Tony-LeoN/LLM-CADCoder/DataFlow/README.md

# DataFlow Stage Contract

`DataFlow` stores generated artifacts, not source code. Keep source code under `src/vlm_cadcoder`.

For stage-by-stage processing commands, see [`COMMANDS.md`](COMMANDS.md).

## Stages

1. `01.RawPDFWithSTEP`
   - Input PDF drawings and paired STEP/STP ground truth.
   - File stems should match when possible.

2. `02.RawPNG`
   - Rendered PDF pages.
   - Each sample should contain `page_001_600dpi.png` and `page_001_600dpi.meta.json`.

3. `03.LayoutAnalysis`
   - Page-level layout results: title blocks, notes, removable tables, page borders, inner frame strips, and corner metadata boxes.

4. `04.CleanPNG`
   - Cleaned page or view images after denoising, binarization, or annotation removal.
   - The first implementation keeps the original page size and whites out removable layout regions.
   - Removed regions should still be preserved as crops when they contain useful manufacturing knowledge, such as hole tables or title blocks.

5. `05.ViewDetection`
   - Detected view bounding boxes and view-region metadata.

6. `06.SingleViews`
   - Cropped views.
   - Prefer three layers per view: `raw_view_with_annotations.png`, `clean_view_with_annotations.png`, and `geometry_core.png`.
   - `geometry_core.png` is generated by the external `SketchPic2ViewPic` U-Net inference project through the LLM-CADCoder wrapper, rather than by copying that project into this repository.
   - Keep `geometry_core_mask.png`, `geometry_core_prob.png`, and `geometry_core.meta.json` when available for debugging and later ablation.
   - `geometry_core_repaired.png`, `geometry_core_repair_overlay.png`, and `geometry_core_repair.meta.json` are optional topology-repair MVP outputs for small horizontal/vertical gaps and tiny fragments. They do not overwrite `geometry_core.png`.
   - `geometry_core_primitive_repaired.png`, `primitive_repair_overlay.png`, and `primitive_candidates.json` are optional primitive-repair candidate outputs. The default mode only enables conservative `circle_arc` repair; `line` repair is available for ablation. Rejected rectangle candidates are recorded to avoid preserving annotation/detail frames as CAD geometry.
   - `geometry_core_audit.csv`, `geometry_core_audit.json`, and `geometry_core_audit_contact_sheet.png` provide quality gates before `08.Multi-viewFeatureExtraction`.
   - `geometry_core_audit_overrides.json` stores reproducible manual exclusions and quality-tier corrections for stale views or visually inspected geometry-core outputs.
   - `testView2CAD/` may store externally cropped view samples for downstream prototype tests. These samples can be used to bypass `05.ViewDetection` temporarily and test DrawingIR/CadQuery generation, but they must be marked as external crops and should not be used as evidence for automatic view detection performance.

7. `07.ViewClassification`
   - View labels: front, top, left/right side, section, detail, isometric, unknown.
   - The first implementation is a heuristic baseline from view bbox geometry and page position. It first filters `06.SingleViews` crops by accepted bboxes in `05.ViewDetection`, records unmatched crops as `skipped_views`, and is meant for manual review and VLM comparison, not final ground truth.

8. `08.Multi-viewFeatureExtraction`
   - Formal output: `<sample>/view_features.json` plus batch summary CSV/JSON.
   - The current MVP reads `10.StructuredCADRepresentation/<sample>/drawing_ir.json` and promotes low-level `geometry_component` bboxes into conservative semantic candidates such as `outer_profile_candidate`, `hole_candidate`, `slot_candidate`, `annotation_residue_candidate`, and `unknown_geometry_candidate`.
   - These are reviewable candidates, not final CAD feature truth. Every candidate keeps its source component id, bbox, page bbox, metrics, evidence, and `needs_manual_review=true`.
   - Current 08 candidates are still derived from DrawingIR low-level components, not from primitive-repair outputs. Primitive repair is a sidecar artifact for quality analysis and future ablation.
   - `dimension_candidates.json` is generated by the `extract-dimensions` MVP from DrawingIR view provenance and `dimension_ocr` prediction JSONL files. It stores reviewable dimension text candidates with normalized text, type, optional bbox, page bbox, parsed quantity/value/tolerance, and source provenance.
   - Dimension candidates are not yet bound to geometry. The next stage is `bind-dimensions-to-geometry`.

9. `09.Cross-viewGeometricReasoning`
   - Cross-view correspondences and candidate modeling base plane.

10. `10.StructuredCADRepresentation`
   - DrawingIR, ConstraintGraph, and ModelingIR JSON artifacts.
   - For the formal detected-view pipeline, `<sample>/drawing_ir.json` is generated from `05.ViewDetection`, `06.SingleViews`, `07.ViewClassification`, and `06.SingleViews/geometry_core_audit.json`.
   - Version `0.1.0` contains view-level provenance, per-view `geometry_core` quality gates, and conservative low-level `geometry_component` candidates from A-tier geometry-core images. Dimensions in DrawingIR remain empty in the formal pipeline; dimension candidates are stored under `08.Multi-viewFeatureExtraction` until binding is implemented. Validated CAD features, constraints, and view relations remain downstream tasks.
   - For the external-crop prototype, `testView2CAD/<sample>/external_crop_manifest.json`, `minimal_drawing_ir.json`, and `modeling_plan.json` are generated from external crops, clean images, VLM benchmark outputs, and paired STEP files.

11. `11.CADProgram`
   - Generated CadQuery/FreeCAD scripts, execution logs, and exported STEP/BREP models.
   - For the external-crop prototype, `testView2CAD/<sample>/cadquery_generation_prompt.md` is generated before executable CadQuery code. This prompt is a controlled bridge from minimal DrawingIR to a reviewed CadQuery script.
   - `cadquery_parameters.json` and `cadquery_draft.py` are prototype artifacts. They may be executable, but parameters marked as `needs_review` must not be treated as final drawing-derived constraints.

## Current Implementation Status

As of 2026-06-17, the implemented pipeline has reached a first reproducible baseline for:

```text
01 -> 02 -> 03/04 -> 05 -> 06
06 -> geometry_core -> repair / primitive repair / audit
06 -> 07
07 + geometry_core audit -> 10
10 -> 08
external crops -> 10/11 prompt -> 11 prototype scripts
```

The current research stage is still drawing understanding and intermediate representation extraction. The implemented `geometry_core` repair and primitive repair modules are quality-control and candidate-generation sidecars. They should support manual review, ablation, and future feature recognition, but they are not yet final CAD feature recognition or final constraint inference.

## Coordinate Convention

All image-space annotations should use:

```text
image_xy_top_left
x increases rightward
y increases downward
bbox = [x1, y1, x2, y2]
```

Keep the render metadata for coordinate transforms between PDF points and image pixels.

## Layout Cleaning MVP

The first layout module is rule based and targets page-level cleanup before view detection:

```text
RawPNG full page
-> black long-line extraction
-> connected line-component grouping
-> page-frame and table-component classification
-> near-edge inner-frame and sparse corner-box detection
-> layout JSON + removed-region crops
-> full-size clean PNG
```

Current removable region types:

- `page_border`: outer frame, coordinate-grid strips, and page-edge lines
- `hole_table`: left-side hole/coordinate table
- `title_or_tolerance_table`: bottom title block and general tolerance tables
- `revision_table`: top-right revision table
- `technical_requirements`: bottom-left technical requirement text block
- `inner_frame_strip`: near-edge inner drawing frame strips that are not part of a drawing view
- `corner_metadata_box`: sparse left-top or right-top page metadata boxes, such as drawing number, first-angle symbol, projection marker, or default roughness area

The clean image should mainly preserve drawing views and view-related annotations: dimensions, leader callouts, surface roughness callouts, geometric tolerances, and local view notes. Detected tables, corner metadata boxes, and page-level text/table blocks may be removed from the clean page when they are classified as non-view regions; regions with useful semantics are preserved as typed crops in `03.LayoutAnalysis/<sample>/regions`, so later stages can still extract richer drawing metadata from title blocks, revision tables, hole tables, tolerance tables, corner metadata, and technical notes. The technical-requirements detector is still experimental and should not be treated as a stable dependency.

The detector classifies each connected long-line component independently. It should not merge every line inside a fixed left, bottom, or top-right window, because nearby dimensions and view outlines can otherwise be swallowed by an oversized removable region. Bottom tables are classified by bottom-edge location, grid strength, width, and area rather than a fixed x-start threshold, because title blocks may start from the left, center, or right side of the sheet.

The current lightweight enhancement does not yet perform full planar ring tracing. It adds targeted rules for two recurring failure modes before view detection: long inner frame strips near the page margin, and sparse corner metadata boxes that do not have enough grid density to be classified as normal tables.

Example command:

```bash
python -m vlm_cadcoder.cli clean-layout \
  --image DataFlow/LayoutSamples/raw_img/2023-2024-1-335.png \
  --sample-id 2023-2024-1-335 \
  --dataflow-root DataFlow
```

Expected outputs:

```text
DataFlow/03.LayoutAnalysis/<sample_id>/page_001_layout.json
DataFlow/03.LayoutAnalysis/<sample_id>/page_001_overlay.png
DataFlow/03.LayoutAnalysis/<sample_id>/regions/*.png
DataFlow/04.CleanPNG/<sample_id>/page_001_clean.png
DataFlow/04.CleanPNG/<sample_id>/page_001_remove_mask.png
```
