Tony-LeoN/LLM-CADCoder/DataFlow/LayoutSamples/main_img/2023-2024-1-2187.png

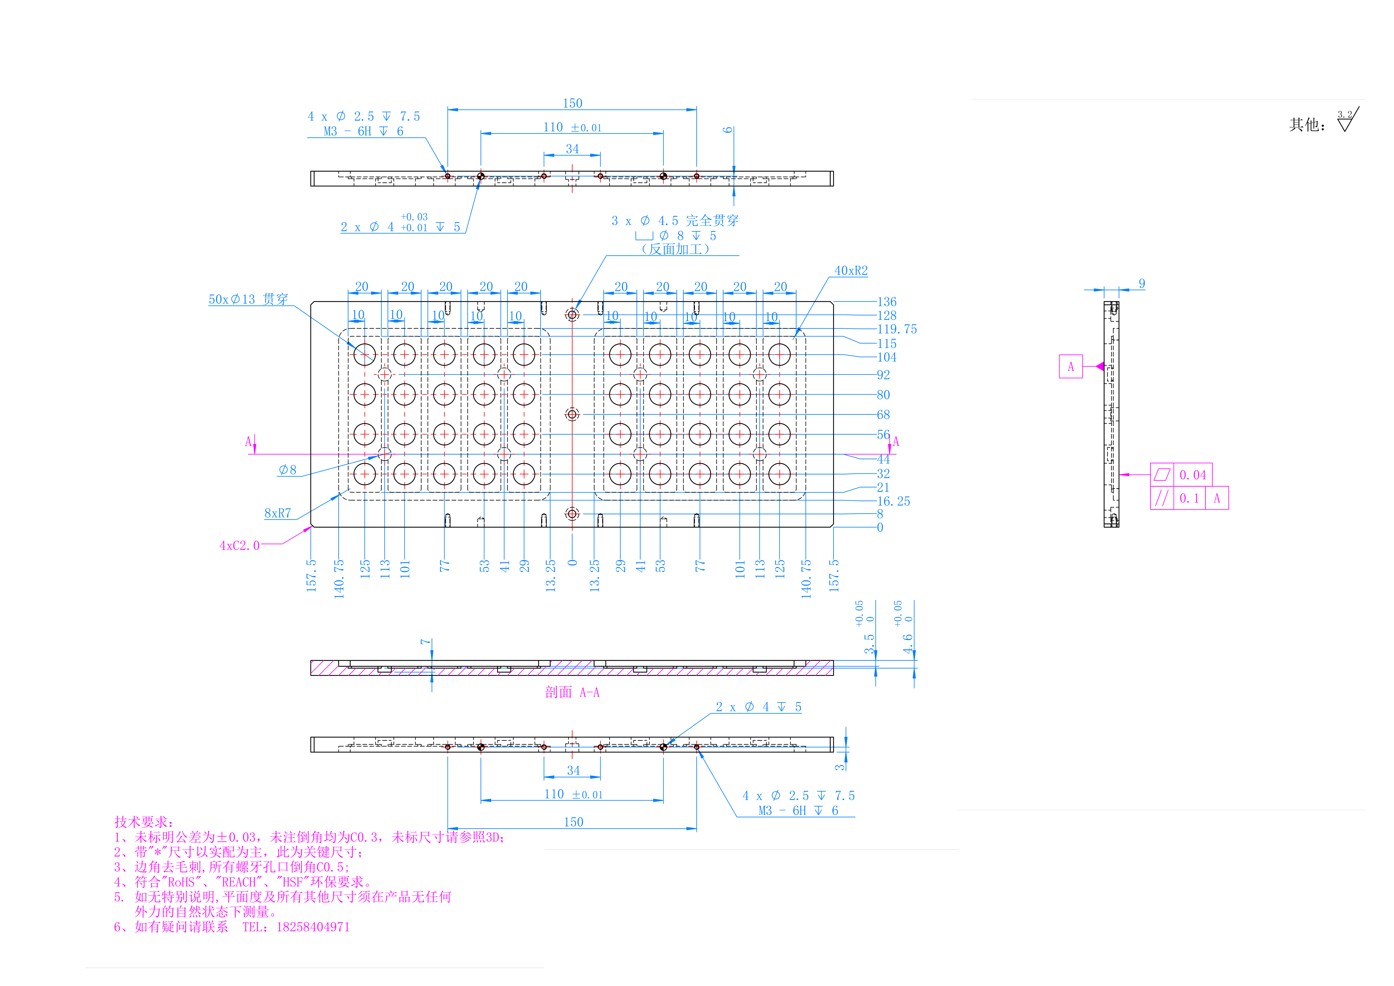
DataFlow/LayoutSamples/main_img/2023-2024-1-2187.png
