Tony-LeoN/LLM-CADCoder/DataFlow/LayoutSamples/main_img/2023-2024-4-195.png

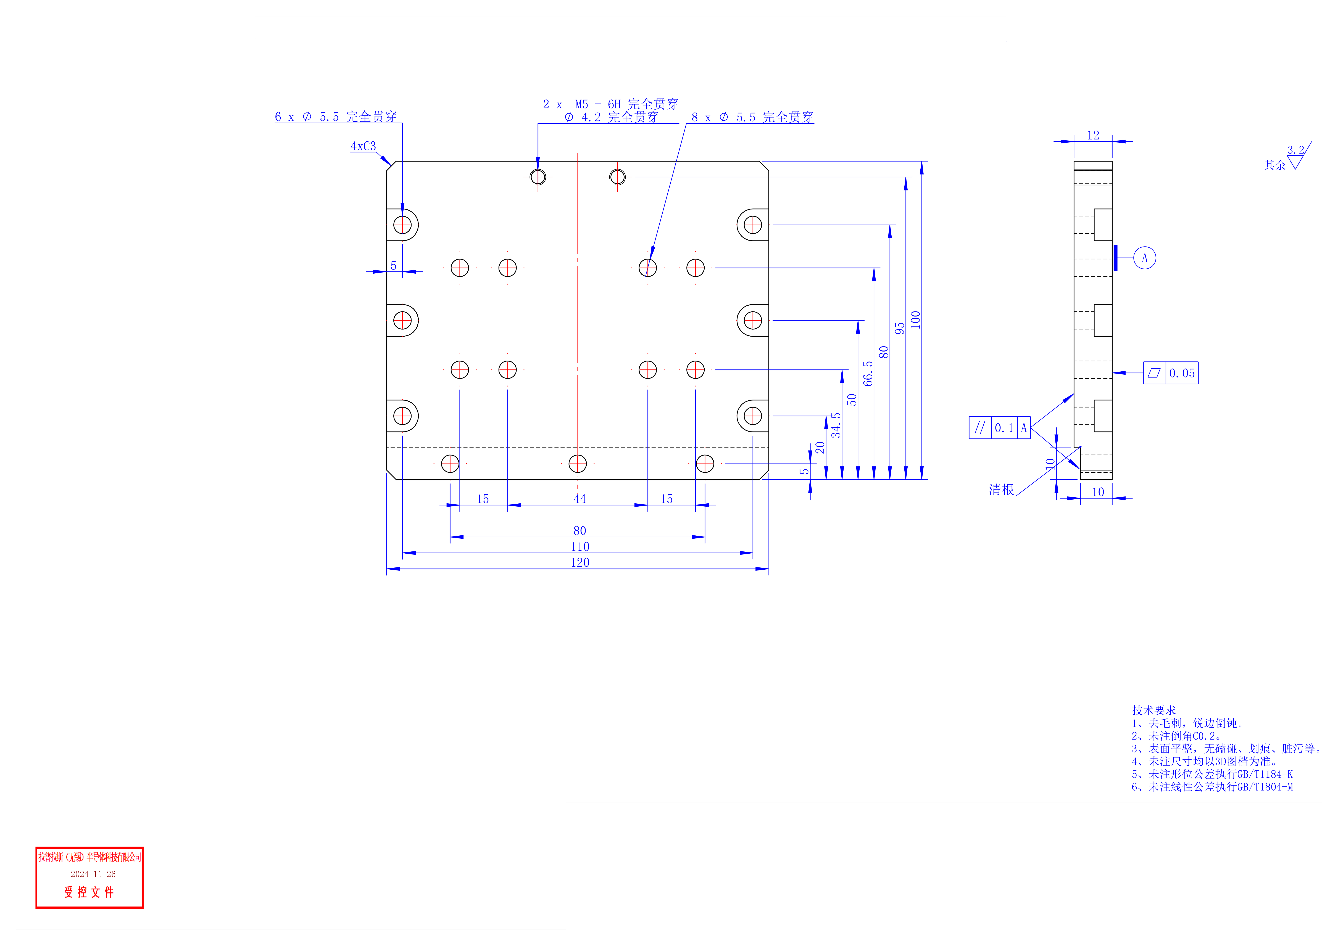
DataFlow/LayoutSamples/main_img/2023-2024-4-195.png
