Tony-LeoN/LLM-CADCoder/DataFlow/LayoutSamples/main_img/2023-2024-4-342.png

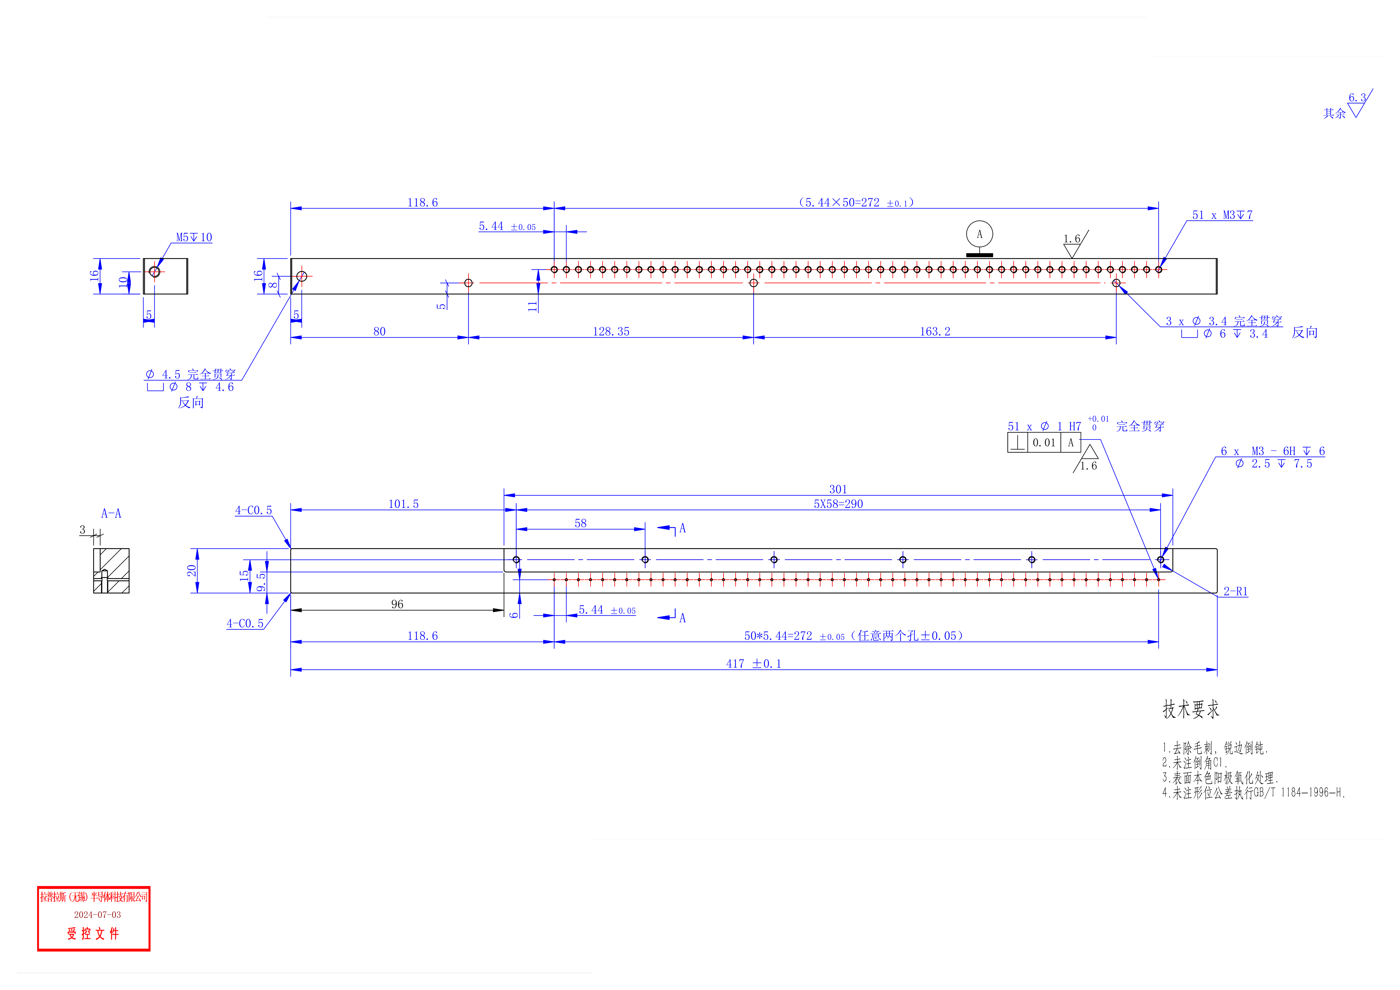
DataFlow/LayoutSamples/main_img/2023-2024-4-342.png
