Tony-LeoN/LLM-CADCoder/DataFlow/LayoutSamples/main_img/2023-2024-6-141.png

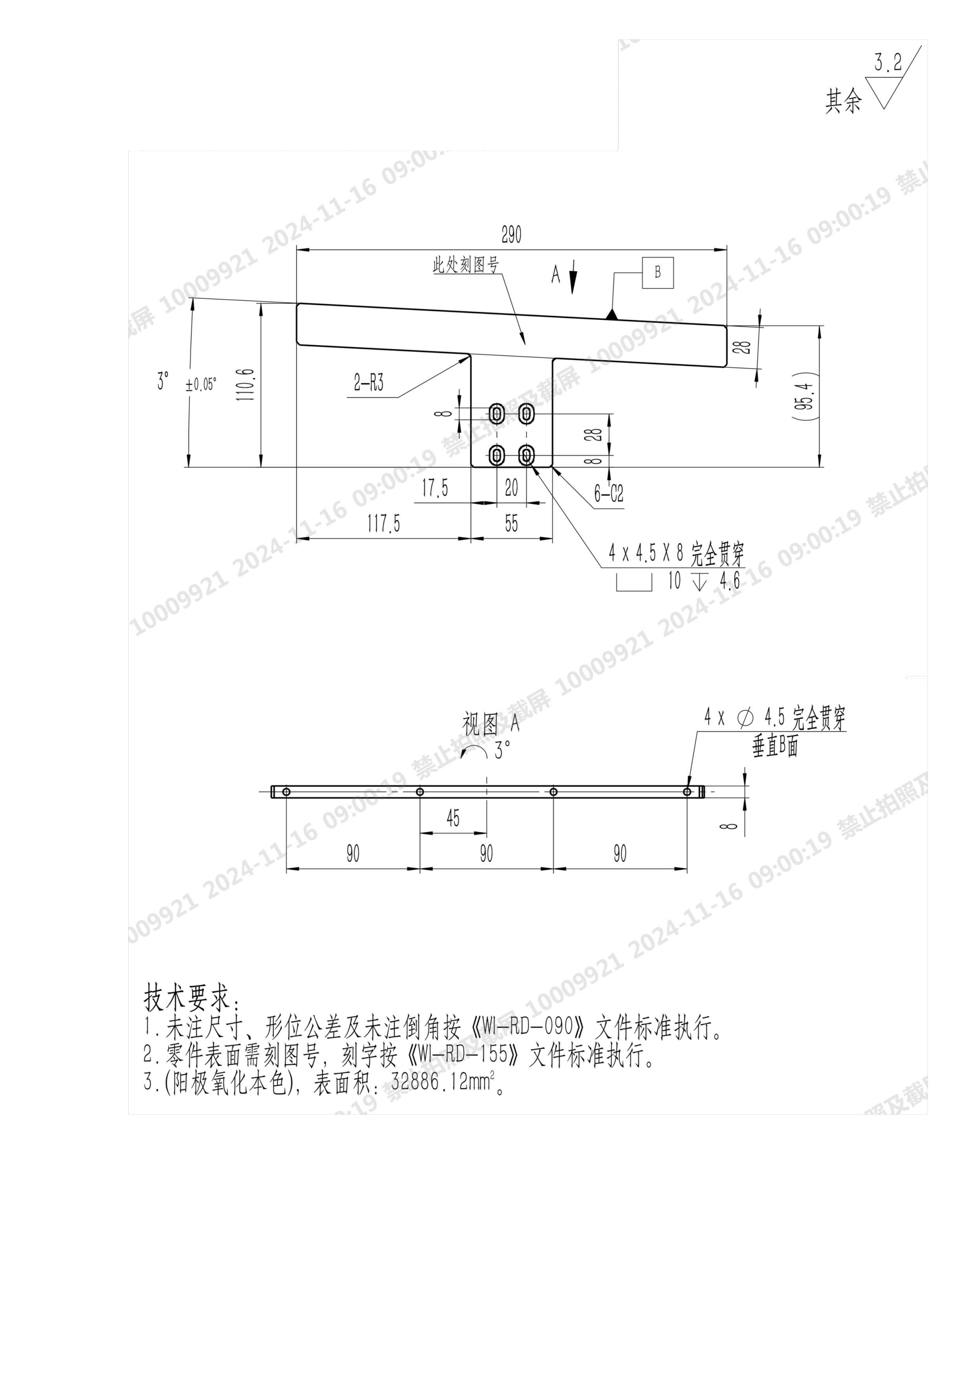
DataFlow/LayoutSamples/main_img/2023-2024-6-141.png
