Tony-LeoN/LLM-CADCoder/DataFlow/LayoutSamples/main_img/2023-2024-7-143.png

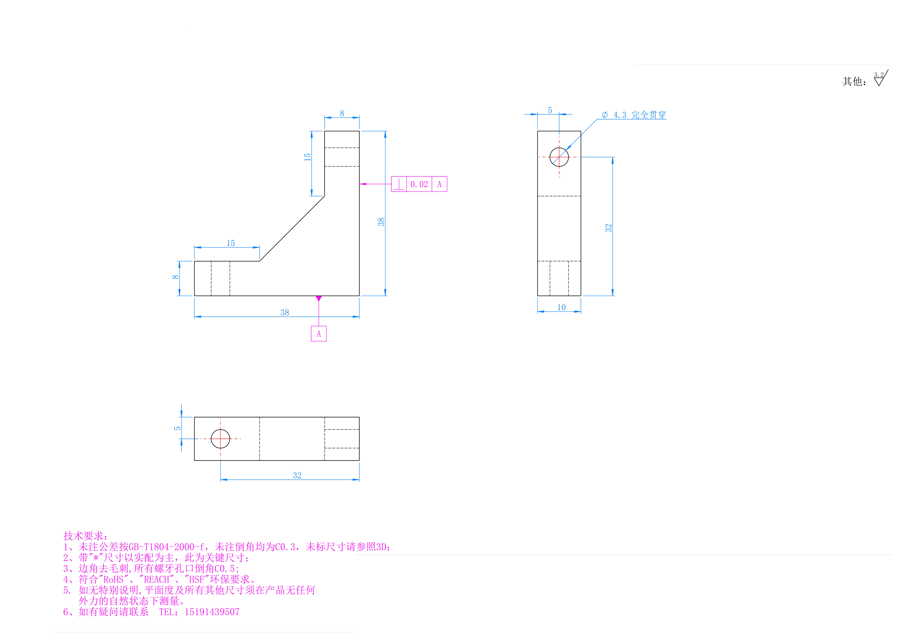
DataFlow/LayoutSamples/main_img/2023-2024-7-143.png
