Tony-LeoN/LLM-CADCoder/DataFlow/LayoutSamples/main_img/2023-2024-13-137.png

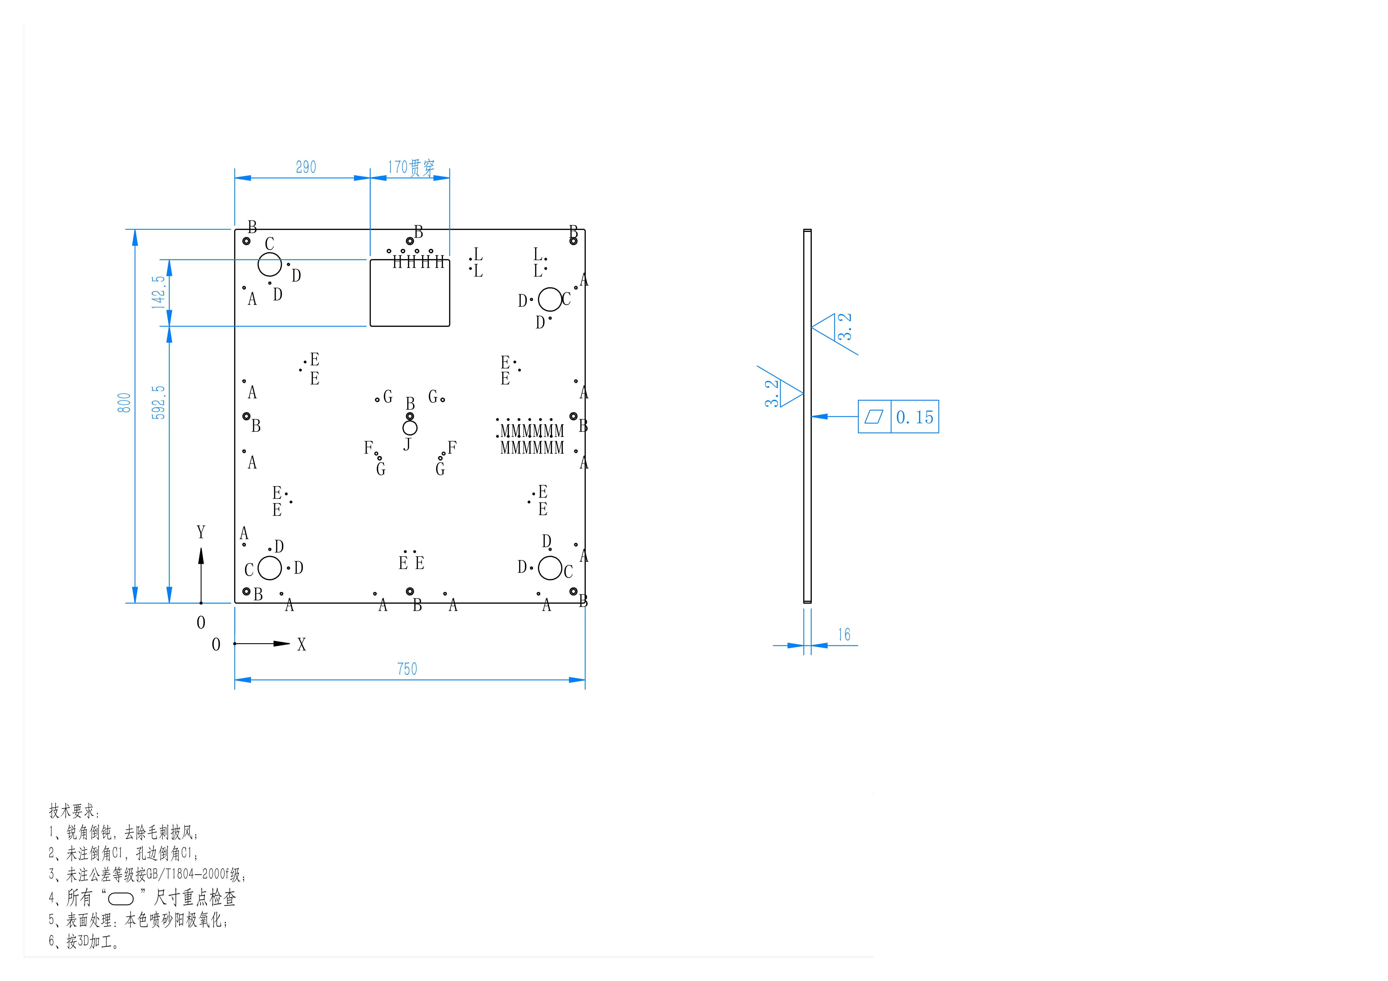
DataFlow/LayoutSamples/main_img/2023-2024-13-137.png
