Tony-LeoN/LLM-CADCoder/DataFlow/LayoutSamples/main_img/2023-2024-15-4.png

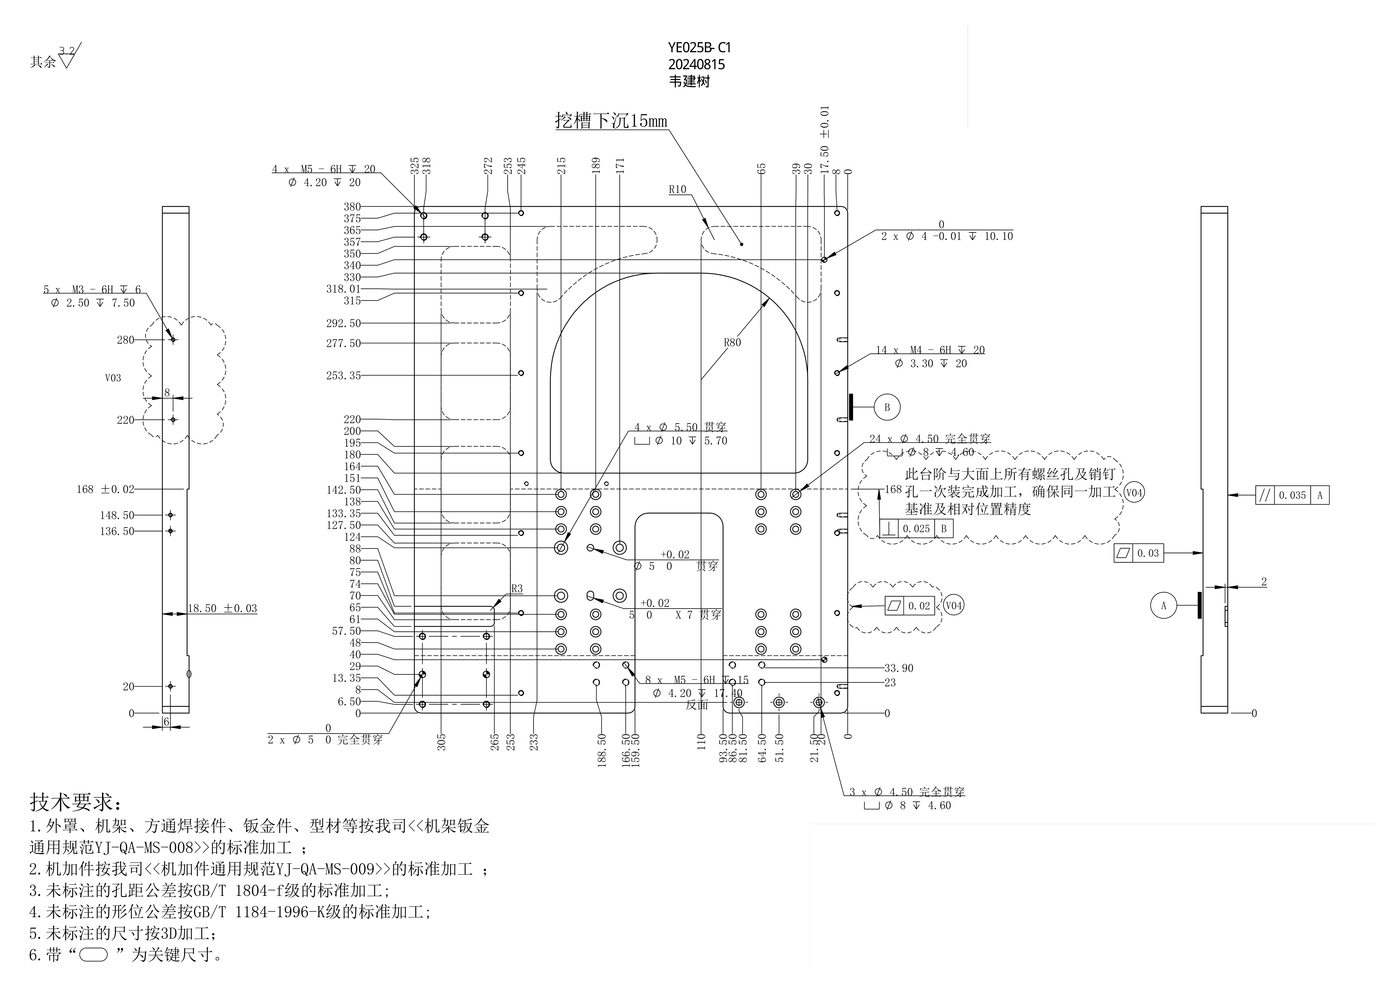
DataFlow/LayoutSamples/main_img/2023-2024-15-4.png
