Tony-LeoN/LLM-CADCoder/DataFlow/LayoutSamples/main_img/2023-2024-18-115.png

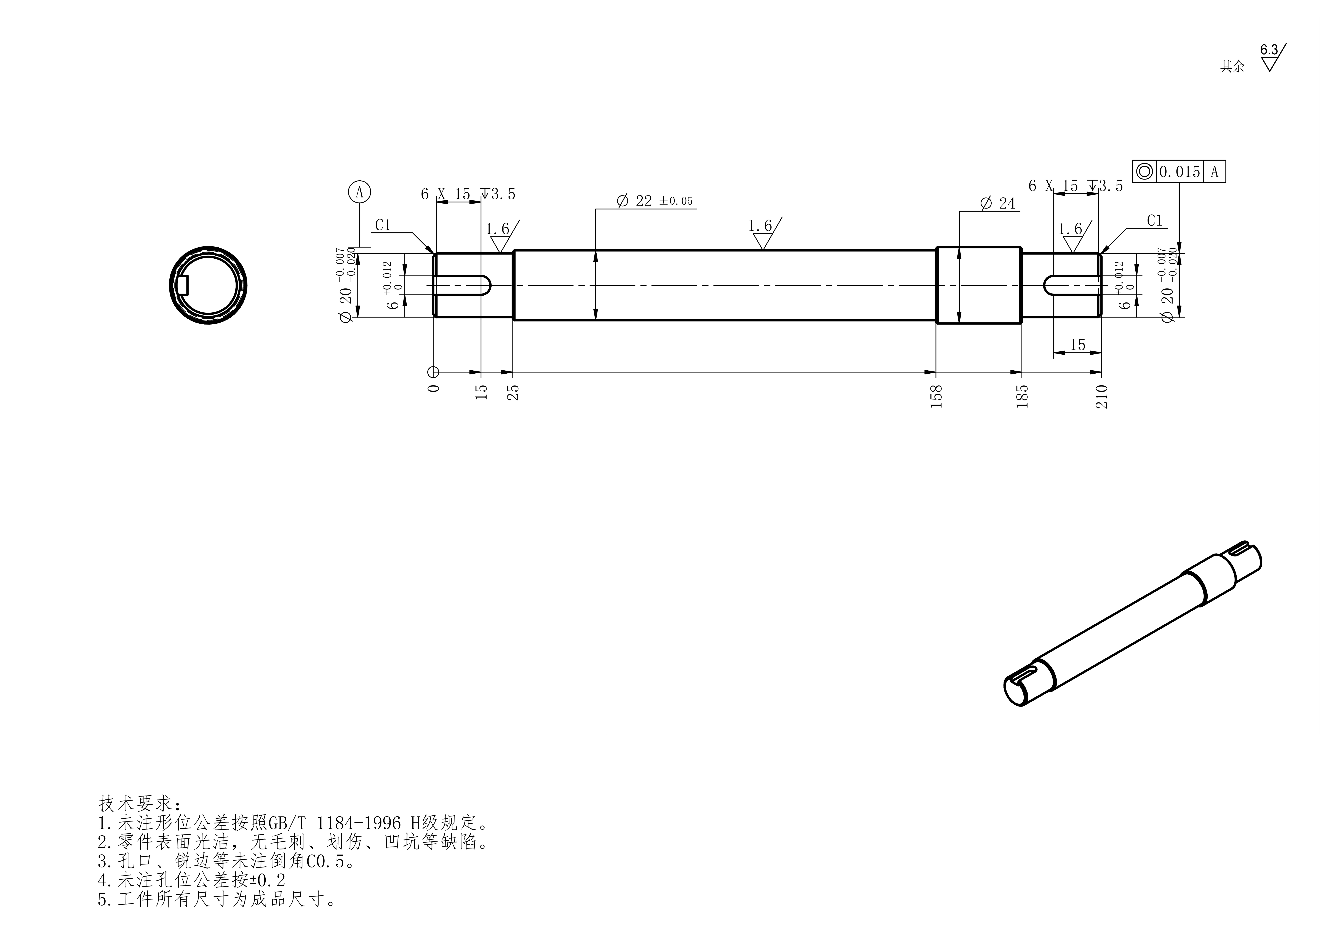
DataFlow/LayoutSamples/main_img/2023-2024-18-115.png
