Tony-LeoN/LLM-CADCoder/DataFlow/LayoutSamples/main_img/2023-2024-19-55.png

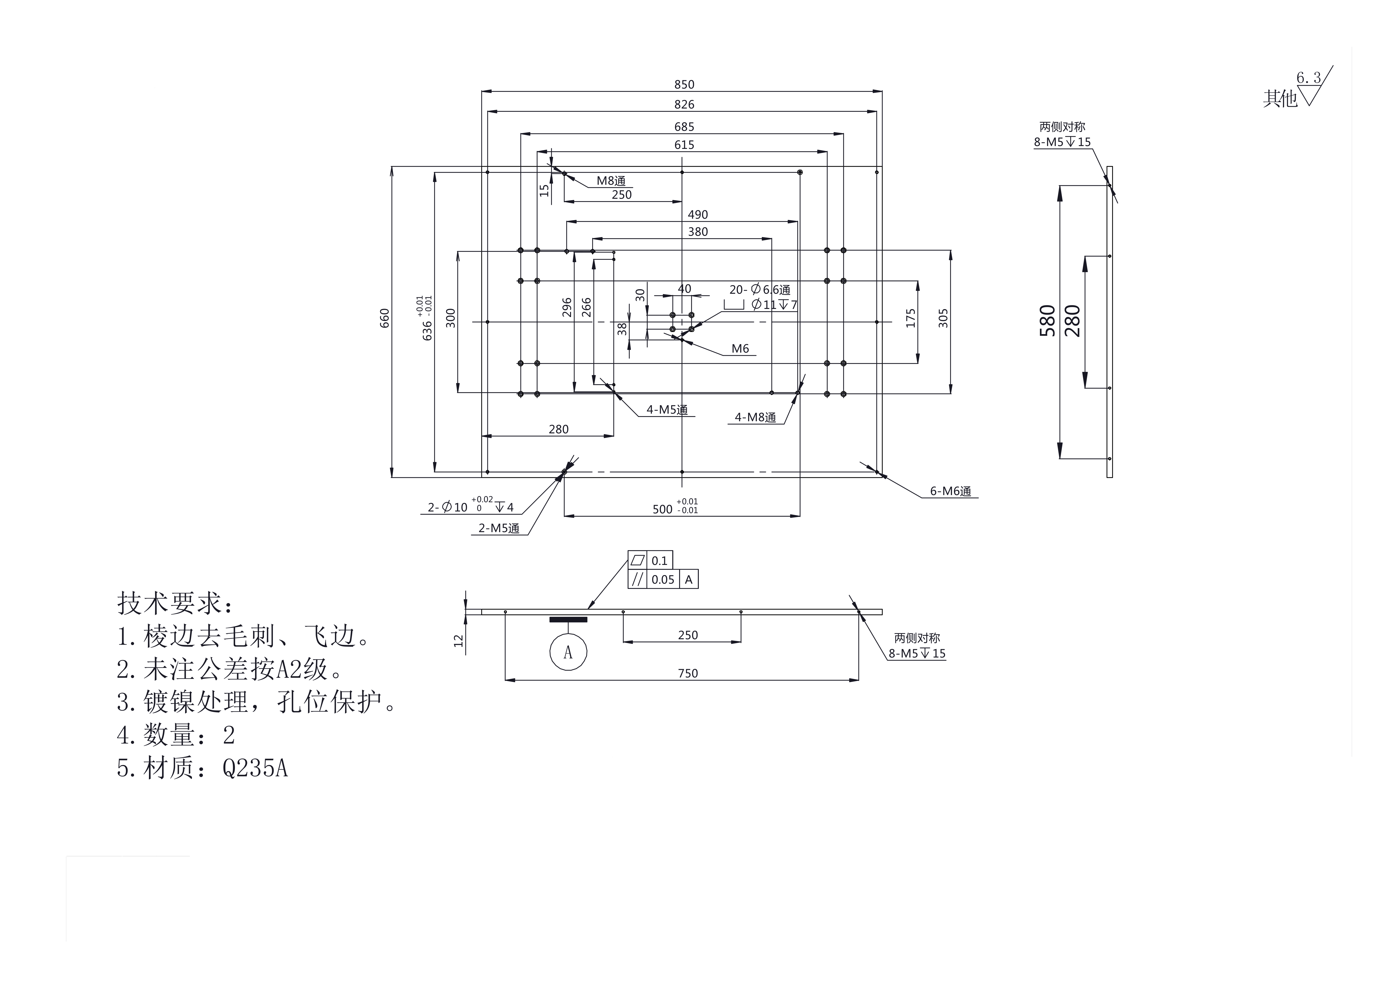
DataFlow/LayoutSamples/main_img/2023-2024-19-55.png
