Tony-LeoN/LLM-CADCoder/DataFlow/LayoutSamples/main_img/2023-2024-23-40.png

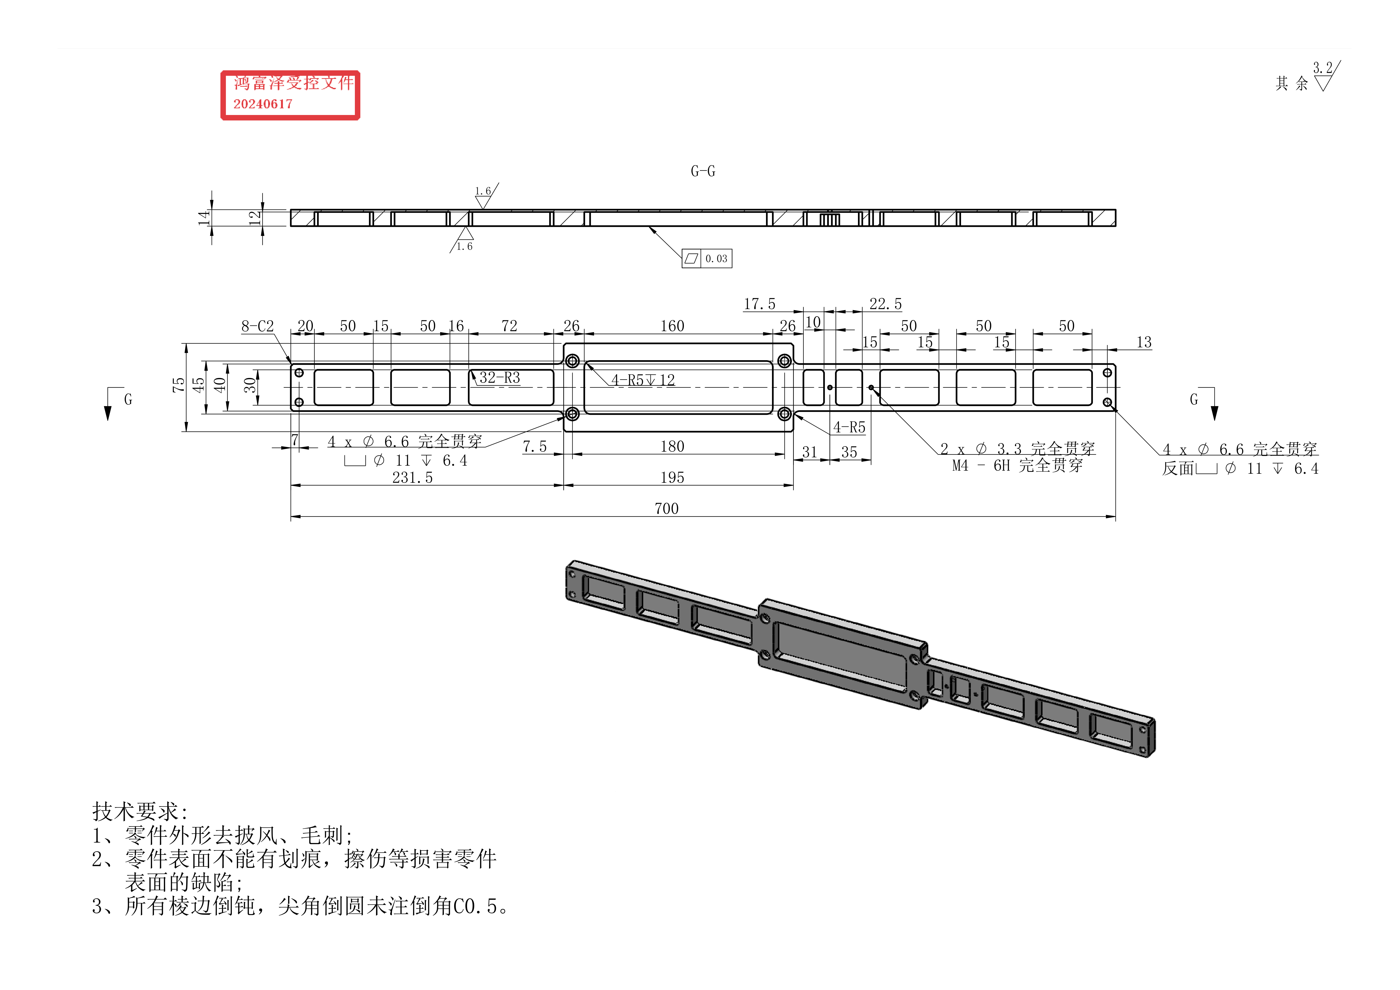
DataFlow/LayoutSamples/main_img/2023-2024-23-40.png
