Tony-LeoN/LLM-CADCoder/DataFlow/LayoutSamples/main_img/2023-2024-23-105.png

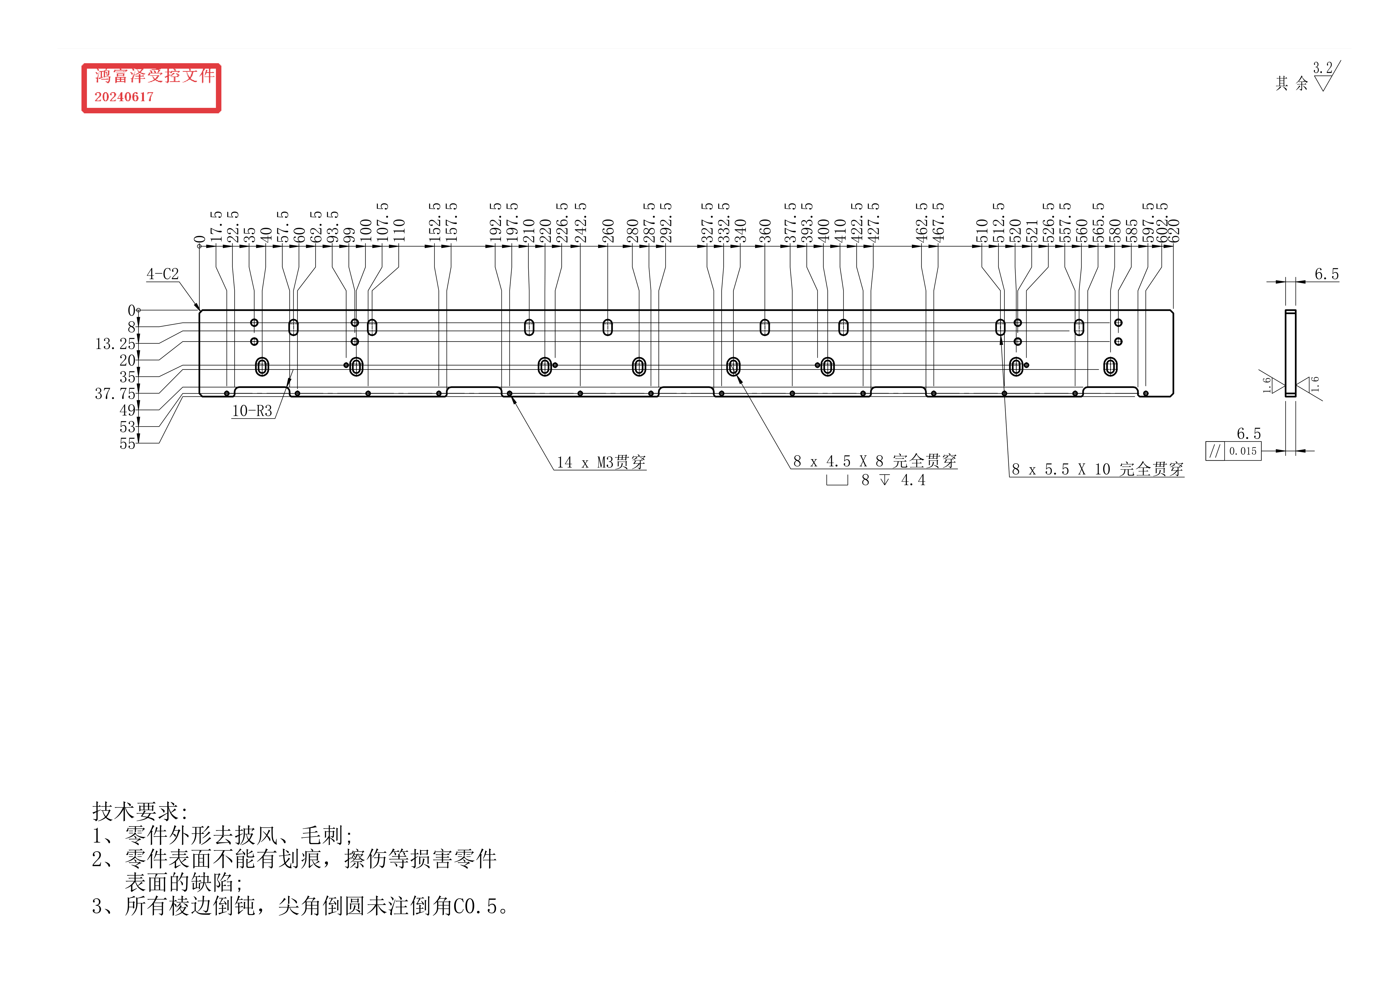
DataFlow/LayoutSamples/main_img/2023-2024-23-105.png
