Tony-LeoN/LLM-CADCoder/DataFlow/LayoutSamples/main_img/2023-2024-26-30.png

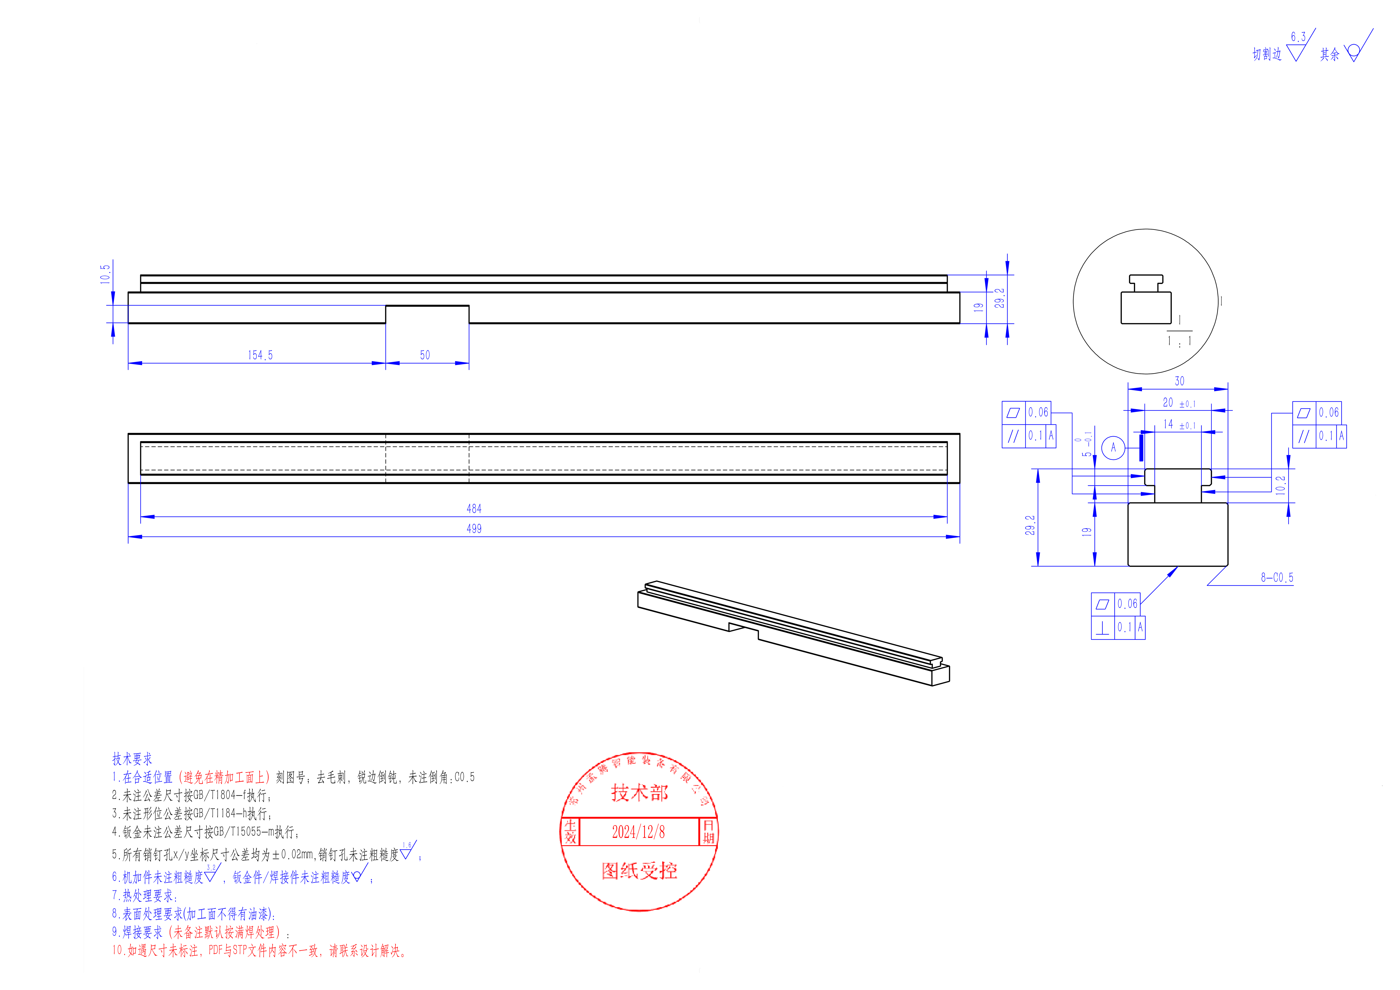
DataFlow/LayoutSamples/main_img/2023-2024-26-30.png
