Tony-LeoN/LLM-CADCoder/DataFlow/LayoutSamples/main_img/2023-2024-31-104.png

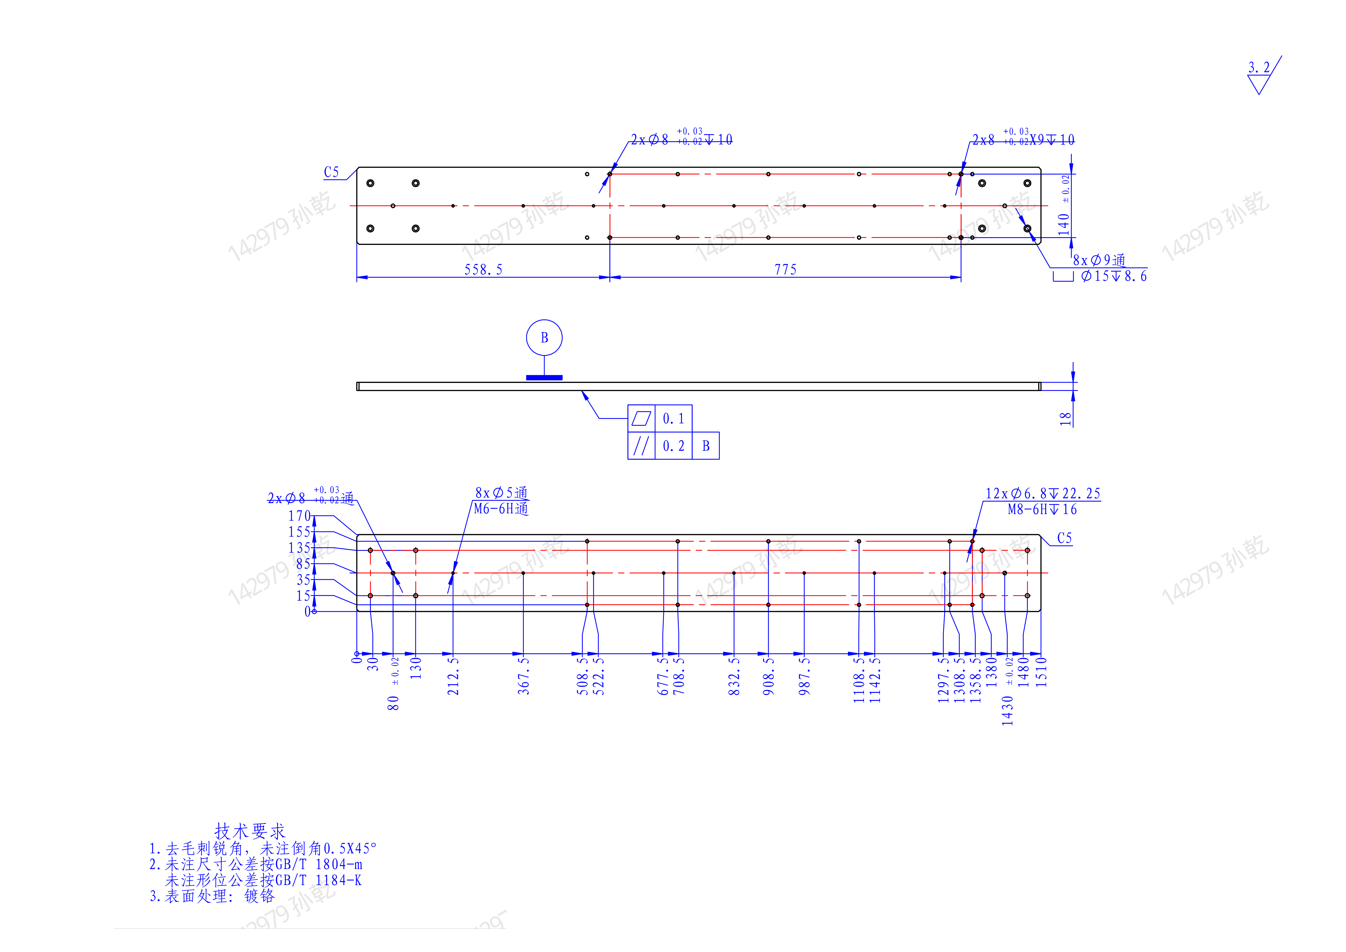
DataFlow/LayoutSamples/main_img/2023-2024-31-104.png
