Tony-LeoN/LLM-CADCoder/DataFlow/LayoutSamples/main_img/2023-2024-31-117.png

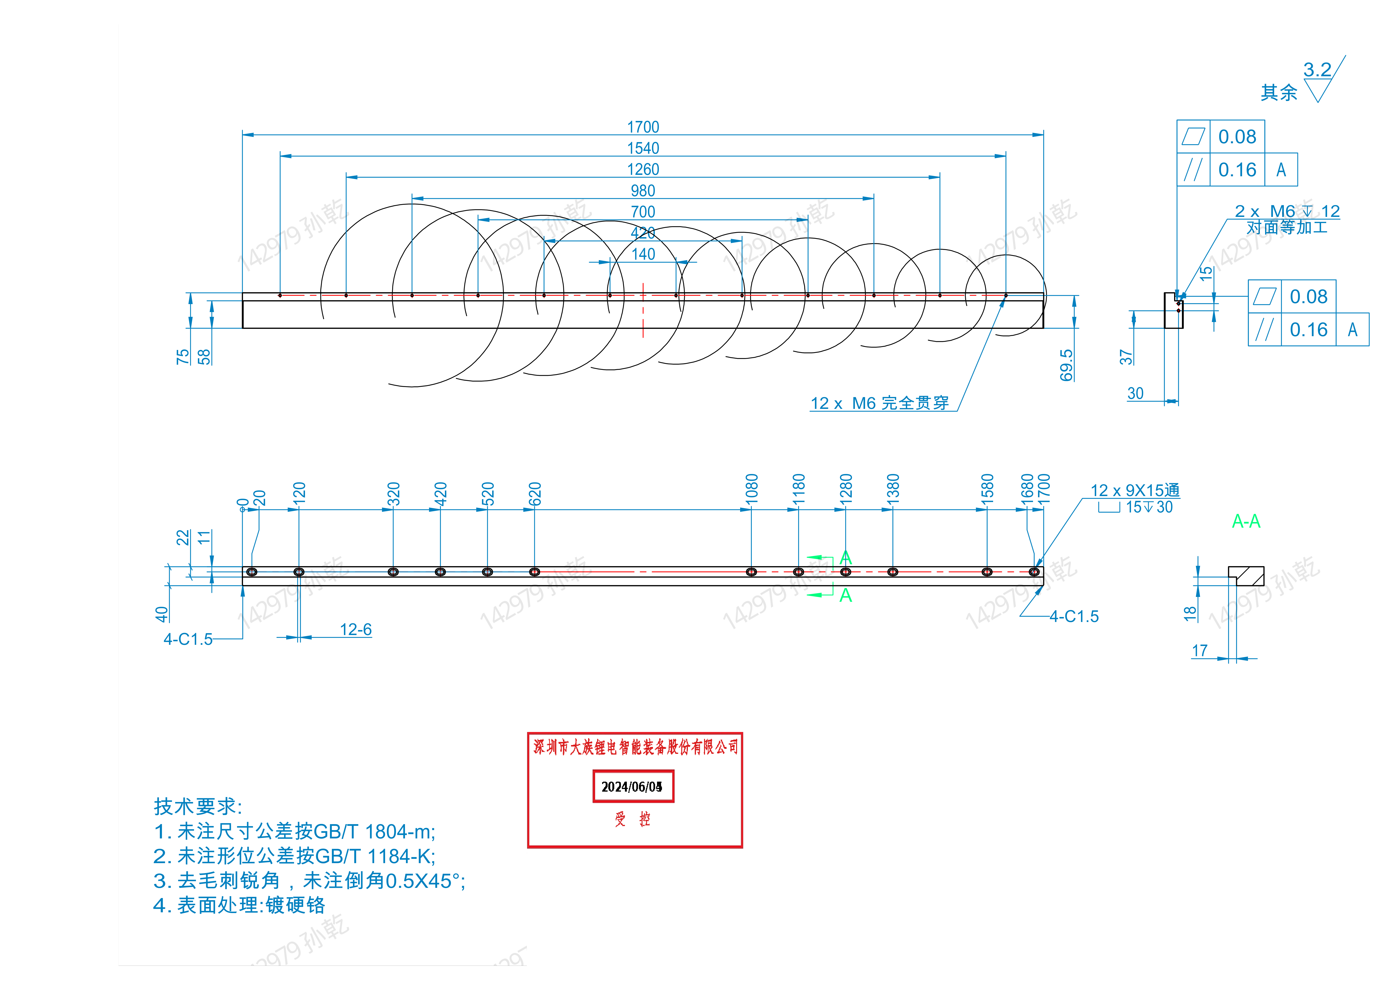
DataFlow/LayoutSamples/main_img/2023-2024-31-117.png
