Tony-LeoN/LLM-CADCoder/DataFlow/LayoutSamples/main_img/2023-2024-31-119.png

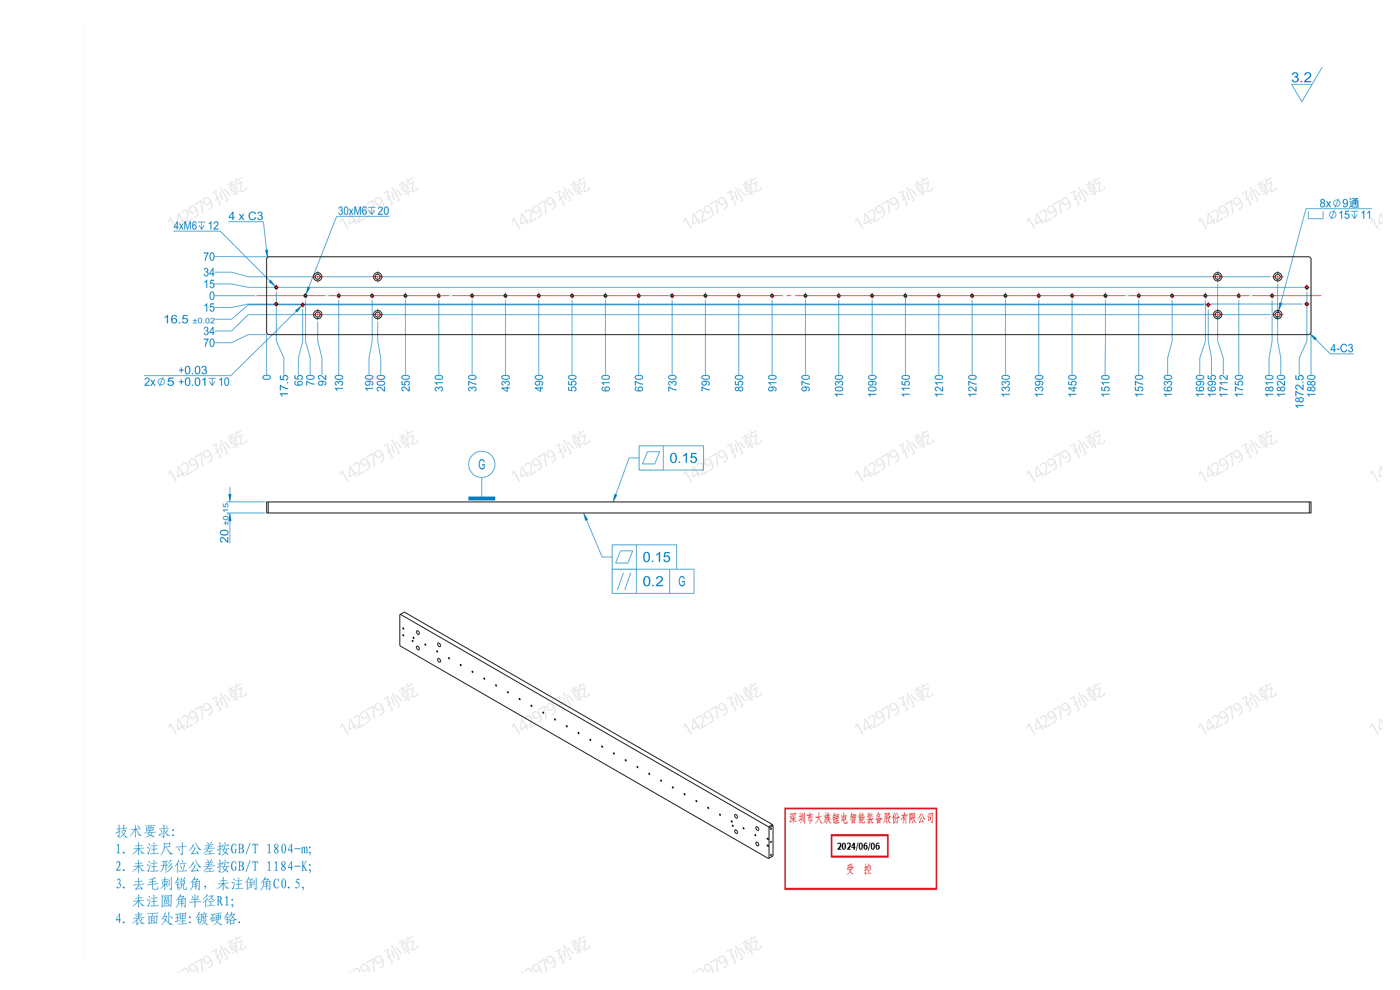
DataFlow/LayoutSamples/main_img/2023-2024-31-119.png
