Tony-LeoN/LLM-CADCoder/DataFlow/LayoutSamples/main_img/2023-2024-38-11.png

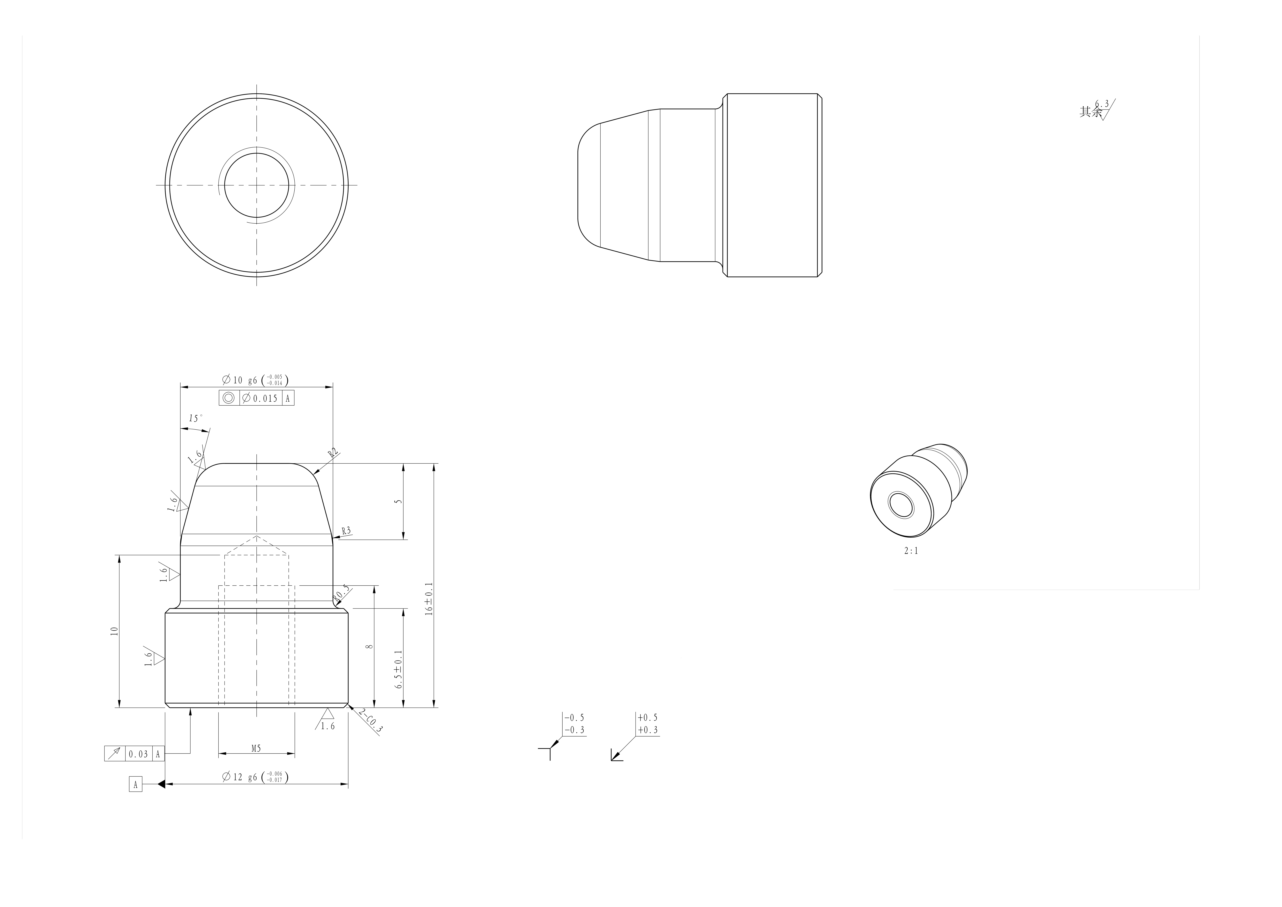
DataFlow/LayoutSamples/main_img/2023-2024-38-11.png
