Tony-LeoN/LLM-CADCoder/DataFlow/LayoutSamples/main_img/2023-2024-38-19.png

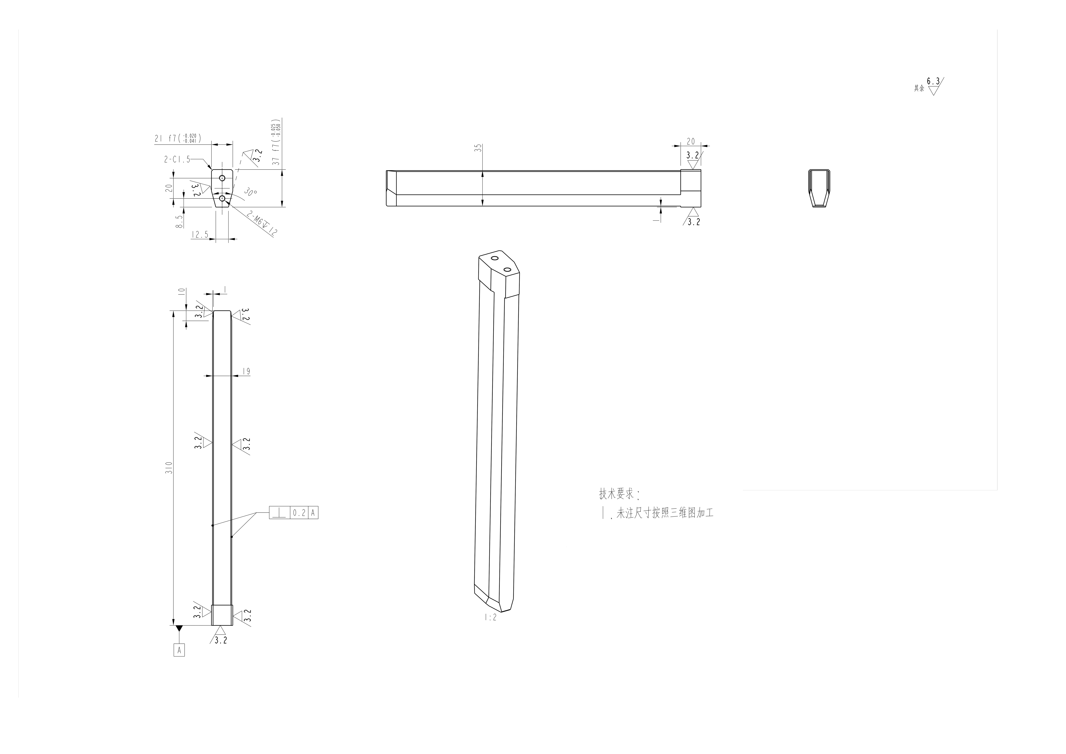
DataFlow/LayoutSamples/main_img/2023-2024-38-19.png
