Tony-LeoN/LLM-CADCoder/DataFlow/LayoutSamples/main_img/2023-2024-38-35.png

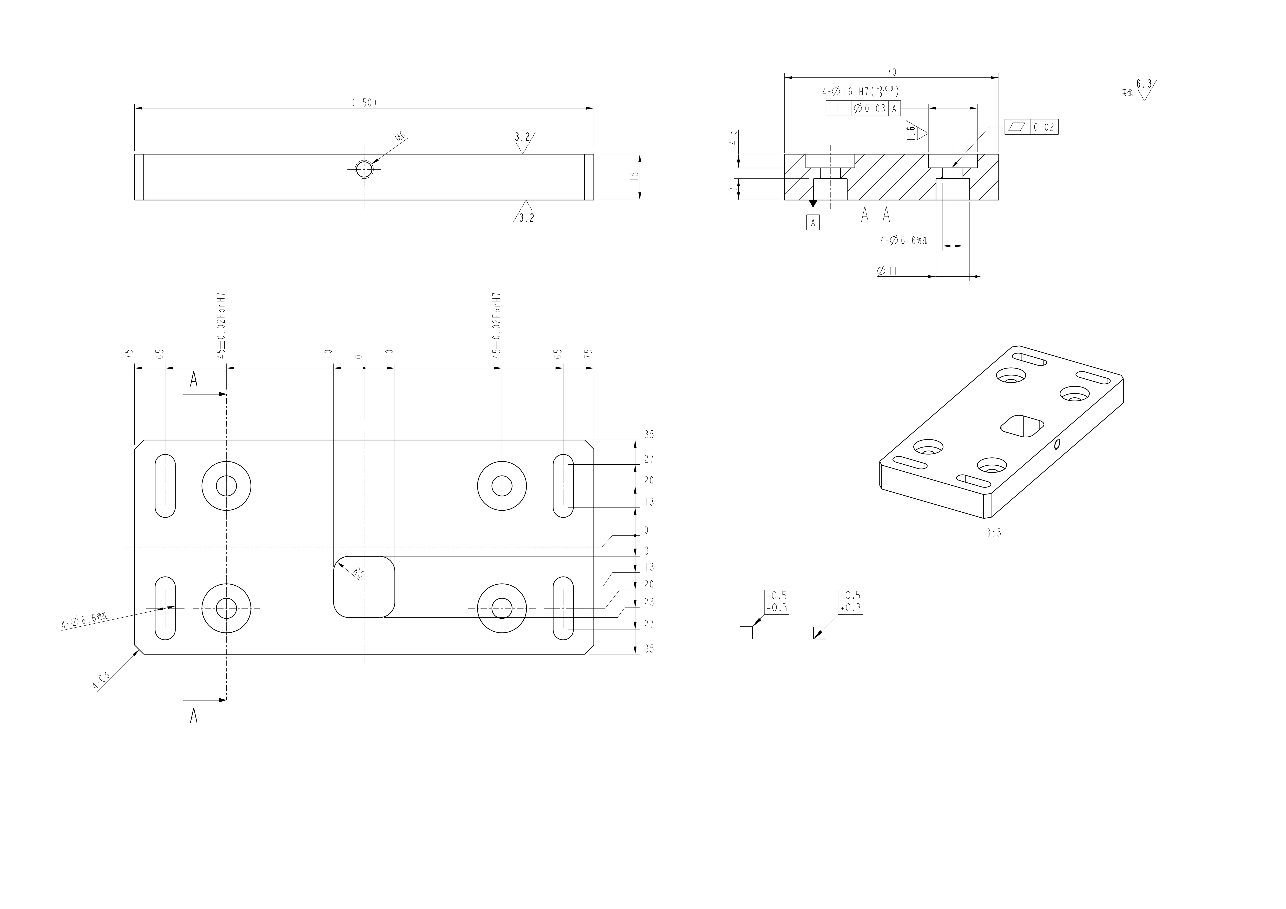
DataFlow/LayoutSamples/main_img/2023-2024-38-35.png
