Tony-LeoN/LLM-CADCoder/DataFlow/LayoutSamples/main_img/2023-2024-38-76.png

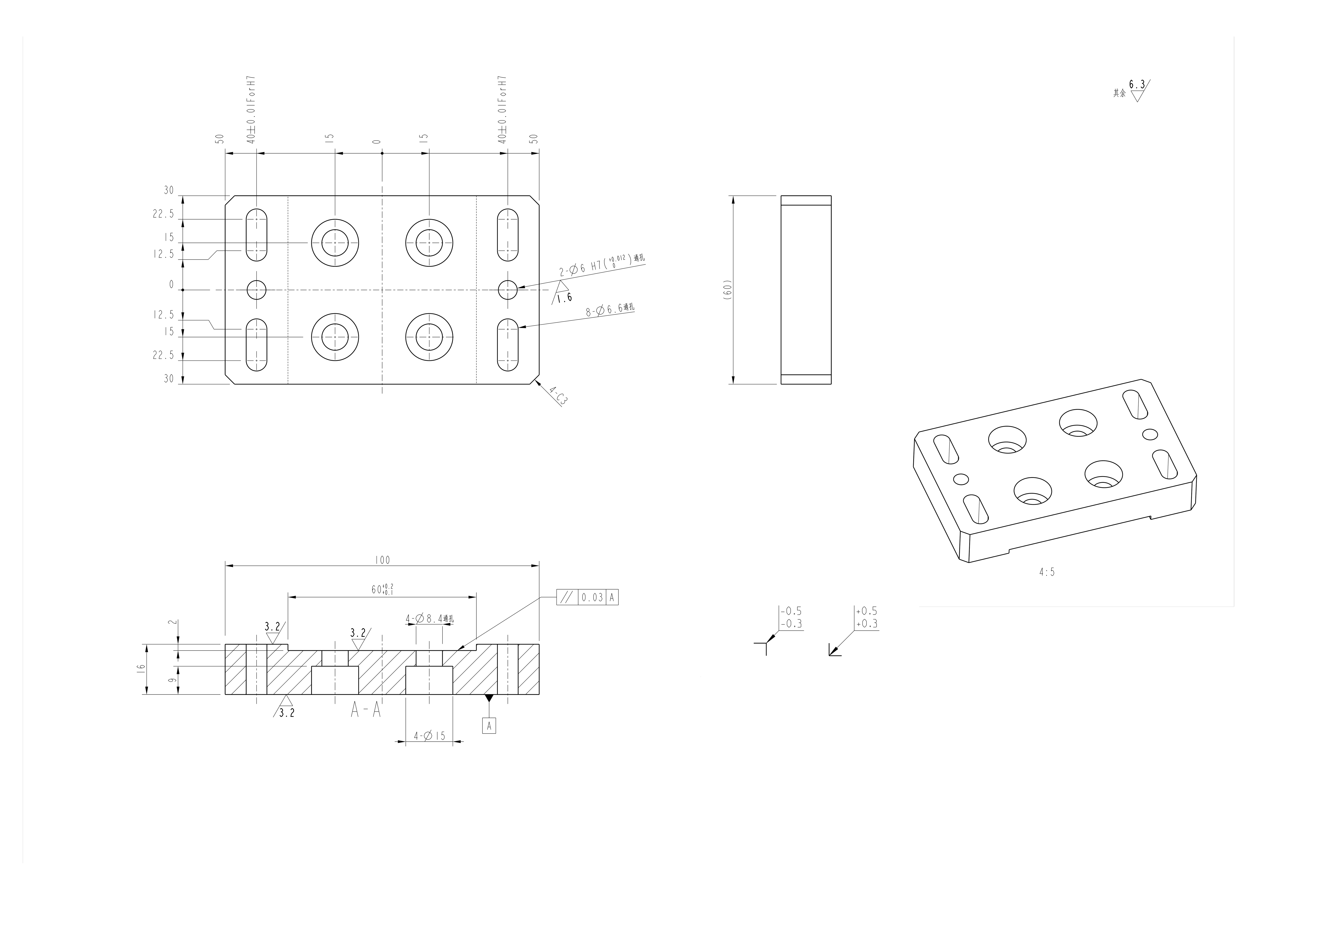
DataFlow/LayoutSamples/main_img/2023-2024-38-76.png
