Tony-LeoN/LLM-CADCoder/DataFlow/LayoutSamples/main_img/2023-2024-45-31.png

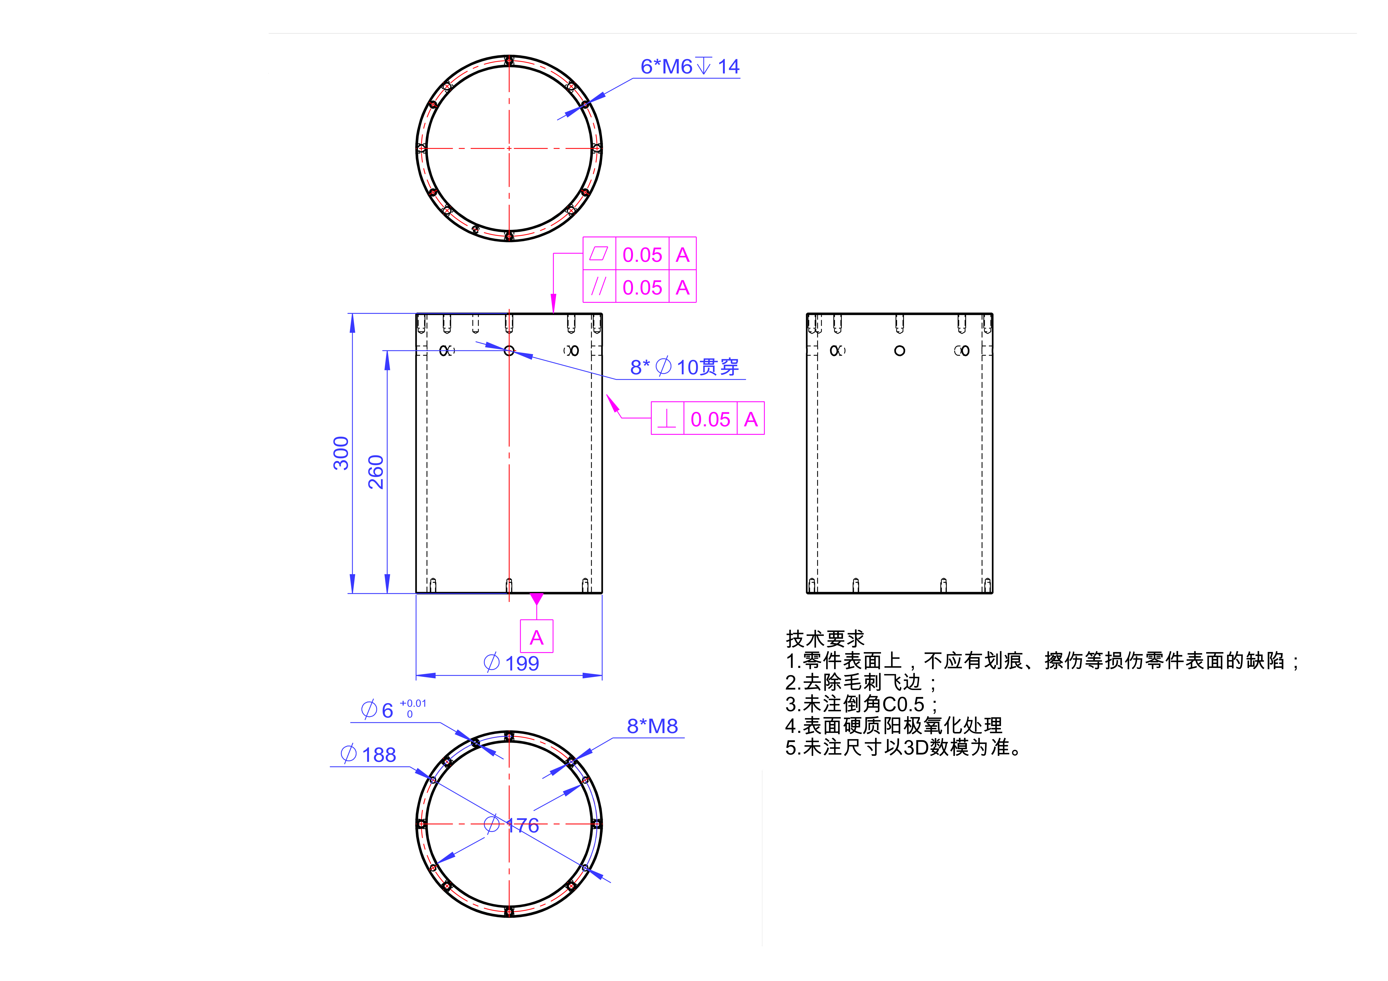
DataFlow/LayoutSamples/main_img/2023-2024-45-31.png
