Tony-LeoN/LLM-CADCoder/DataFlow/LayoutSamples/raw_img/2023-2024-1-1115.png

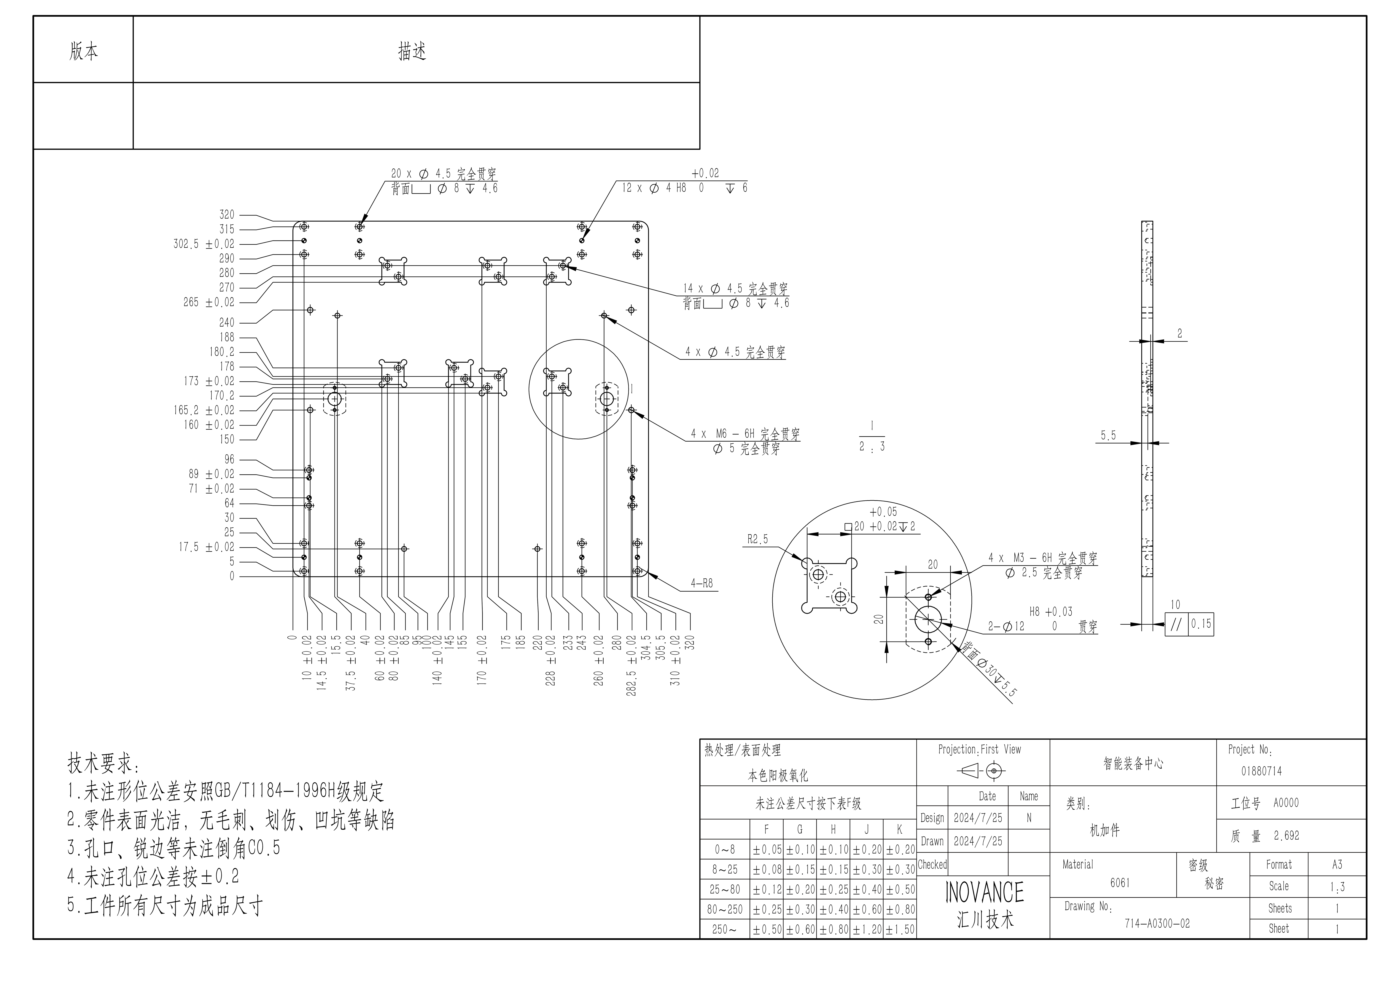
DataFlow/LayoutSamples/raw_img/2023-2024-1-1115.png
