Tony-LeoN/LLM-CADCoder/DataFlow/LayoutSamples/raw_img/2023-2024-1-3364.png

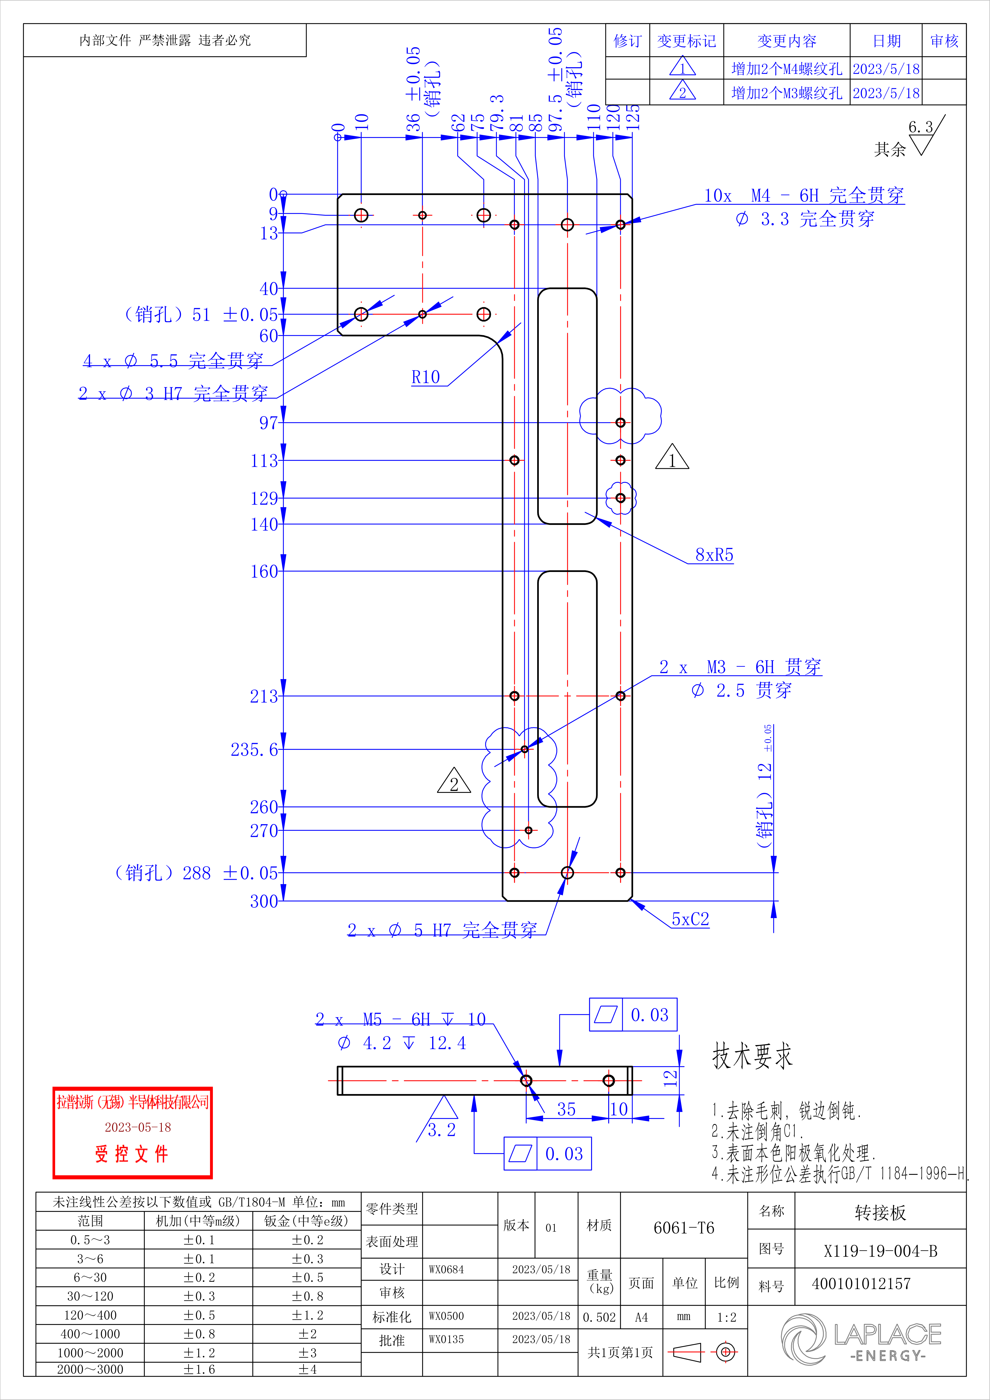
DataFlow/LayoutSamples/raw_img/2023-2024-1-3364.png
