Tony-LeoN/LLM-CADCoder/DataFlow/LayoutSamples/raw_img/2023-2024-4-373.png

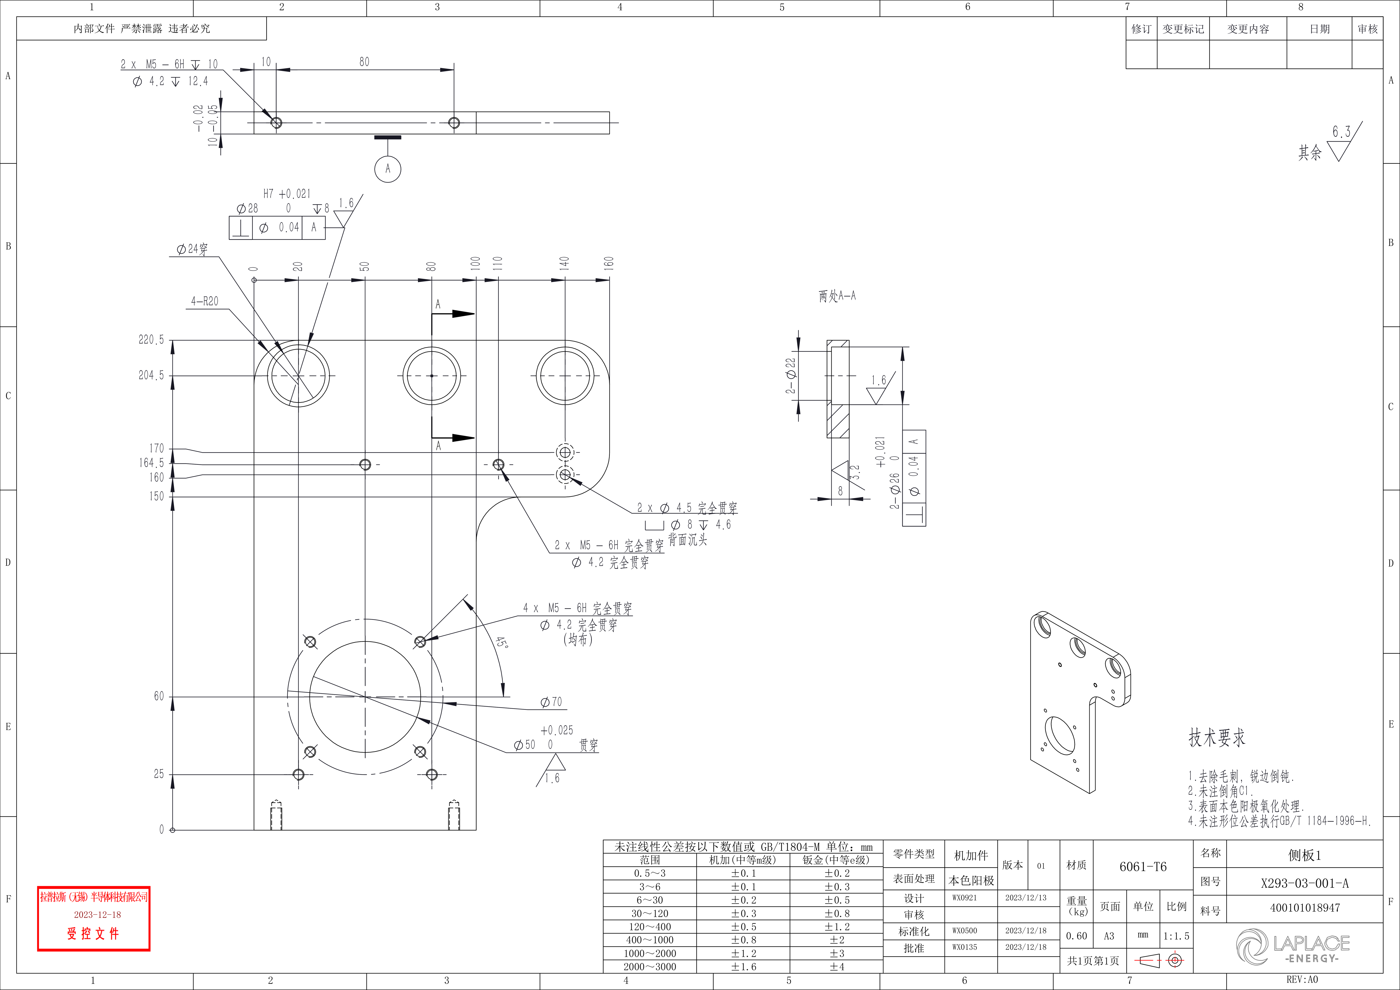
DataFlow/LayoutSamples/raw_img/2023-2024-4-373.png
