Tony-LeoN/LLM-CADCoder/DataFlow/LayoutSamples/raw_img/2023-2024-4-563.png

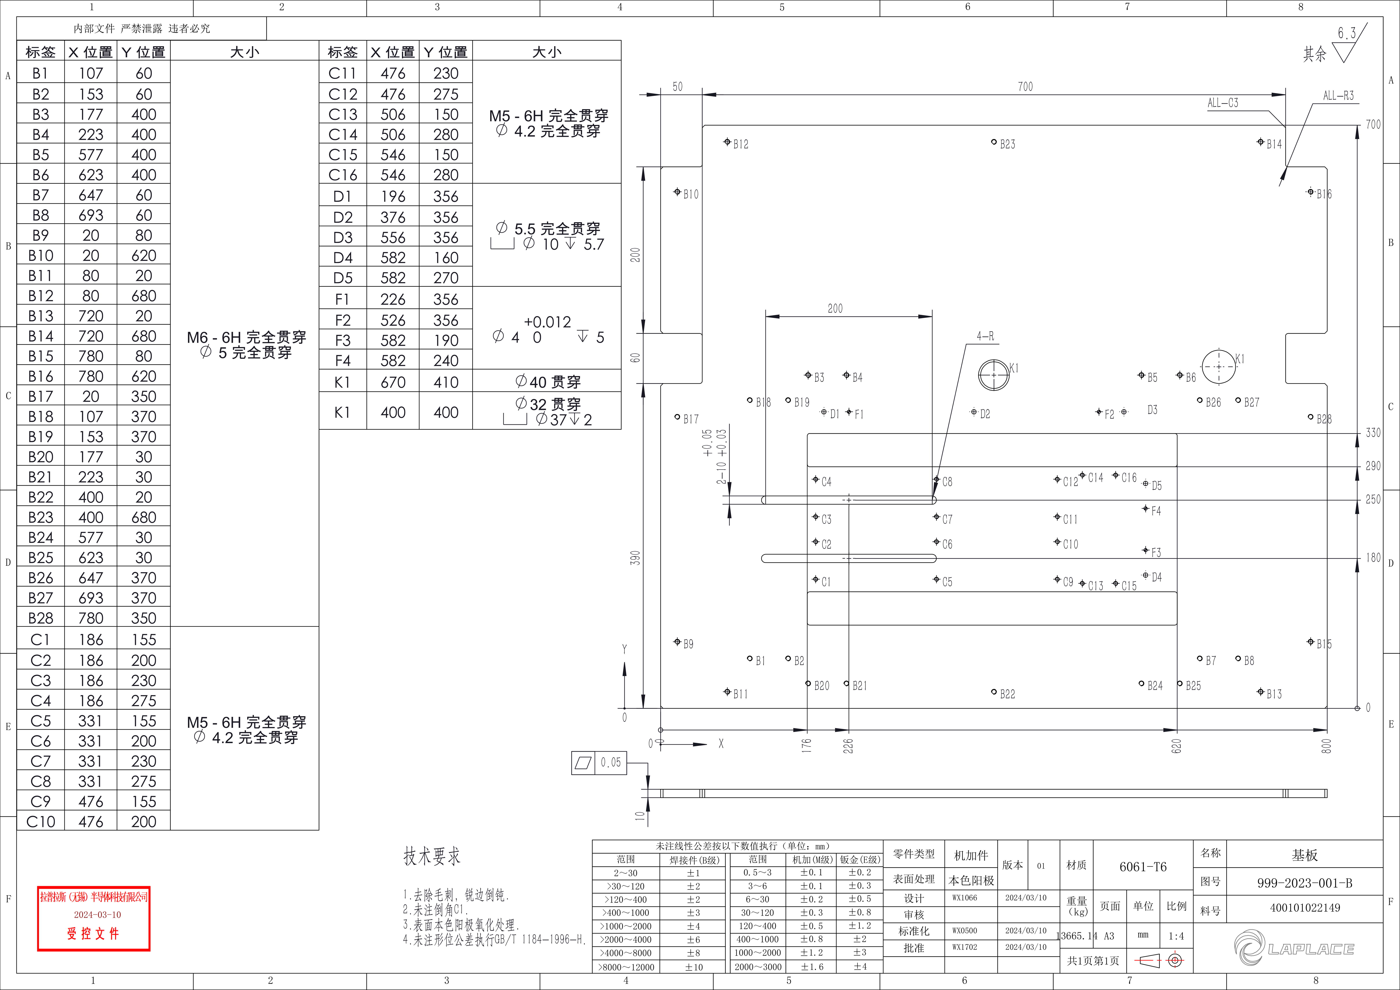
DataFlow/LayoutSamples/raw_img/2023-2024-4-563.png
