Tony-LeoN/LLM-CADCoder/DataFlow/LayoutSamples/raw_img/2023-2024-6-153.png

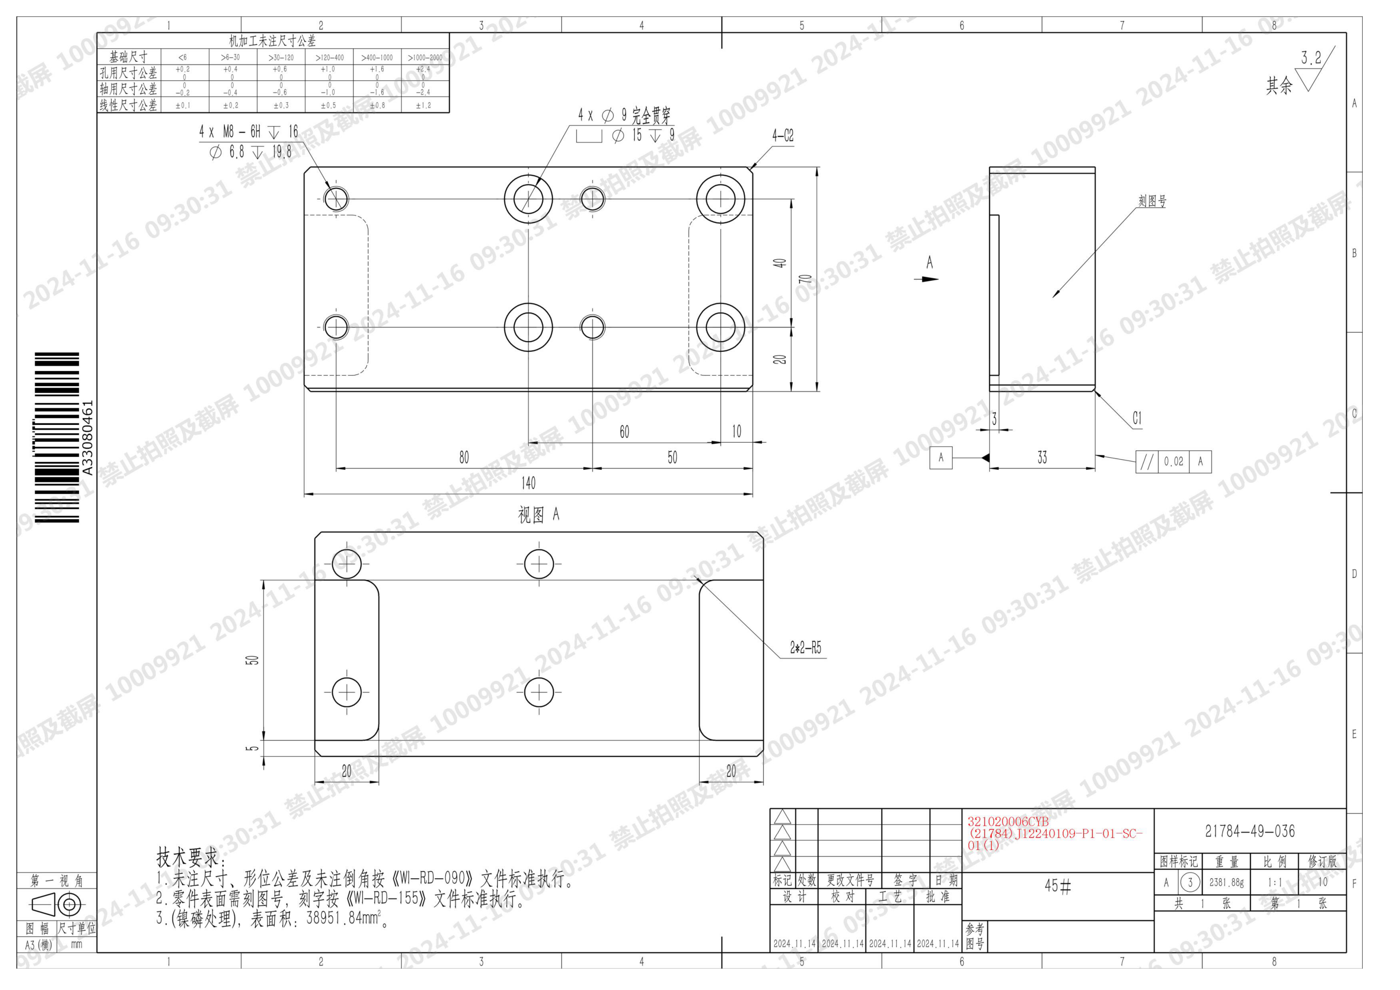
DataFlow/LayoutSamples/raw_img/2023-2024-6-153.png
