Tony-LeoN/LLM-CADCoder/DataFlow/LayoutSamples/raw_img/2023-2024-7-143.png

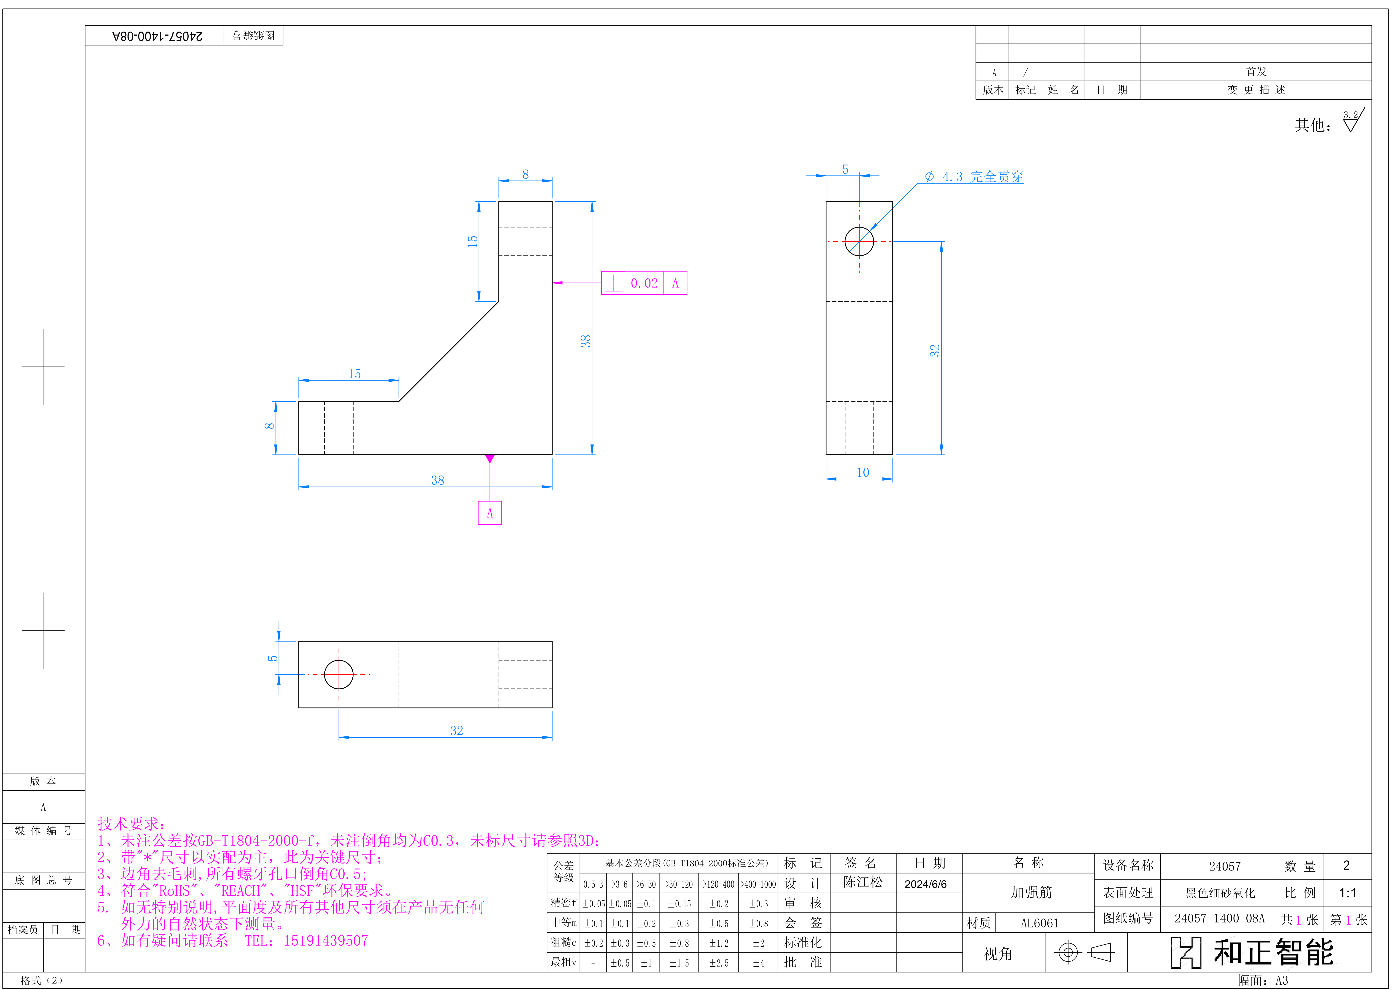
DataFlow/LayoutSamples/raw_img/2023-2024-7-143.png
