Tony-LeoN/LLM-CADCoder/DataFlow/LayoutSamples/raw_img/2023-2024-13-14.png

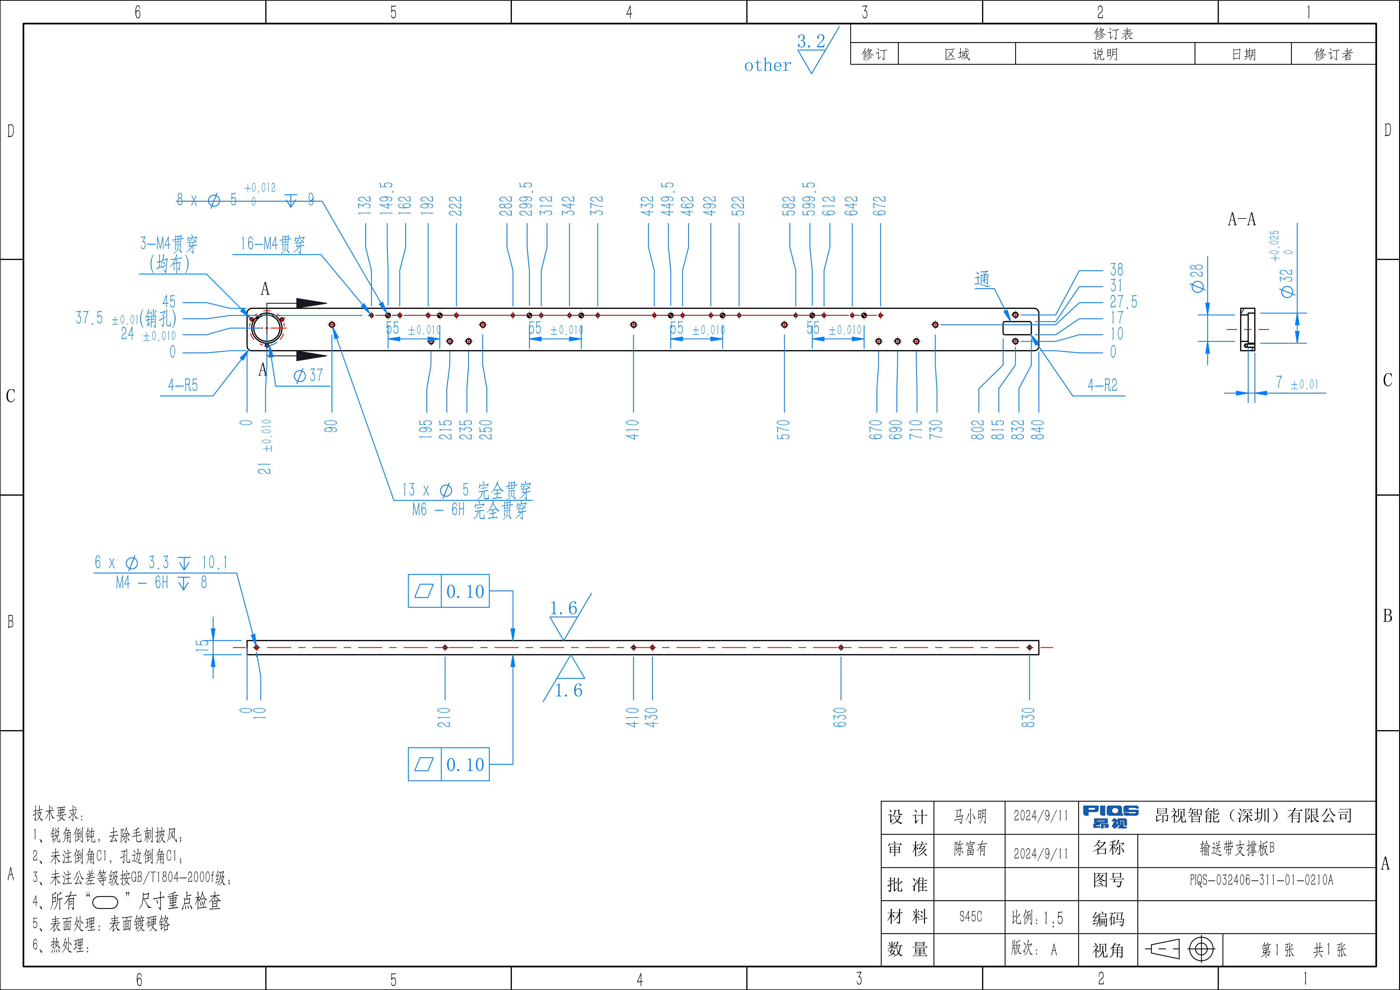
DataFlow/LayoutSamples/raw_img/2023-2024-13-14.png
