Tony-LeoN/LLM-CADCoder/DataFlow/LayoutSamples/raw_img/2023-2024-13-107.png

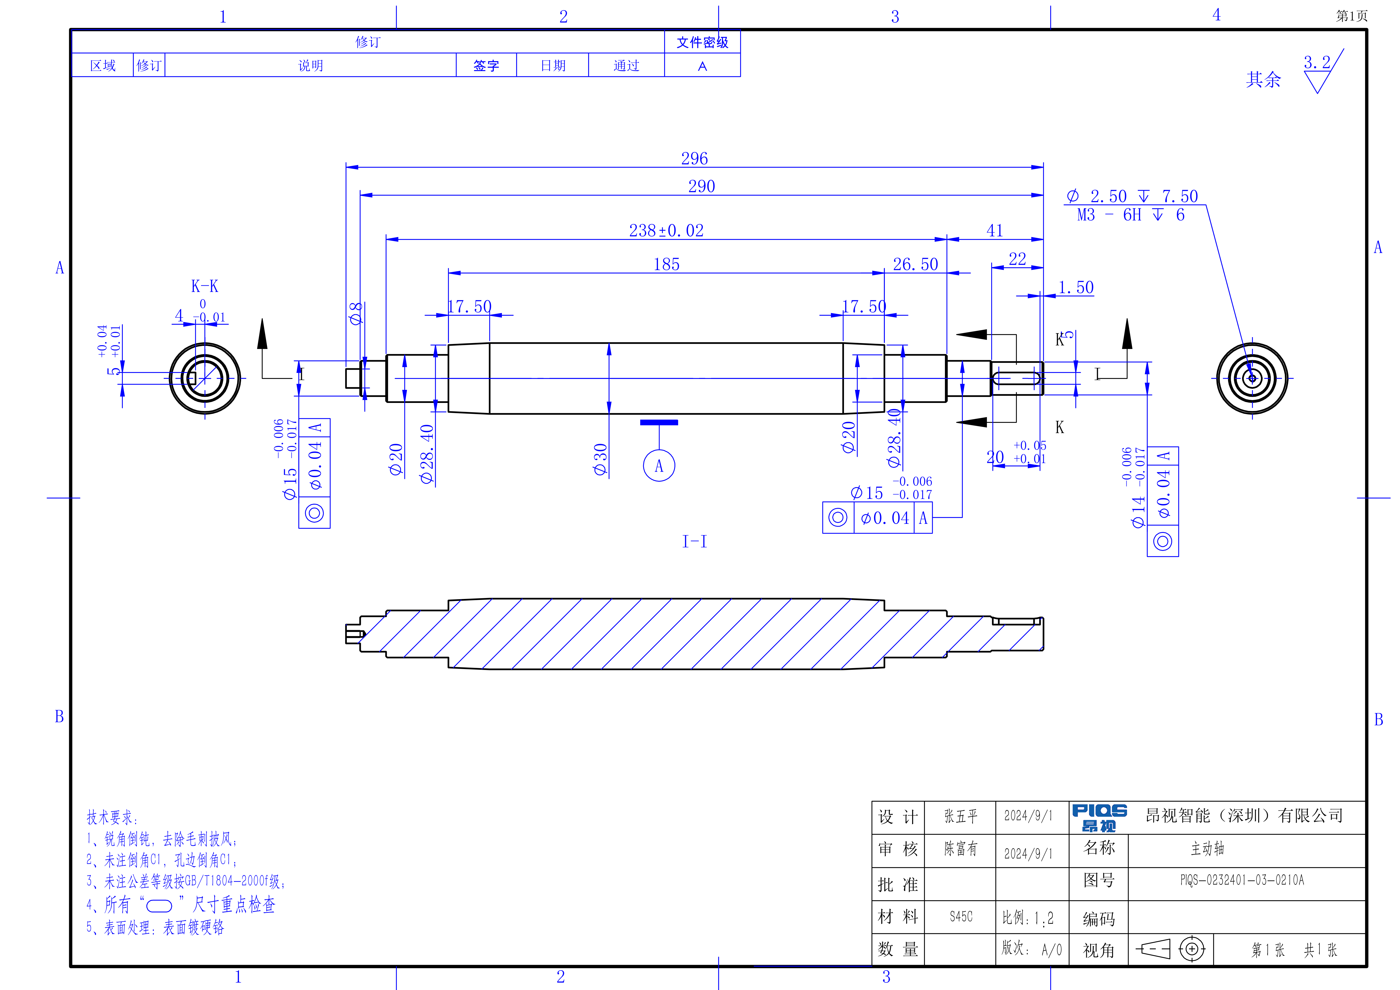
DataFlow/LayoutSamples/raw_img/2023-2024-13-107.png
