Tony-LeoN/LLM-CADCoder/DataFlow/LayoutSamples/raw_img/2023-2024-15-56.png

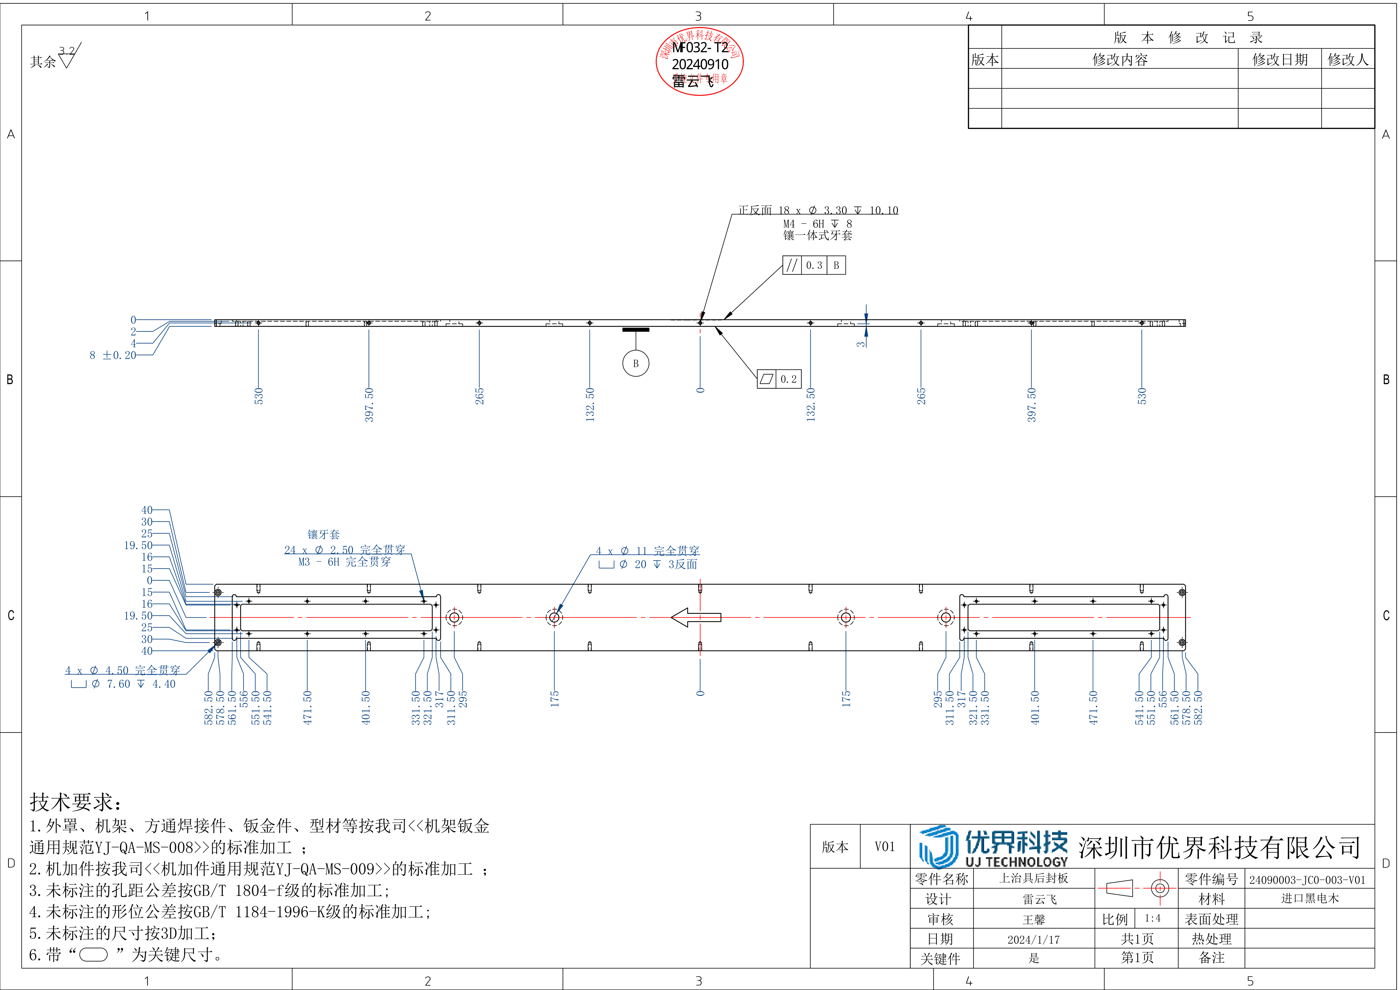
DataFlow/LayoutSamples/raw_img/2023-2024-15-56.png
