Tony-LeoN/LLM-CADCoder/DataFlow/LayoutSamples/raw_img/2023-2024-15-73.png

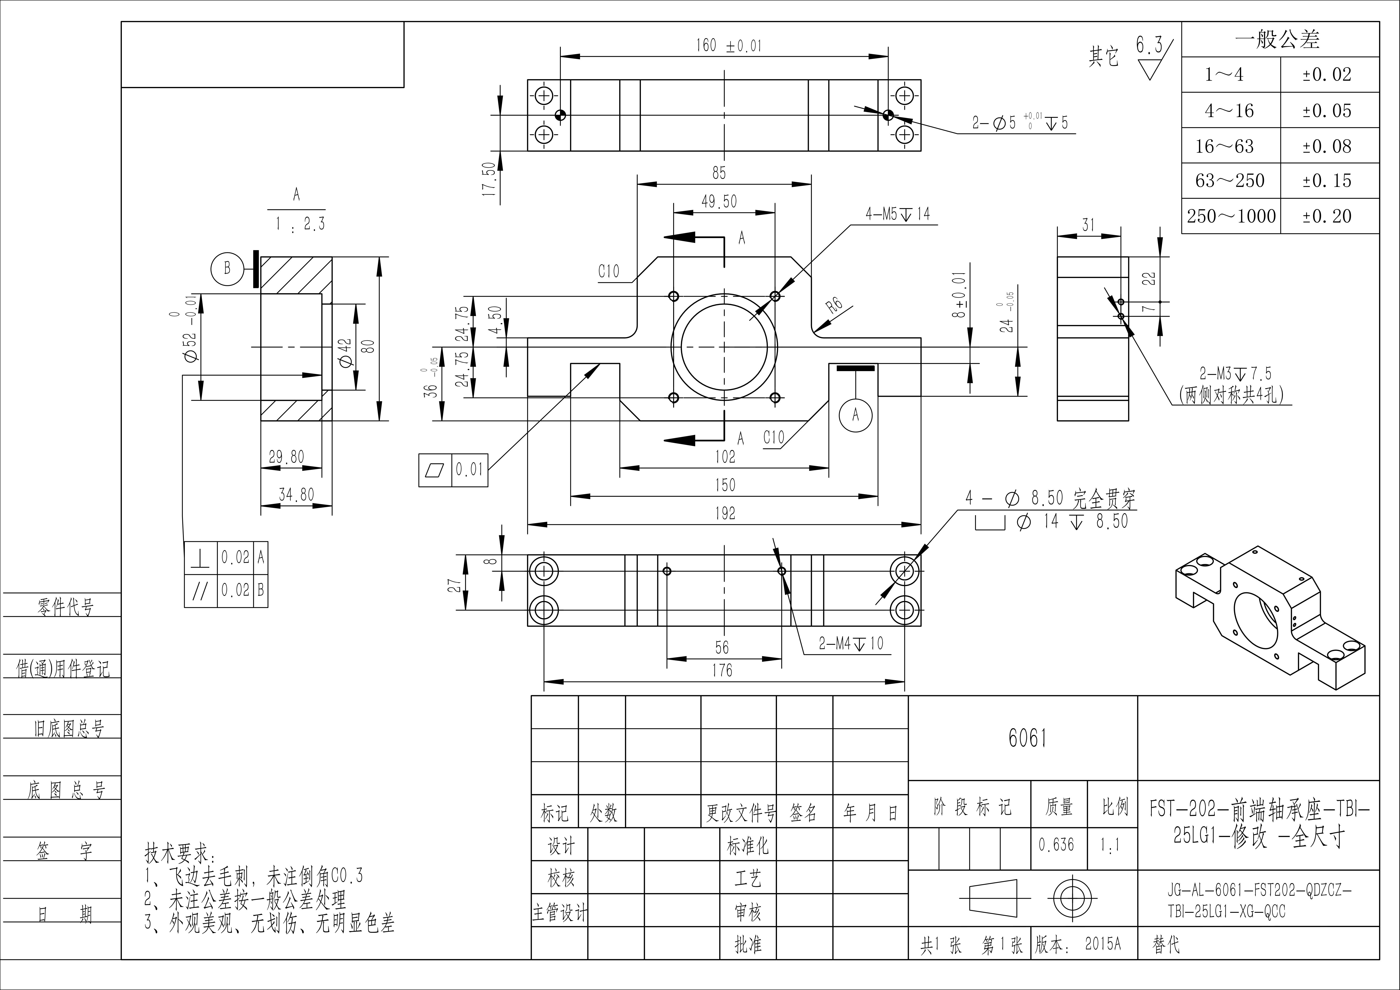
DataFlow/LayoutSamples/raw_img/2023-2024-15-73.png
