Tony-LeoN/LLM-CADCoder/DataFlow/LayoutSamples/raw_img/2023-2024-15-250.png

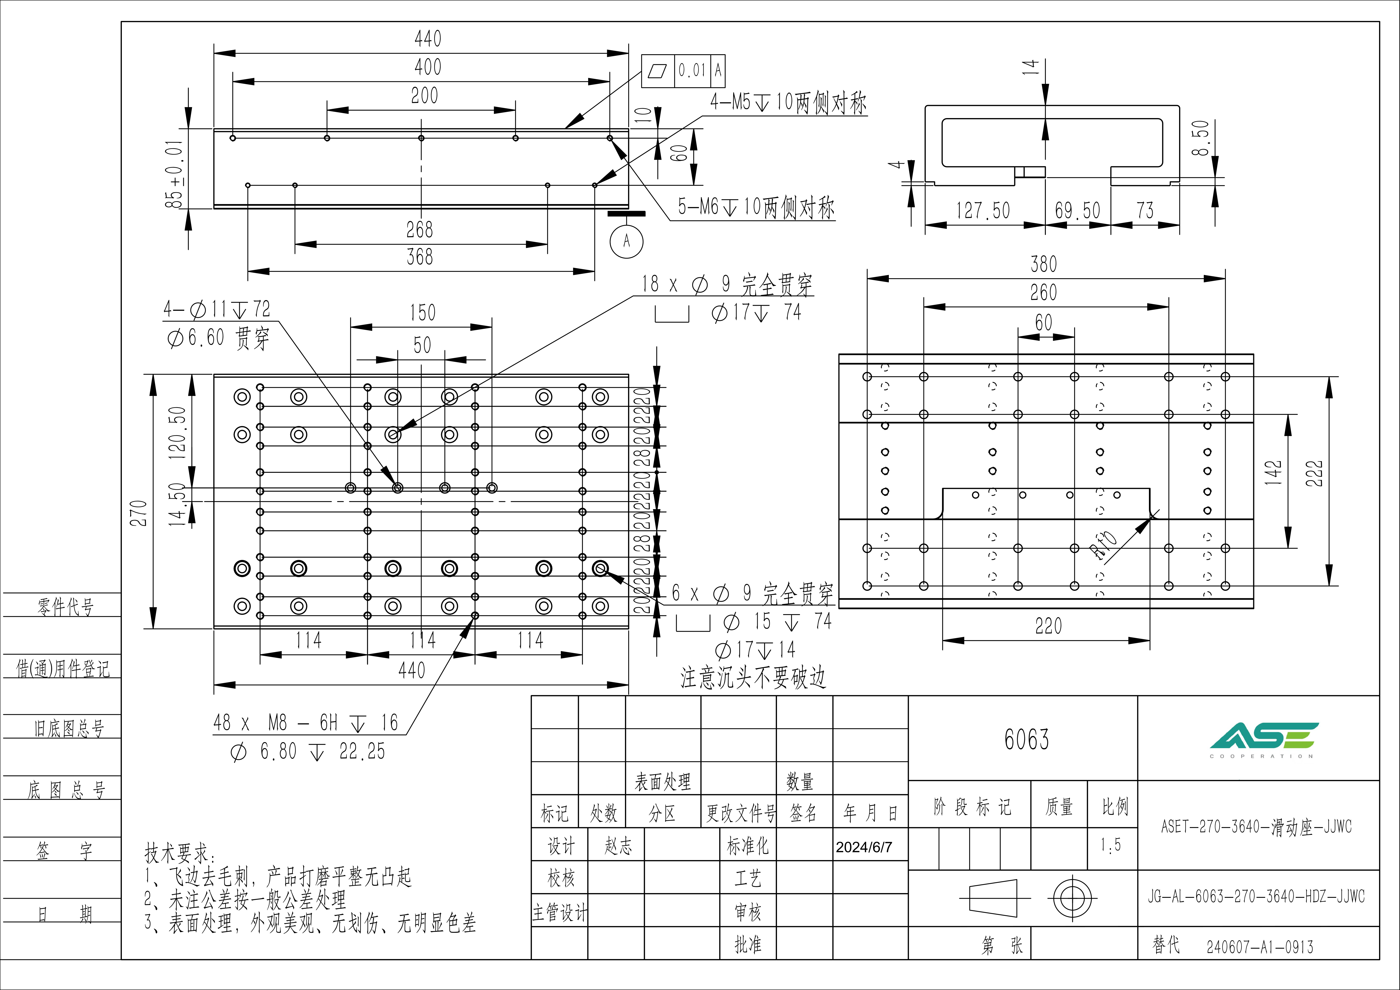
DataFlow/LayoutSamples/raw_img/2023-2024-15-250.png
