Tony-LeoN/LLM-CADCoder/DataFlow/LayoutSamples/raw_img/2023-2024-18-145.png

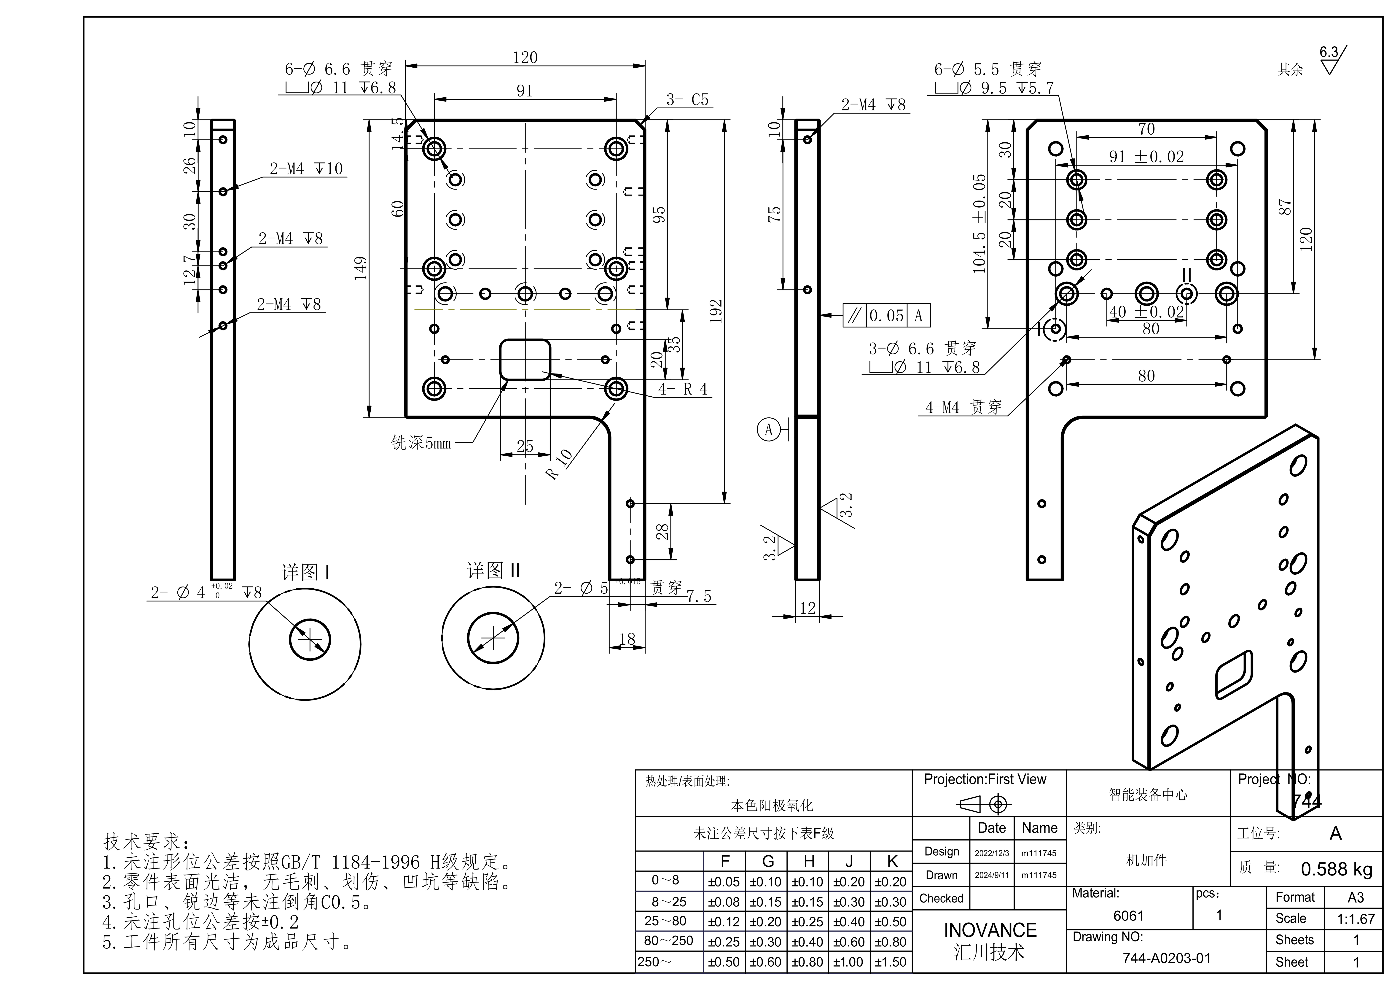
DataFlow/LayoutSamples/raw_img/2023-2024-18-145.png
