Tony-LeoN/LLM-CADCoder/DataFlow/LayoutSamples/raw_img/2023-2024-19-55.png

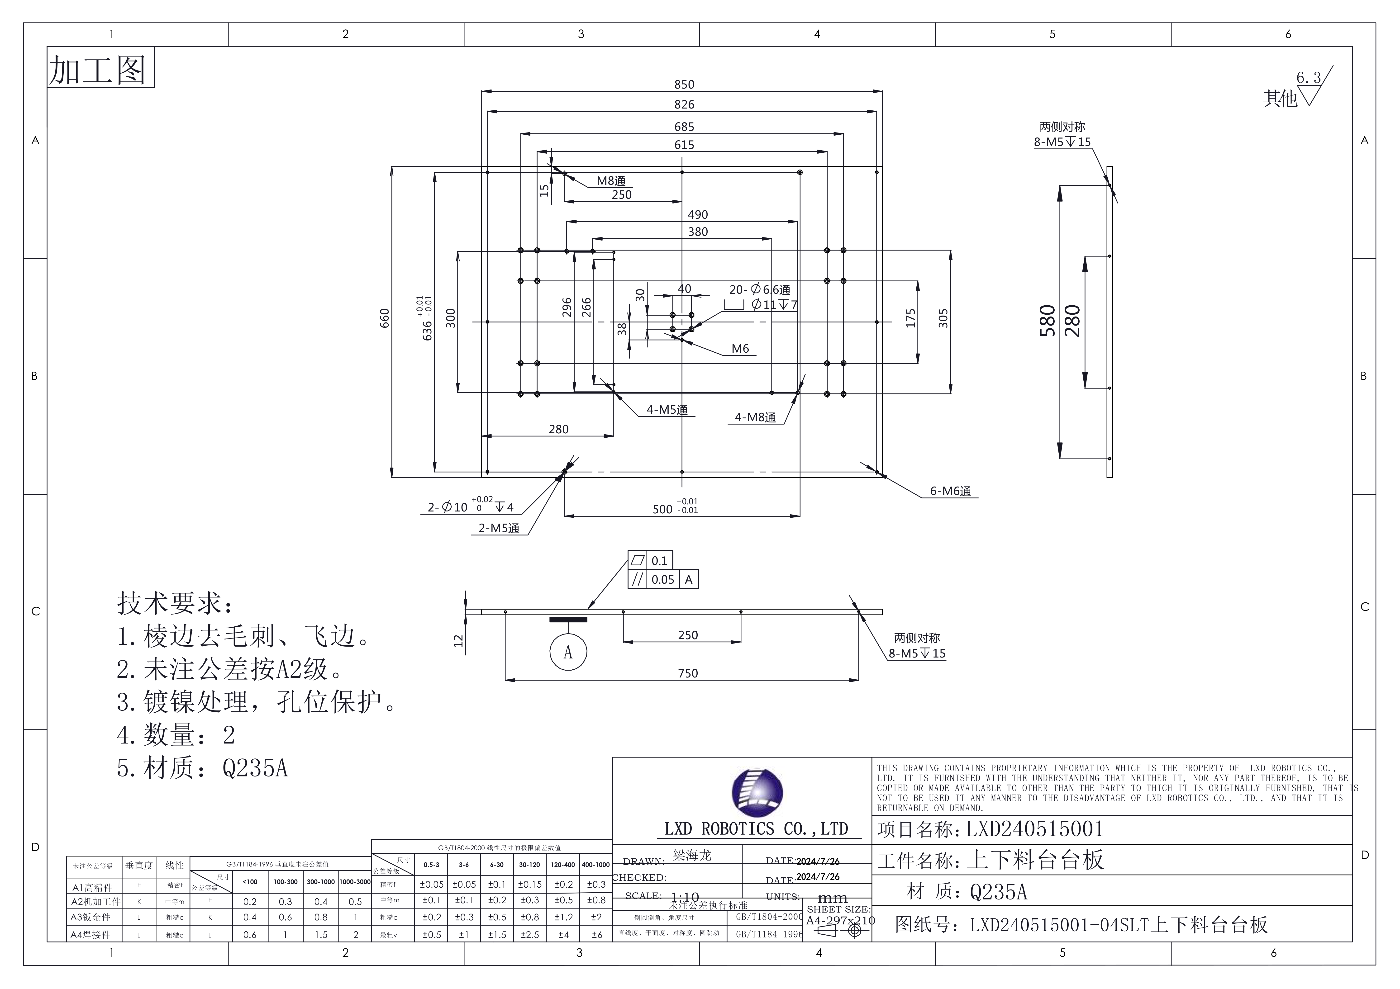
DataFlow/LayoutSamples/raw_img/2023-2024-19-55.png
