Tony-LeoN/LLM-CADCoder/DataFlow/LayoutSamples/raw_img/2023-2024-23-15.png

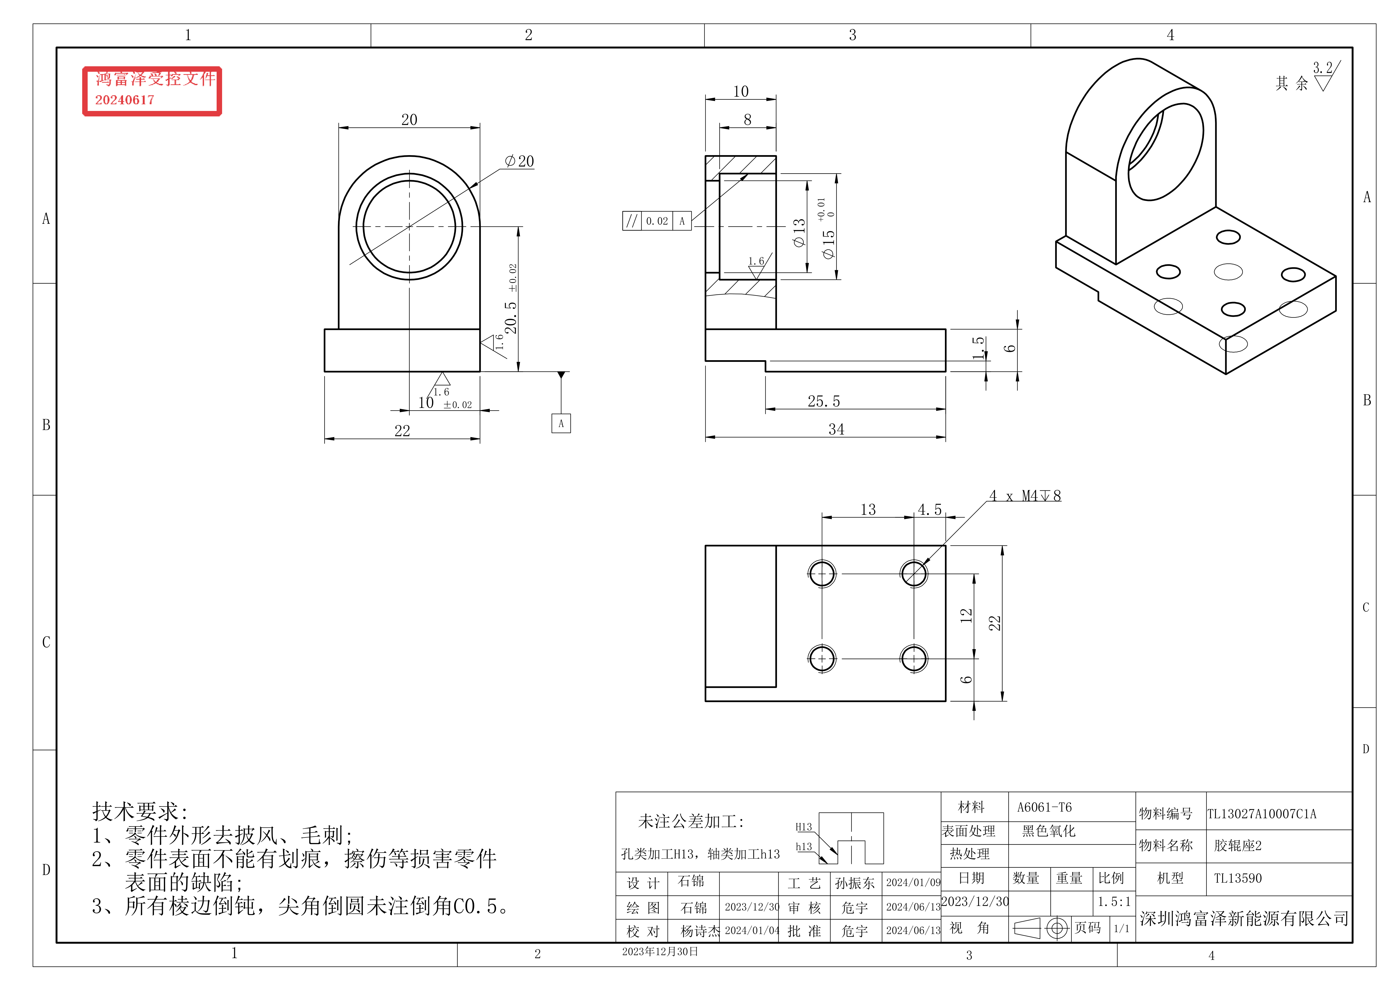
DataFlow/LayoutSamples/raw_img/2023-2024-23-15.png
