Tony-LeoN/LLM-CADCoder/DataFlow/LayoutSamples/raw_img/2023-2024-23-105.png

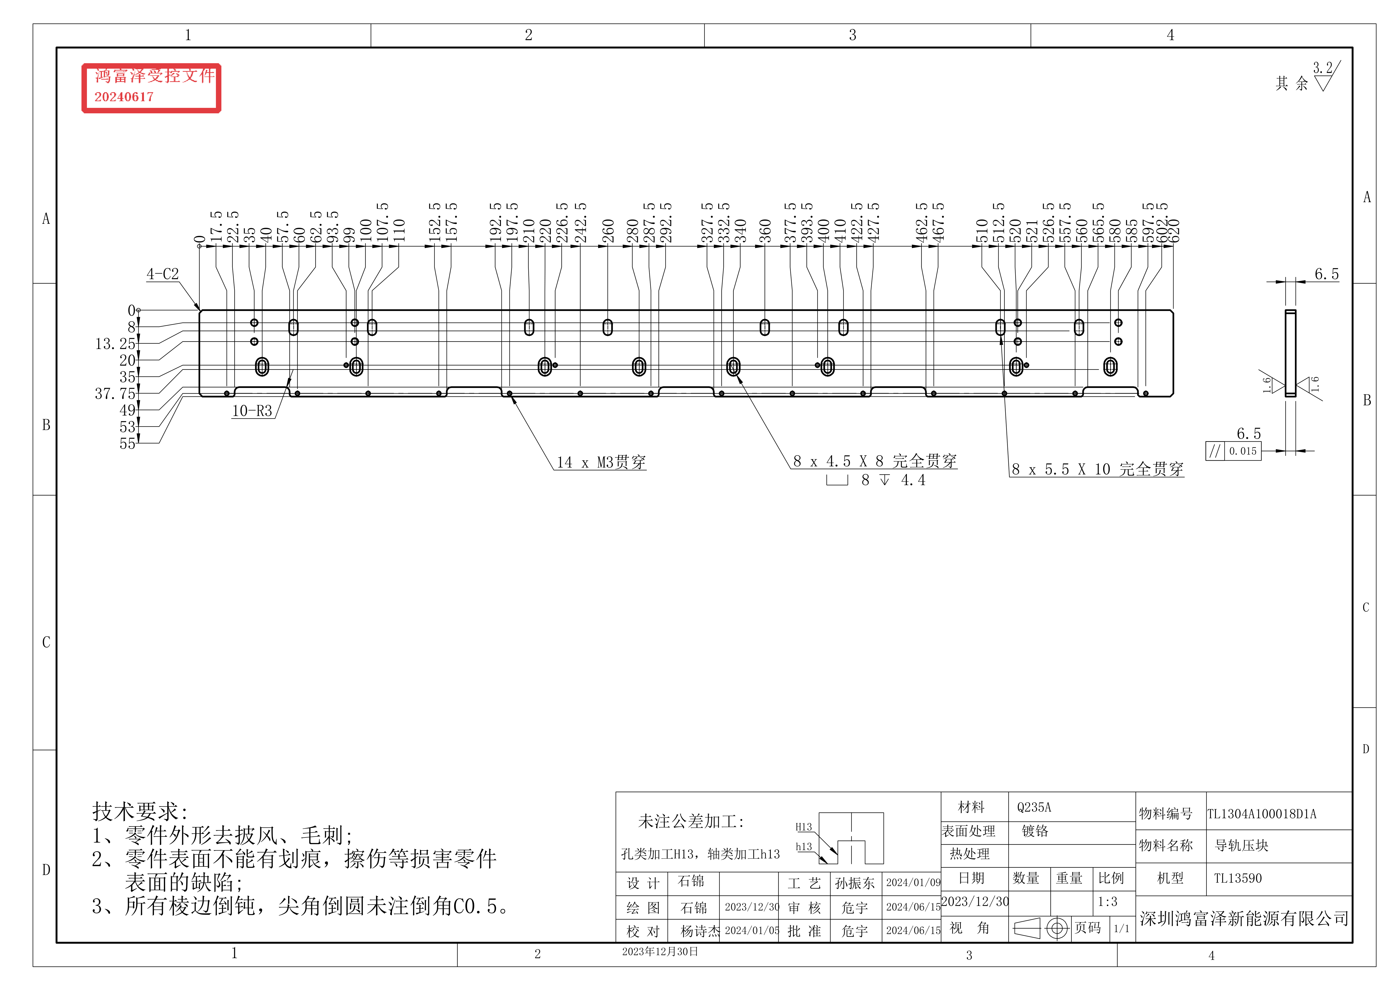
DataFlow/LayoutSamples/raw_img/2023-2024-23-105.png
