Tony-LeoN/LLM-CADCoder/DataFlow/LayoutSamples/raw_img/2023-2024-26-84.png

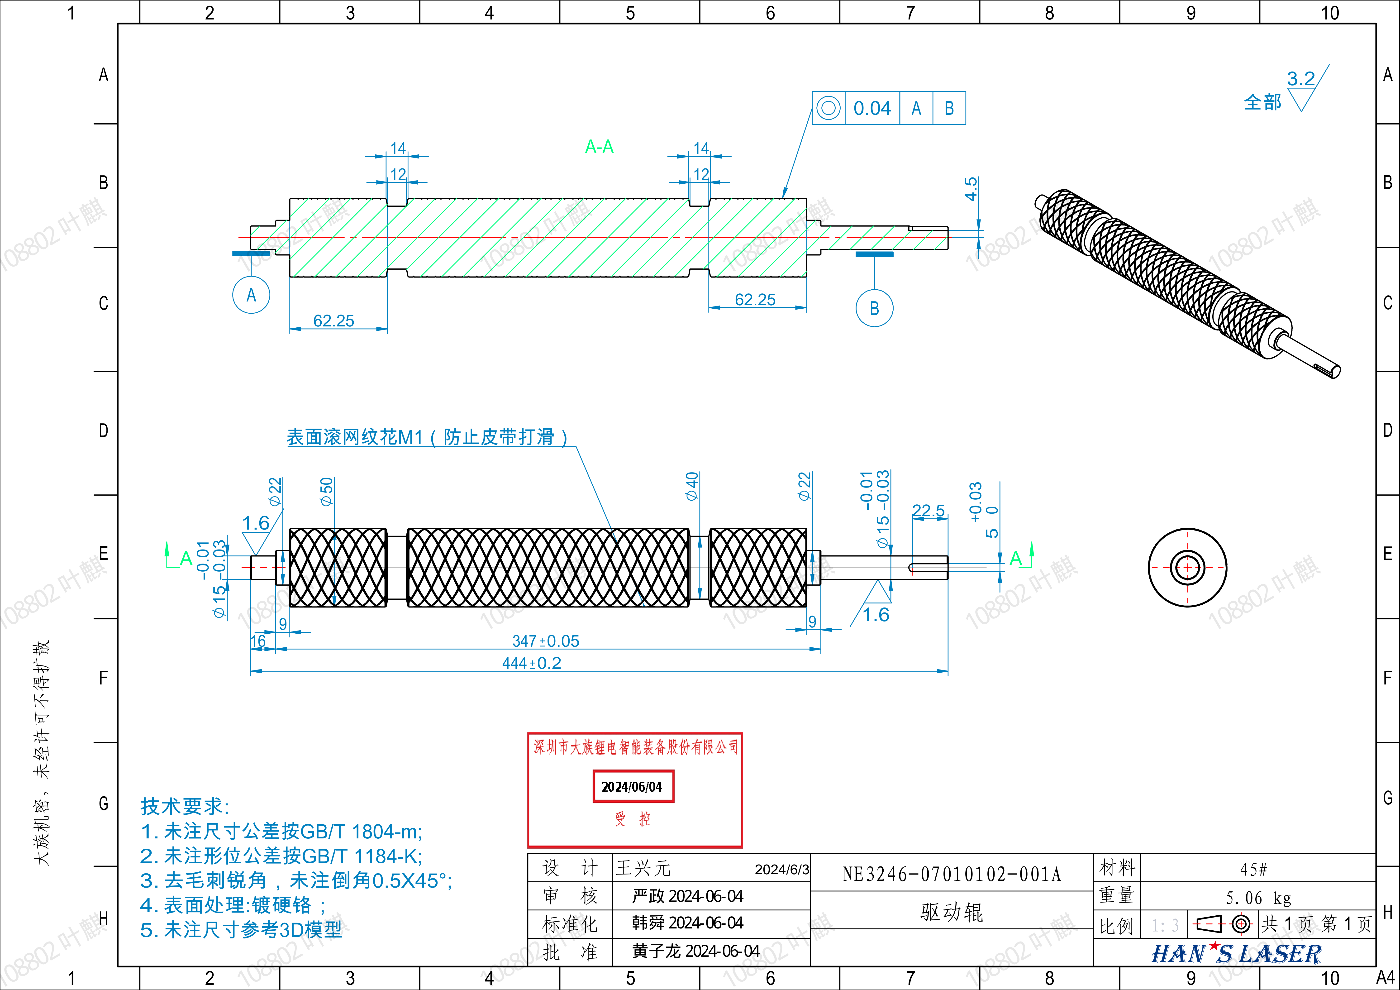
DataFlow/LayoutSamples/raw_img/2023-2024-26-84.png
