Tony-LeoN/LLM-CADCoder/DataFlow/LayoutSamples/raw_img/2023-2024-31-104.png

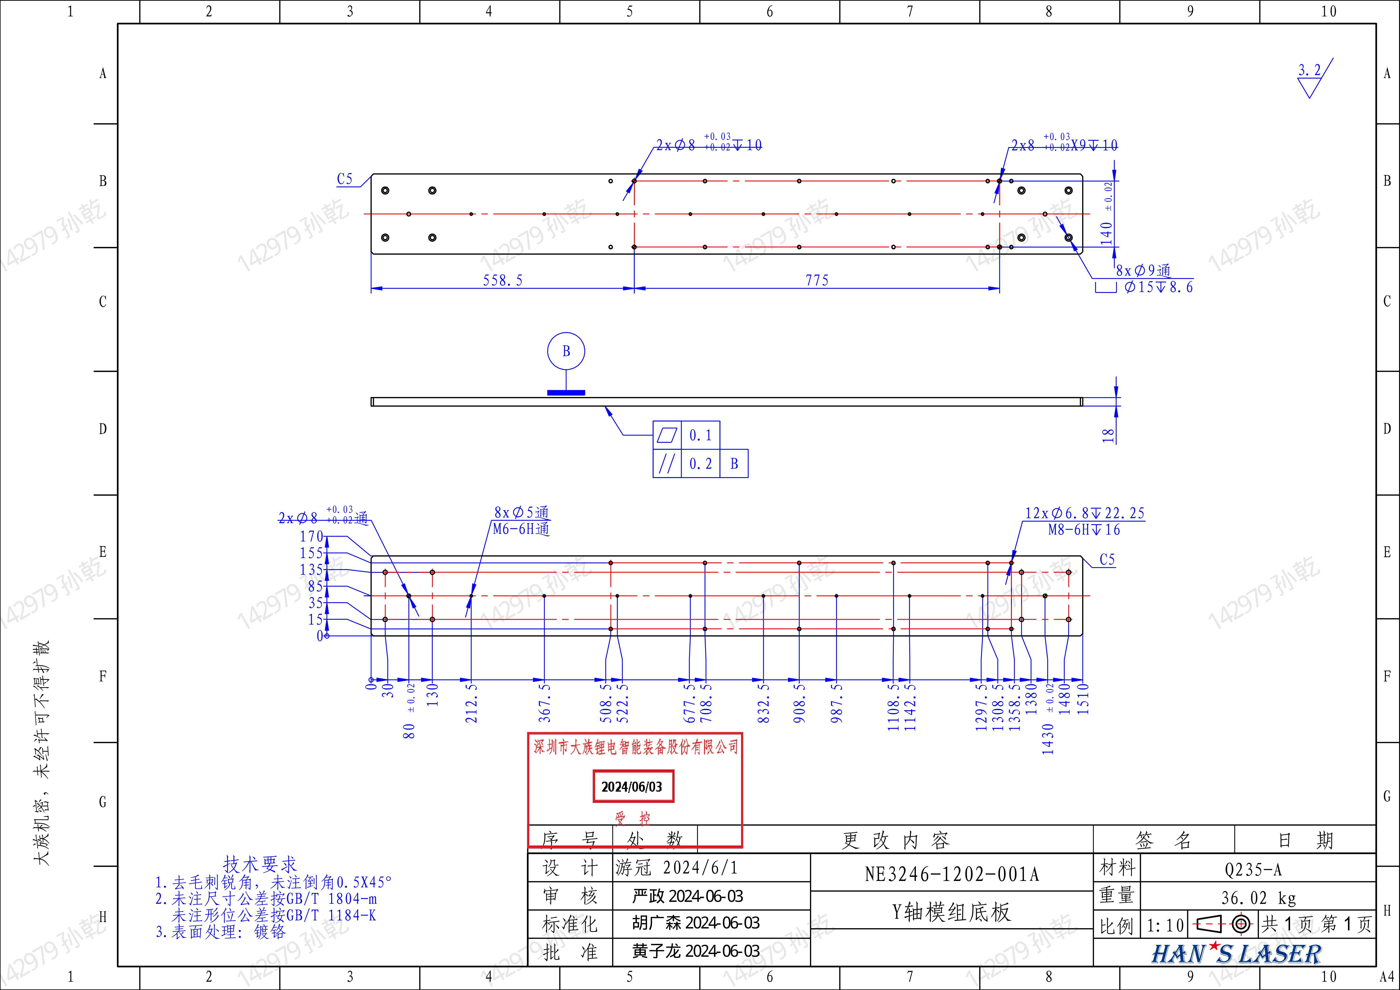
DataFlow/LayoutSamples/raw_img/2023-2024-31-104.png
