Tony-LeoN/LLM-CADCoder/DataFlow/LayoutSamples/raw_img/2023-2024-31-117.png

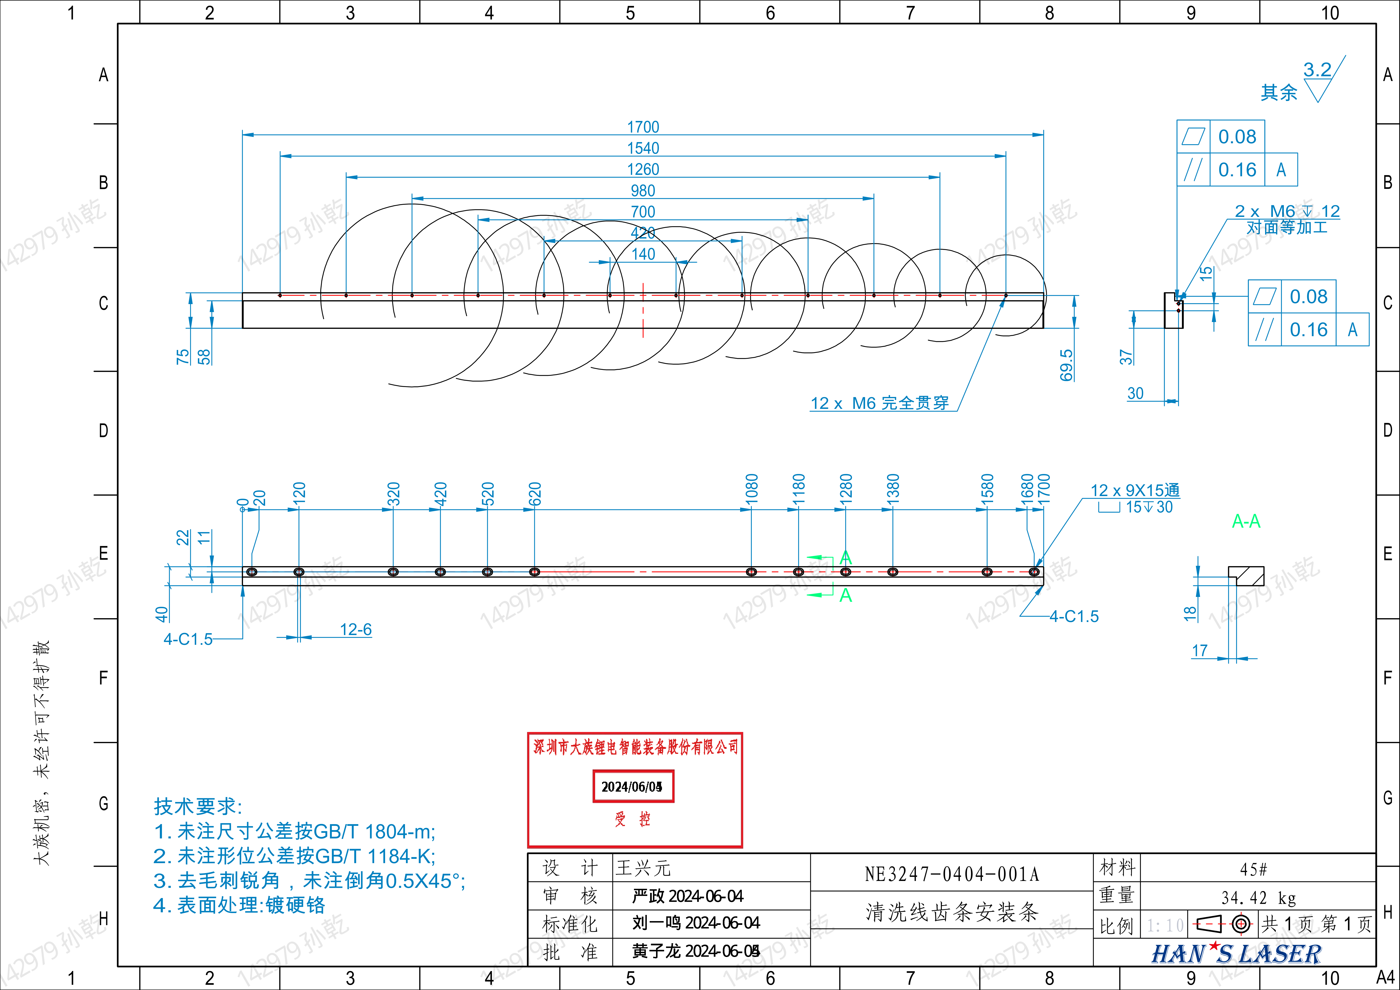
DataFlow/LayoutSamples/raw_img/2023-2024-31-117.png
