Tony-LeoN/LLM-CADCoder/DataFlow/LayoutSamples/raw_img/2023-2024-31-119.png

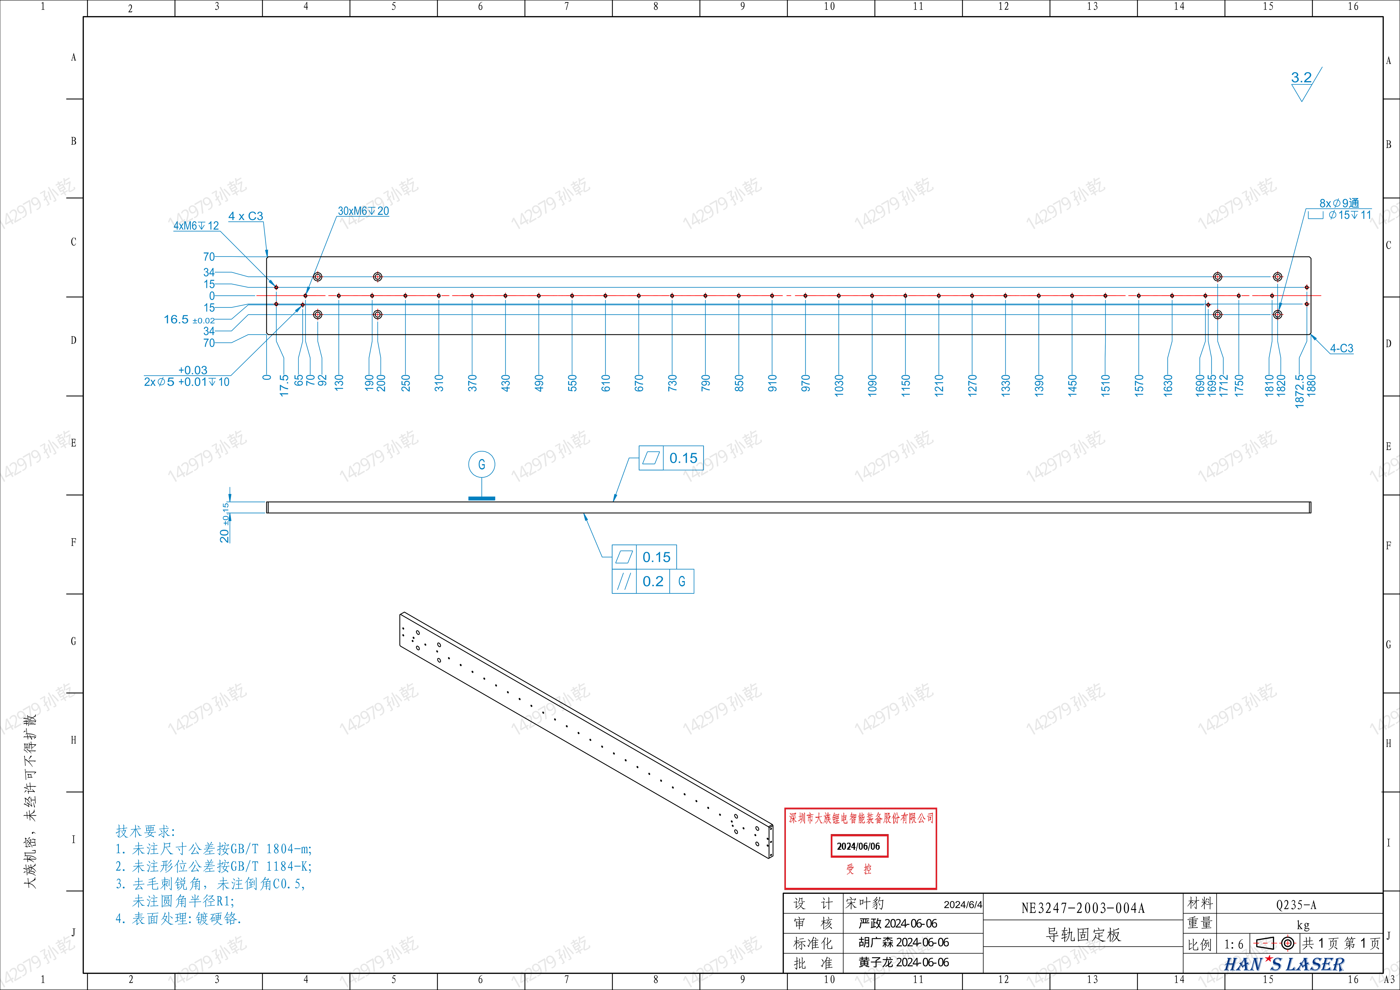
DataFlow/LayoutSamples/raw_img/2023-2024-31-119.png
