Tony-LeoN/LLM-CADCoder/DataFlow/LayoutSamples/raw_img/2023-2024-38-81.png

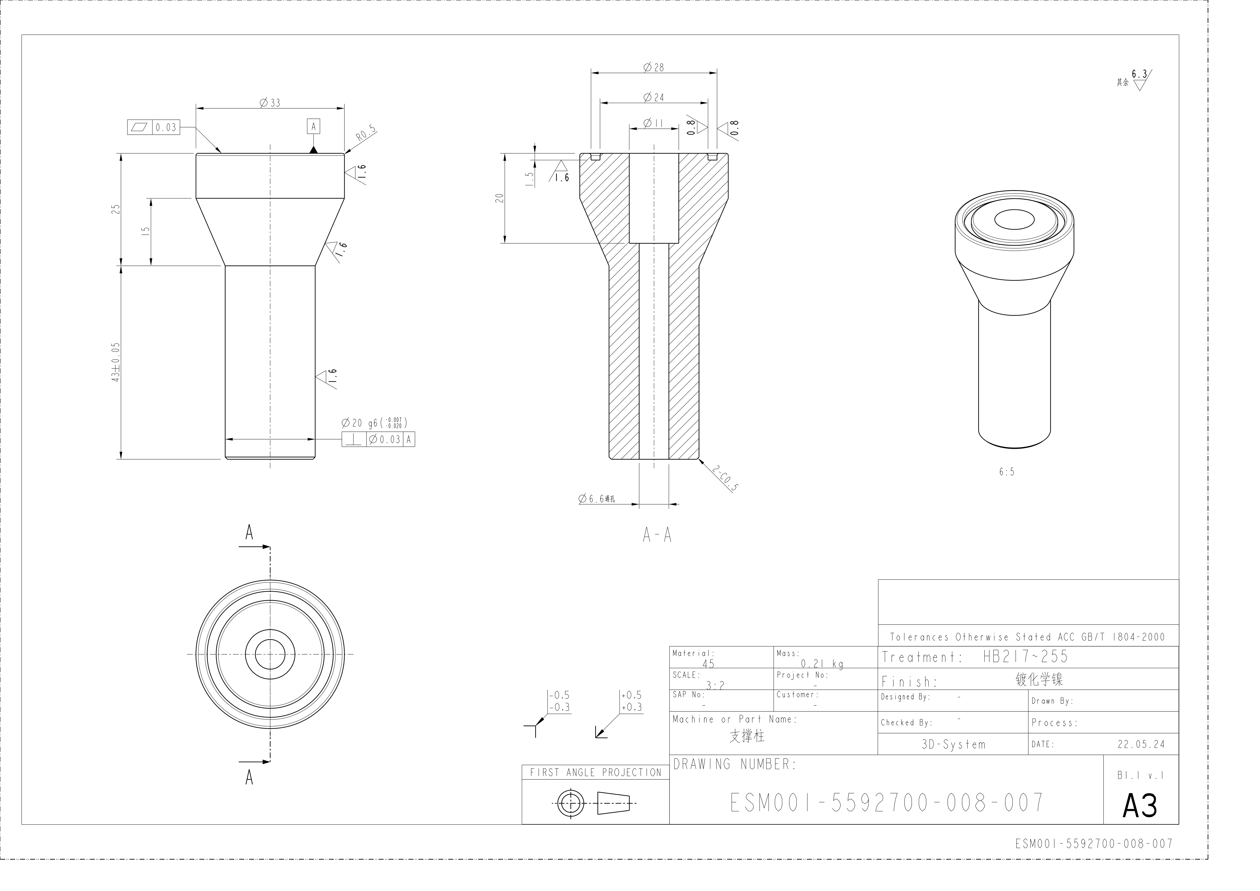
DataFlow/LayoutSamples/raw_img/2023-2024-38-81.png
