Tony-LeoN/LLM-CADCoder/DataFlow/LayoutSamples/raw_img/2023-2024-45-31.png

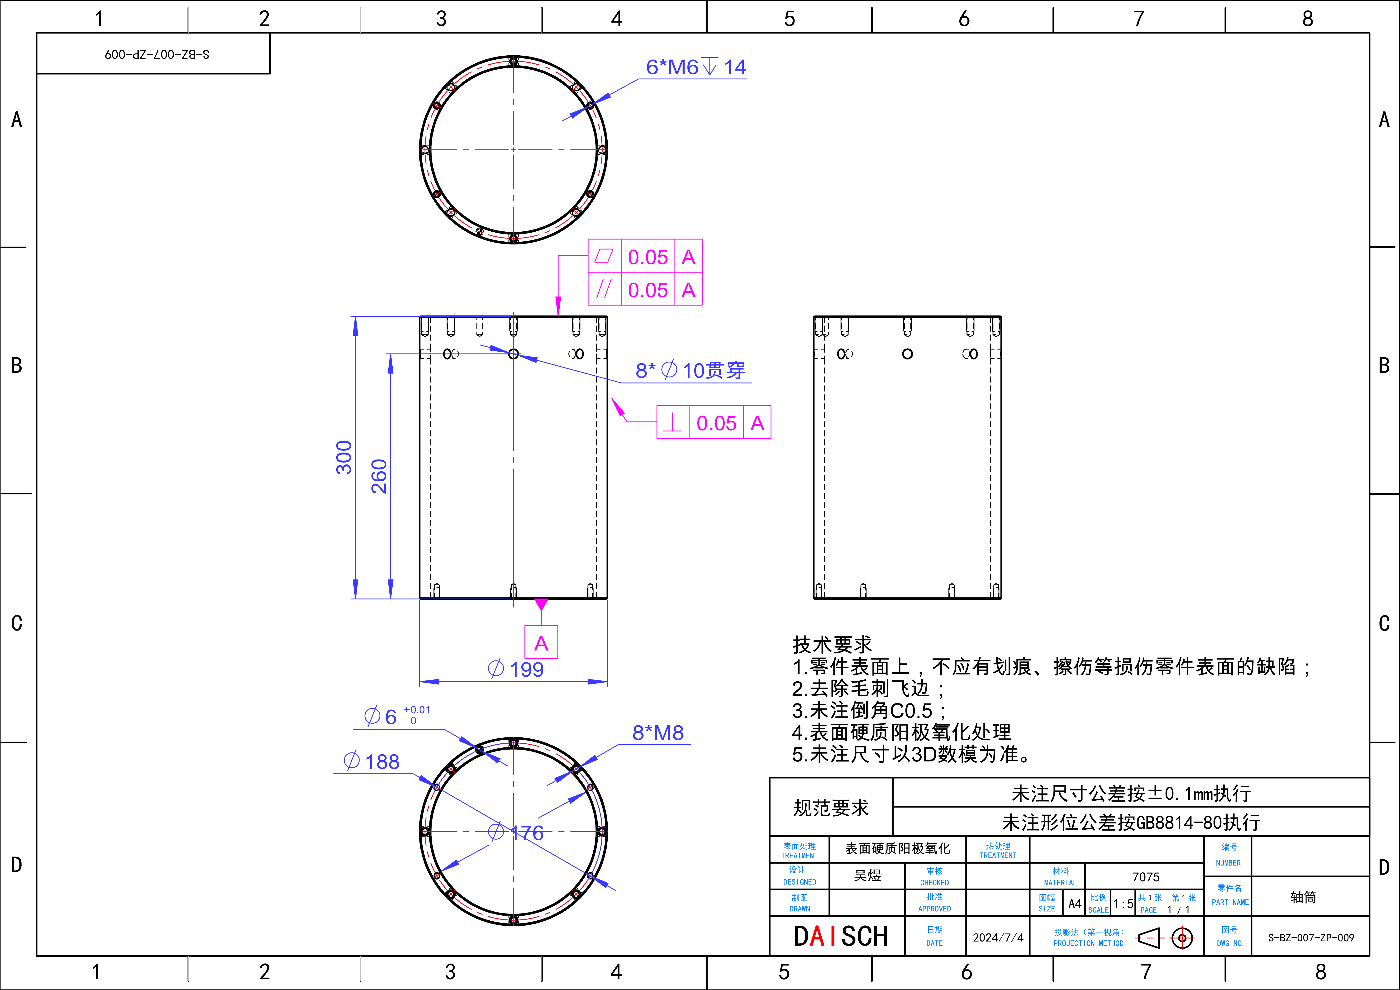
DataFlow/LayoutSamples/raw_img/2023-2024-45-31.png
