Tony-LeoN/LLM-CADCoder/DataFlow/01.RawPDFWithSTEP/X262-07-013-A.STEP

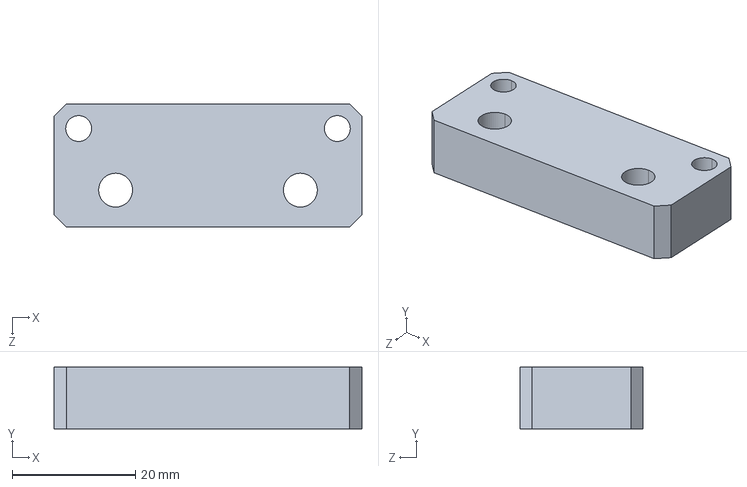
[picture p173: CAD file, 2026-06-03]
DataFlow/01.RawPDFWithSTEP/X262-07-013-A.STEP
50.0 x 10.0 x 20.0 mm
