Tony-LeoN/LLM-CADCoder/DataFlow/01.RawPDFWithSTEP/010加强条.step

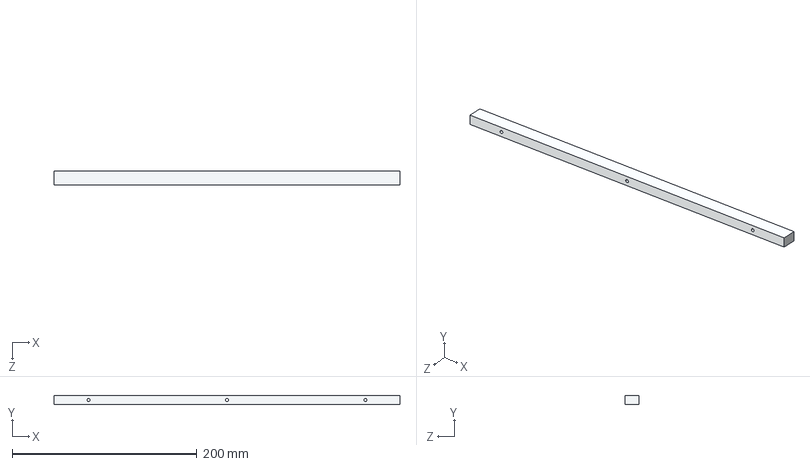
[picture p174: CAD file, 2026-06-03]
DataFlow/01.RawPDFWithSTEP/010加强条.step
375.0 x 10.0 x 15.0 mm
