Tony-LeoN/LLM-CADCoder/DataFlow/01.RawPDFWithSTEP/X441-58-009-A.STEP

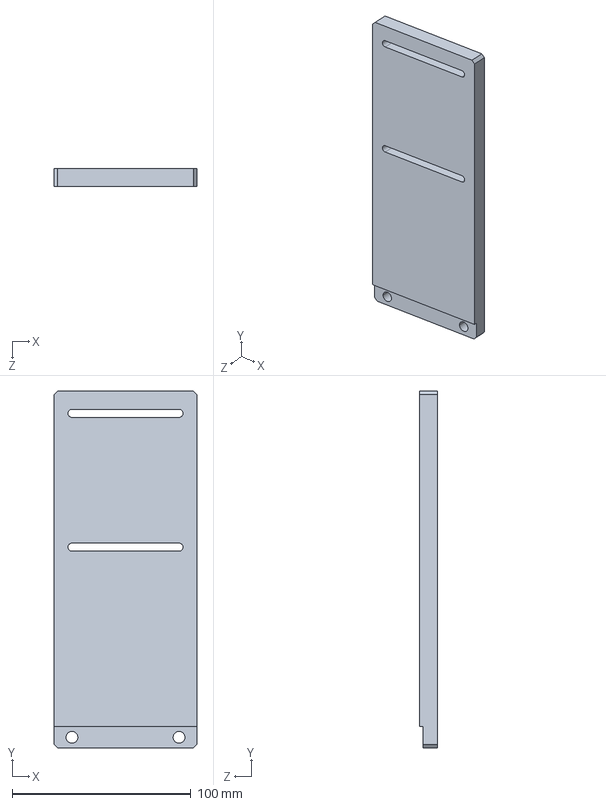
[picture p175: CAD file, 2026-06-03]
DataFlow/01.RawPDFWithSTEP/X441-58-009-A.STEP
80.0 x 200.0 x 10.0 mm
