Tony-LeoN/LLM-CADCoder/DataFlow/01.RawPDFWithSTEP/X445-10-029-A.STEP

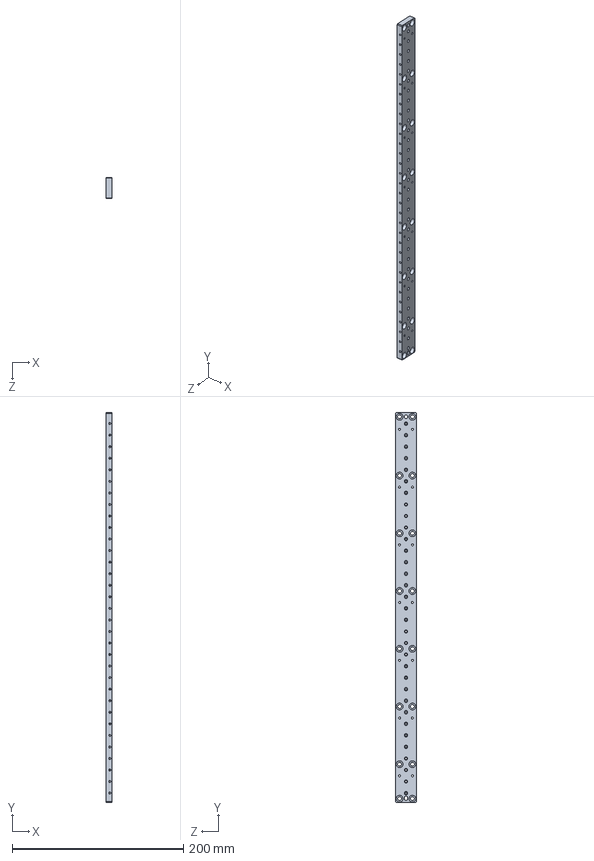
[picture p176: CAD file, 2026-06-03]
DataFlow/01.RawPDFWithSTEP/X445-10-029-A.STEP
7.00 x 456.0 x 25.0 mm
