Tony-LeoN/LLM-CADCoder/DataFlow/01.RawPDFWithSTEP/X476-04-002-A.STEP

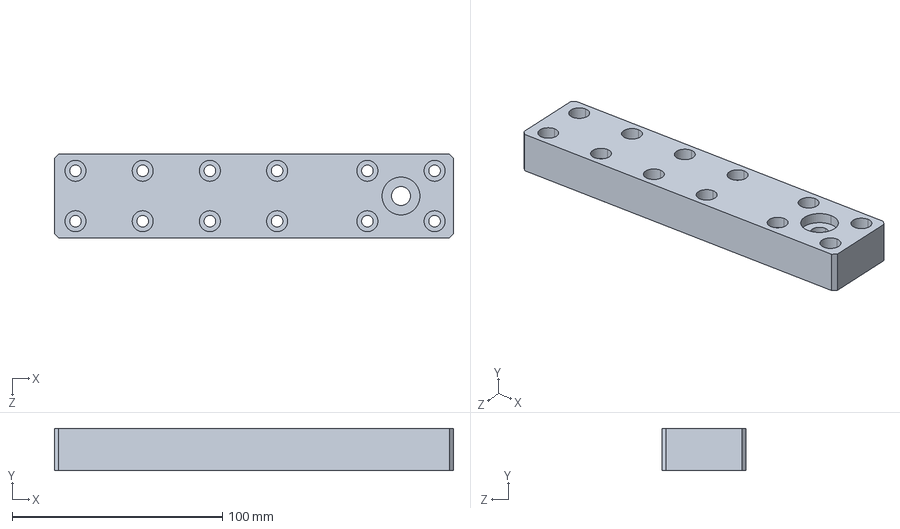
[picture p177: CAD file, 2026-06-03]
DataFlow/01.RawPDFWithSTEP/X476-04-002-A.STEP
190.0 x 20.0 x 40.0 mm
