Tony-LeoN/LLM-CADCoder/DataFlow/01.RawPDFWithSTEP/X445-02-002-A.STEP

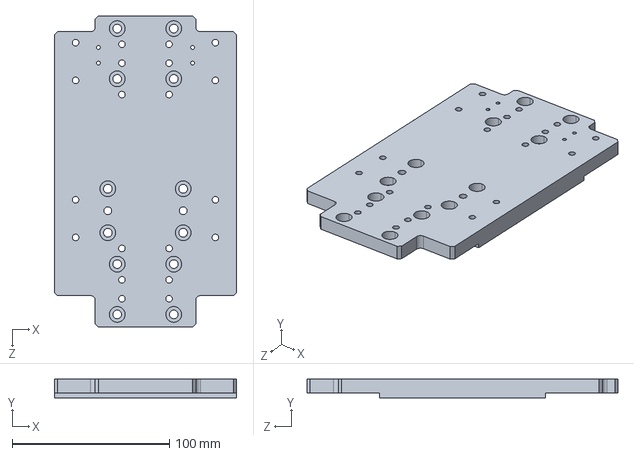
[picture p178: CAD file, 2026-06-03]
DataFlow/01.RawPDFWithSTEP/X445-02-002-A.STEP
116.0 x 12.0 x 198.0 mm
