Tony-LeoN/LLM-CADCoder/DataFlow/01.RawPDFWithSTEP/X445-13-005-A.STEP

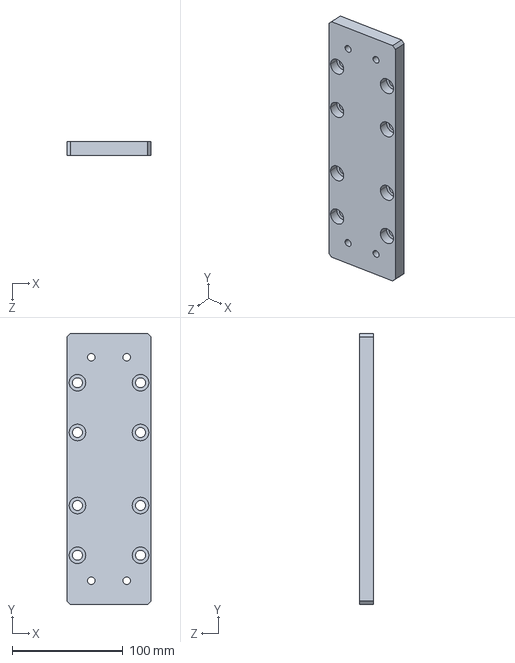
[picture p179: CAD file, 2026-06-03]
DataFlow/01.RawPDFWithSTEP/X445-13-005-A.STEP
76.0 x 245.0 x 13.0 mm
