Tony-LeoN/LLM-CADCoder/DataFlow/01.RawPDFWithSTEP/NE3436-3002011-002A防撞块.step

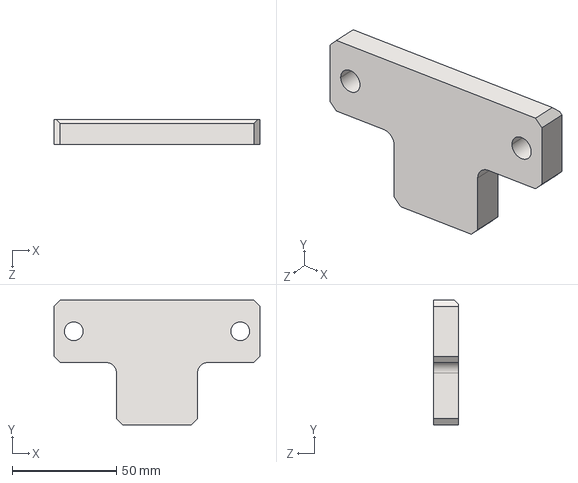
[picture p180: CAD file, 2026-06-03]
DataFlow/01.RawPDFWithSTEP/NE3436-3002011-002A防撞块.step
99.0 x 60.0 x 12.0 mm
