Tony-LeoN/LLM-CADCoder/DataFlow/01.RawPDFWithSTEP/011加强条.step

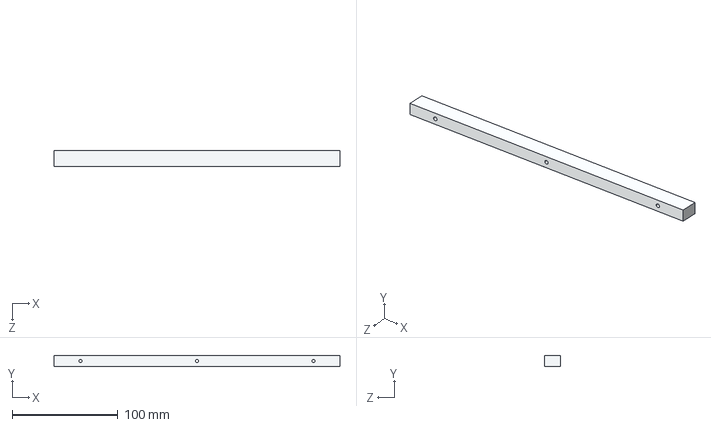
[picture p181: CAD file, 2026-06-03]
DataFlow/01.RawPDFWithSTEP/011加强条.step
270.0 x 10.0 x 15.0 mm
