Tony-LeoN/LLM-CADCoder/DataFlow/01.RawPDFWithSTEP/X350-05-071-A.STEP

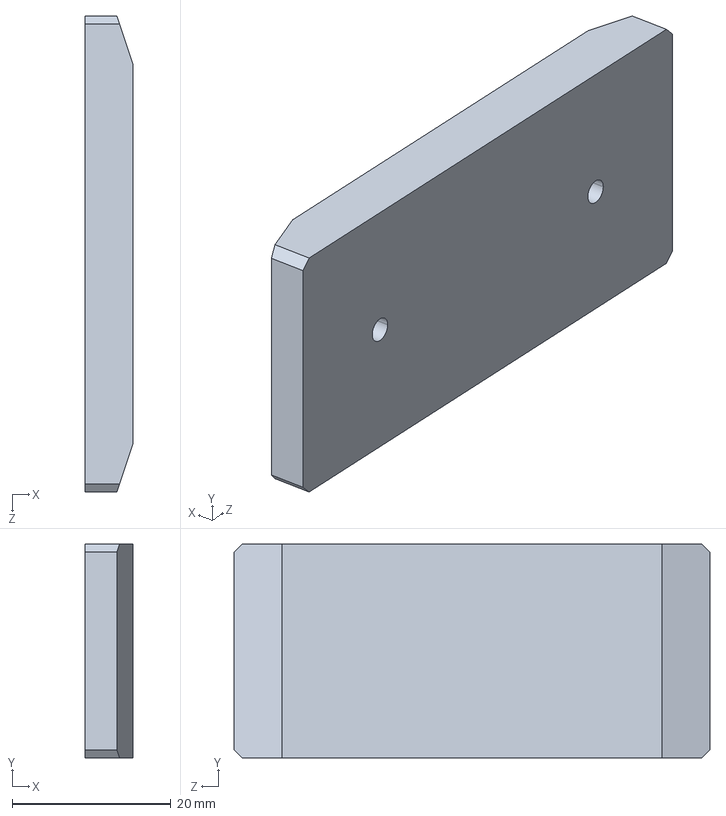
[picture p182: CAD file, 2026-06-03]
DataFlow/01.RawPDFWithSTEP/X350-05-071-A.STEP
6.00 x 27.0 x 60.0 mm
