Tony-LeoN/LLM-CADCoder/DataFlow/01.RawPDFWithSTEP/X476-07-011-C.STEP

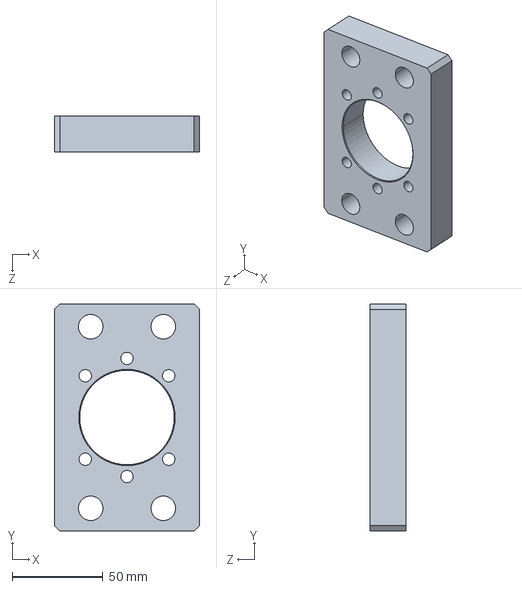
[picture p183: CAD file, 2026-06-03]
DataFlow/01.RawPDFWithSTEP/X476-07-011-C.STEP
80.0 x 125.0 x 20.0 mm
