Tony-LeoN/LLM-CADCoder/DataFlow/01.RawPDFWithSTEP/output_machined_plate.step

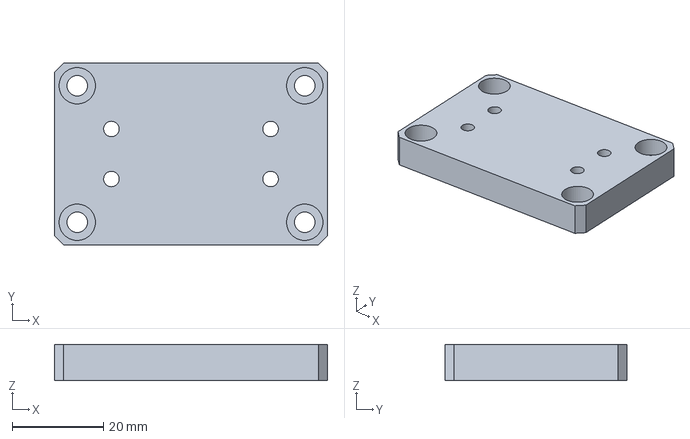
[picture p184: CAD file, 2026-06-03]
DataFlow/01.RawPDFWithSTEP/output_machined_plate.step
60.0 x 40.0 x 8.00 mm
