Tony-LeoN/LLM-CADCoder/DataFlow/01.RawPDFWithSTEP/32HA1321-002-006.step

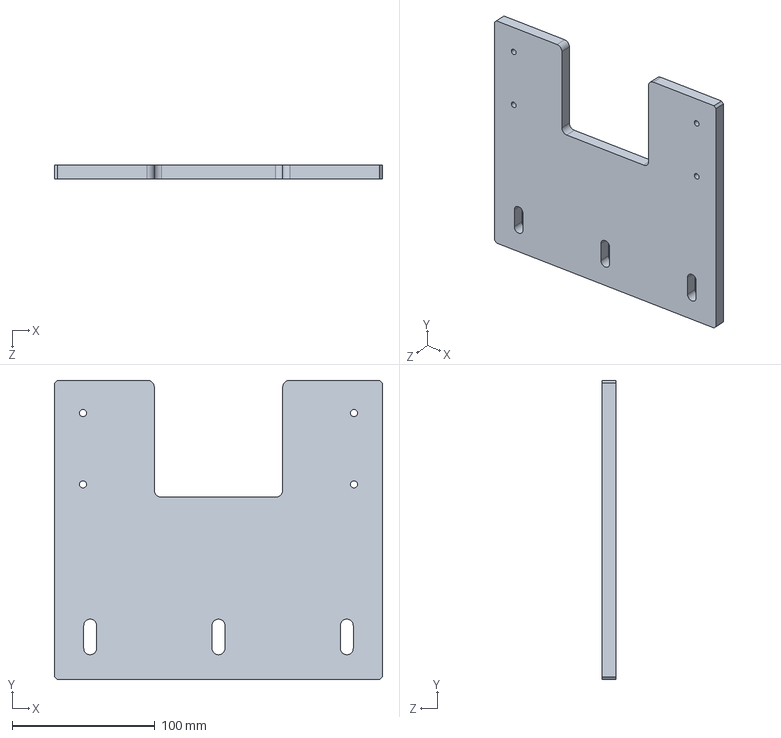
[picture p185: CAD file, 2026-06-03]
DataFlow/01.RawPDFWithSTEP/32HA1321-002-006.step
230.0 x 210.0 x 10.0 mm
