Tony-LeoN/LLM-CADCoder/DataFlow/01.RawPDFWithSTEP/X445-16-036-A.STEP

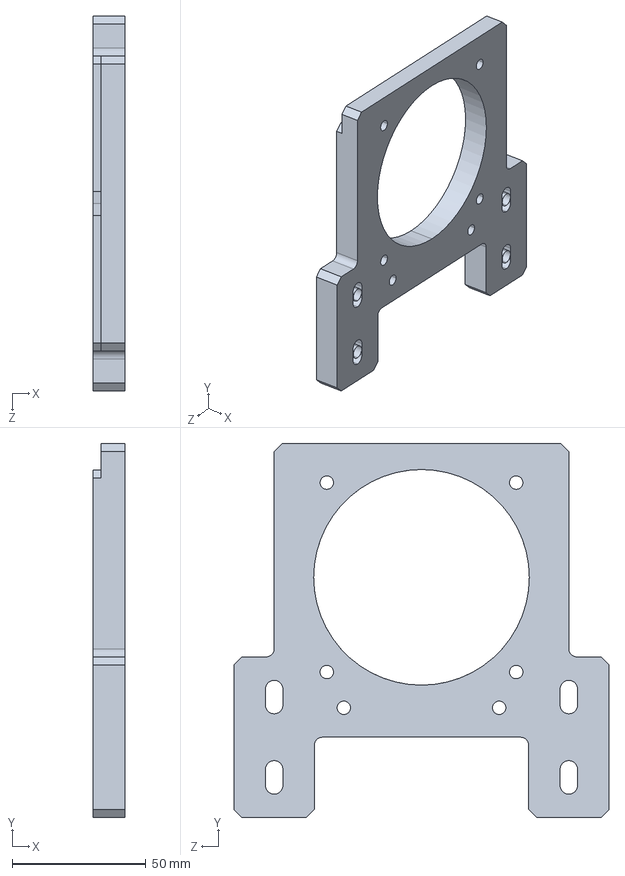
[picture p186: CAD file, 2026-06-03]
DataFlow/01.RawPDFWithSTEP/X445-16-036-A.STEP
12.0 x 139.7 x 140.0 mm
