Tony-LeoN/LLM-CADCoder/DataFlow/01.RawPDFWithSTEP/X468-02-049-A.STEP

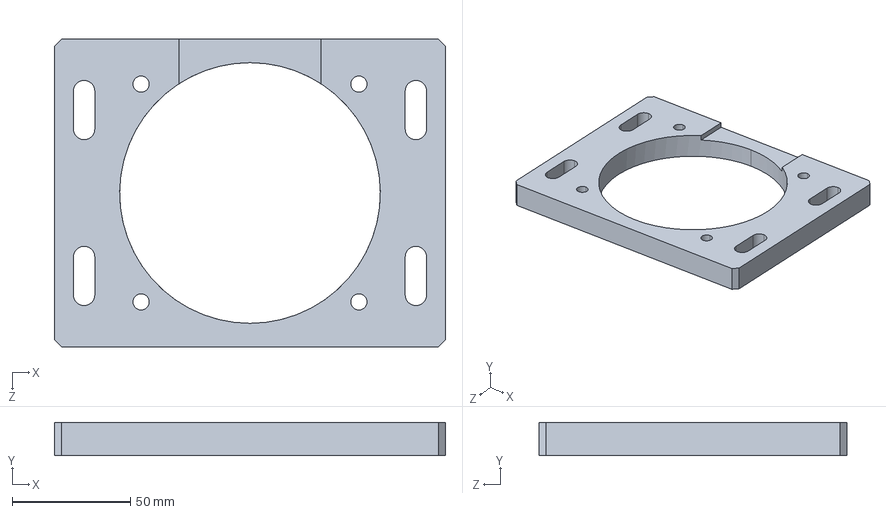
[picture p187: CAD file, 2026-06-03]
DataFlow/01.RawPDFWithSTEP/X468-02-049-A.STEP
165.0 x 14.0 x 130.0 mm
