Tony-LeoN/LLM-CADCoder/DataFlow/01.RawPDFWithSTEP/X350-16-039-A.STEP

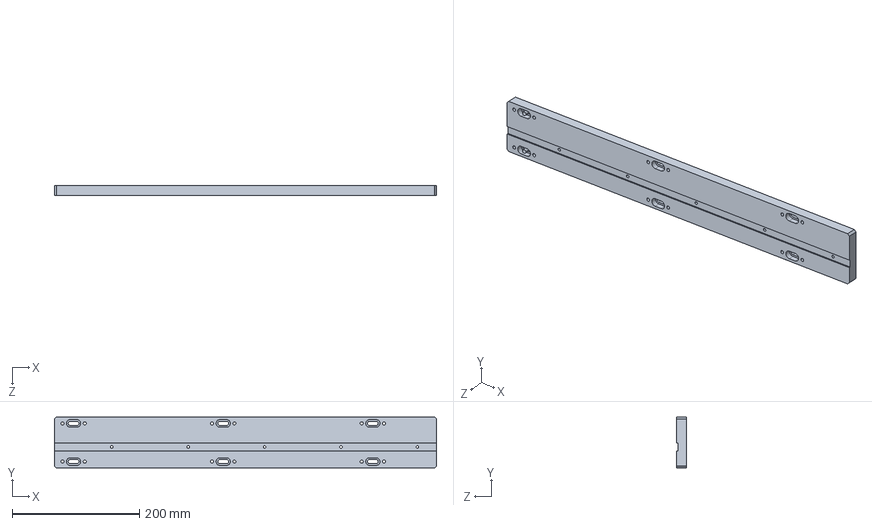
[picture p188: CAD file, 2026-06-03]
DataFlow/01.RawPDFWithSTEP/X350-16-039-A.STEP
600.0 x 80.0 x 15.0 mm
