Tony-LeoN/LLM-CADCoder/DataFlow/01.RawPDFWithSTEP/X350-16-042-A.STEP

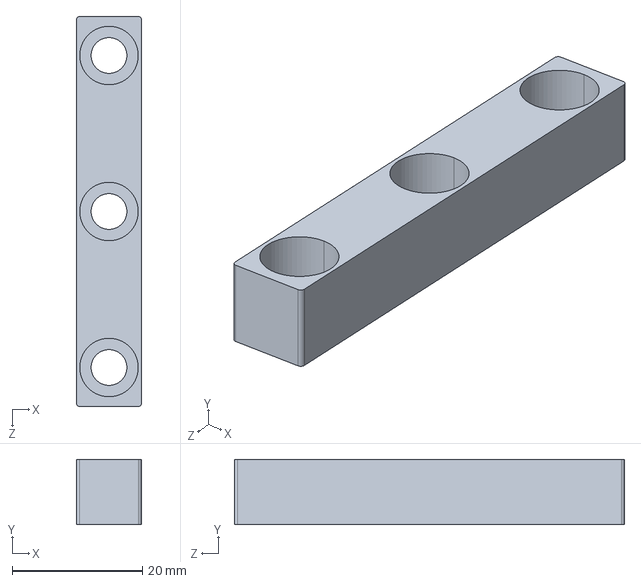
[picture p189: CAD file, 2026-06-03]
DataFlow/01.RawPDFWithSTEP/X350-16-042-A.STEP
10.0 x 10.0 x 60.0 mm
