Tony-LeoN/LLM-CADCoder/DataFlow/01.RawPDFWithSTEP/X350-13-036-A.STEP

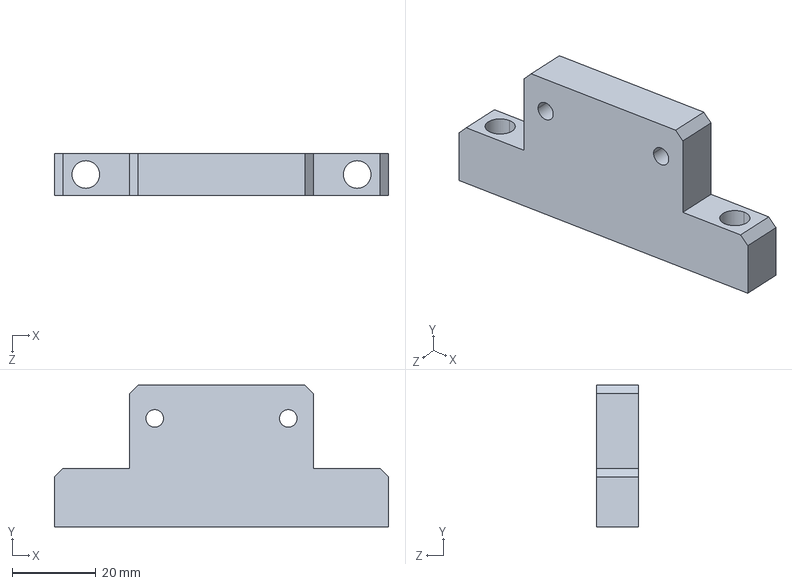
[picture p191: CAD file, 2026-06-03]
DataFlow/01.RawPDFWithSTEP/X350-13-036-A.STEP
80.0 x 34.0 x 10.0 mm
