Tony-LeoN/LLM-CADCoder/(list of files, cad)

Other CAD files:
DataFlow/01.RawPDFWithSTEP/X350-05-070-A-CQ.step
DataFlow/01.RawPDFWithSTEP/X350-05-070-A.STEP
DataFlow/01.RawPDFWithSTEP/M001-08-006-B.STEP
DataFlow/01.RawPDFWithSTEP/M001-10-003-A.STEP
DataFlow/01.RawPDFWithSTEP/X350-05-070-A.FCStd
