Tony-LeoN/LLM-CADCoder/DataFlow/01.RawPDFWithSTEP/010加强条.pdf

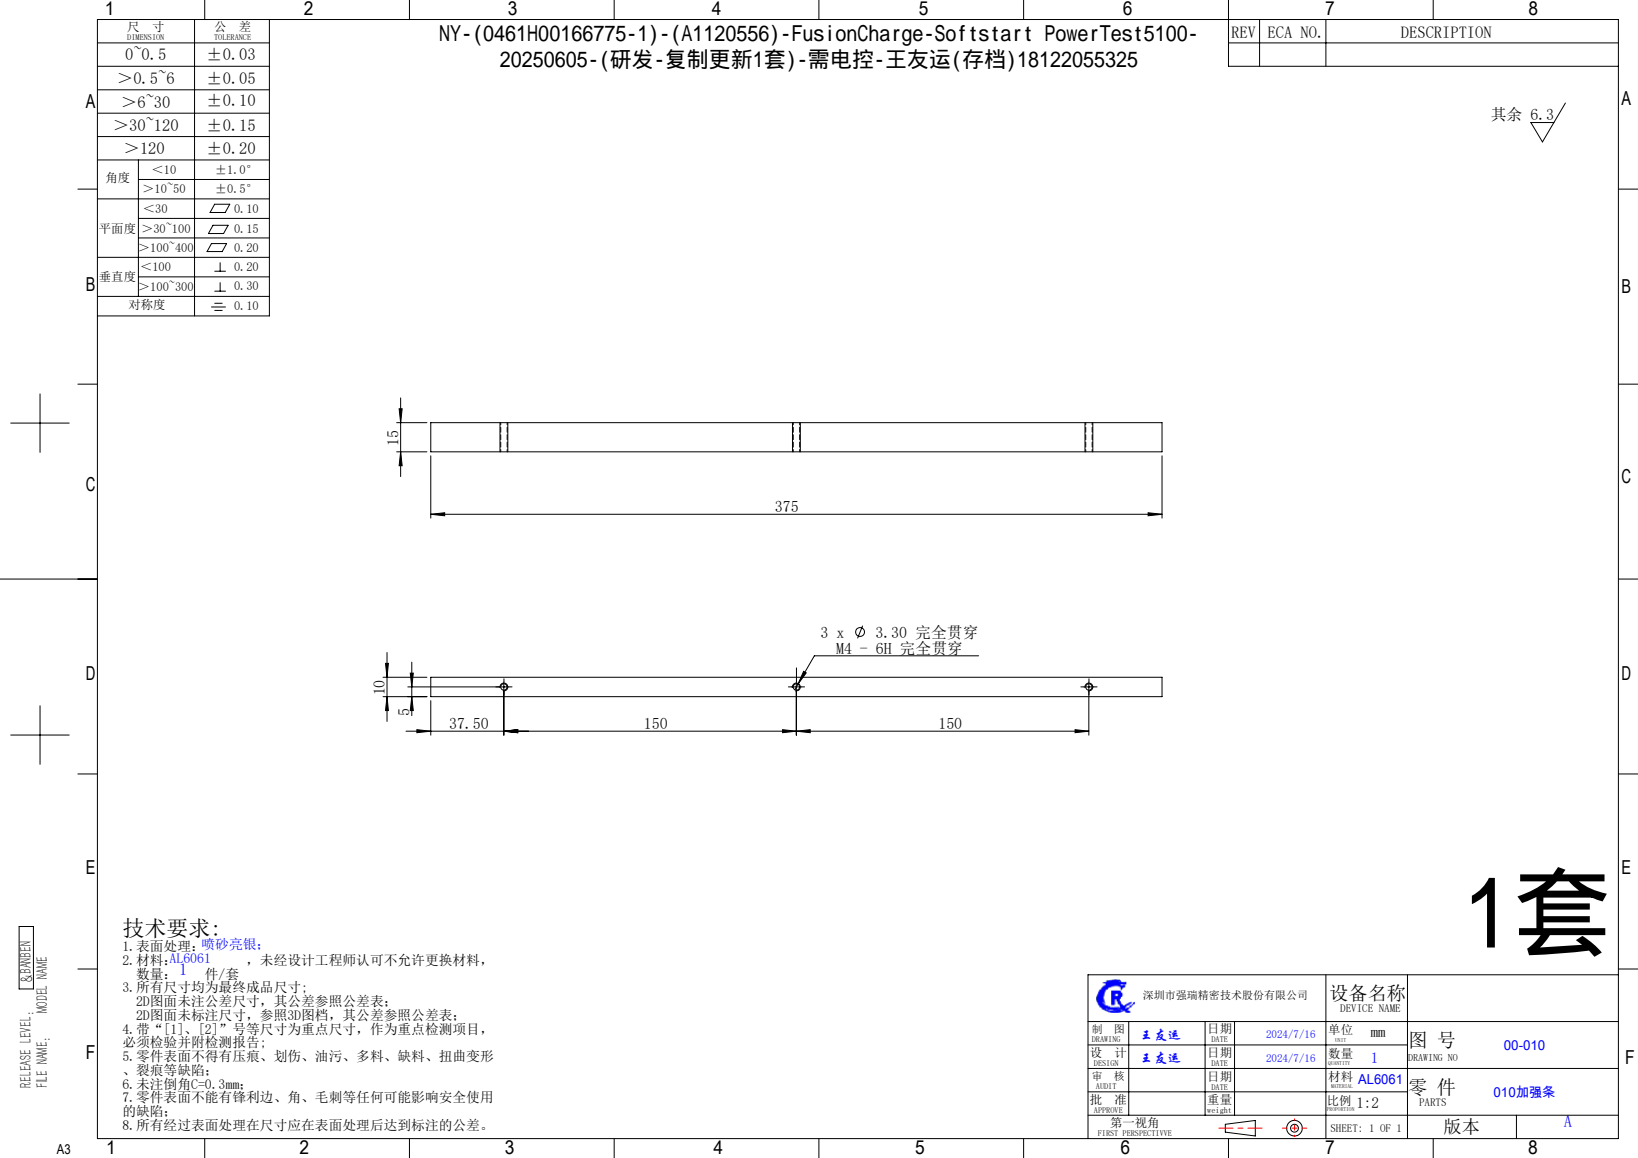
[picture p192: page 1]
3.30 完全贯穿; M4 - 6H 完全贯穿; DEVICE NAME; REV; ECA NO. 尺 寸 DIMENSION; 公 差 TOLERANCE; 设 计 DESIGN; 批 准 APPROVE; 日期 DATE; 单位 UNIT; 材料 MATERIAL; SHEET: 1 OF 1; DRAWING NO 零 件

NY-(0461H00166775-1)-(A1120556)-FusionCharge-Softstart PowerTest5100-
20250605-(研发-复制更新1套)-需电控-王友运(存档)18122055325

RELEASE LEVEL: &BANBEN

FILE NAME: MODEL NAME

第一视角 FIRST PERSPECTIVVE
