Tony-LeoN/LLM-CADCoder/DataFlow/01.RawPDFWithSTEP/32HA1321-002-006.pdf

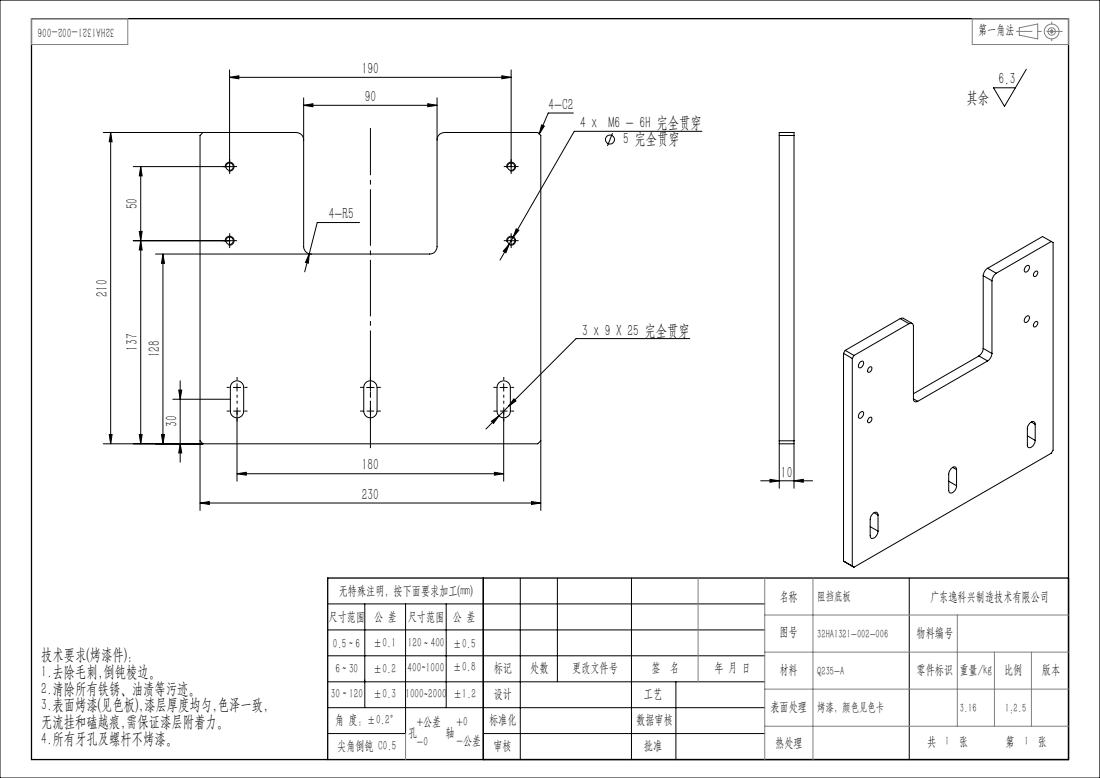
[picture p194: page 1]
尺寸范围; 尖角倒钝 C0.5; 更改文件号; 4 x M6 - 6H 完全贯穿 5 完全贯穿; 3 x 9 X 25 完全贯穿

无特殊注明，按下面要求加工(mm)

技术要求(烤漆件):
1.去除毛刺,倒钝棱边。
2.清除所有铁锈、油渍等污迹。
3.表面烤漆(见色板),漆层厚度均匀,色泽一致,
无流挂和磕越痕,需保证漆层附着力。
4.所有牙孔及螺杆不烤漆。
