Tony-LeoN/LLM-CADCoder/DataFlow/01.RawPDFWithSTEP/M001-08-006-B.pdf

90
4-C2

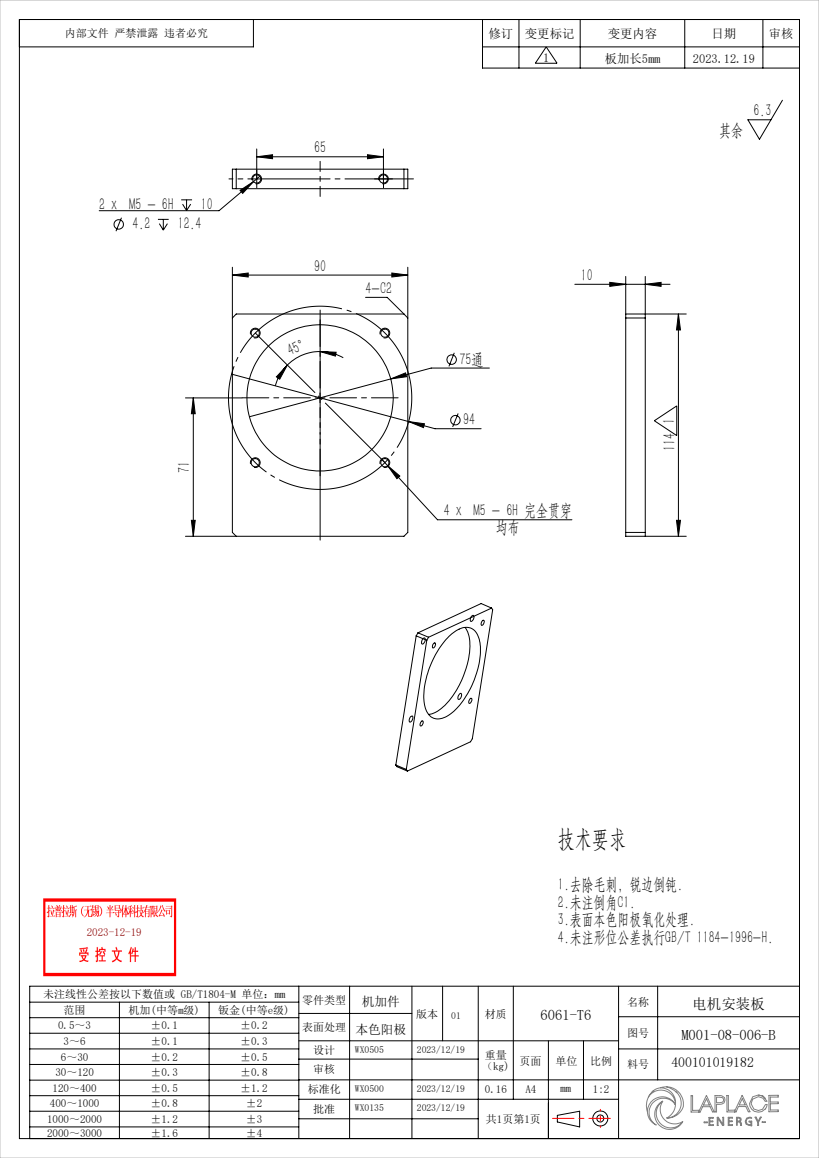
[picture p195: page 1]
4 x M5 - 6H 完全贯穿 均布; 技术要求; 1.去除毛刺，锐边倒钝. 2.未注倒角C1. 3.表面本色阳极氧化处理. 4.未注形位公差执行GB/T 1184-1996-H.; 机加(中等m级); 钣金(中等e级); 未注线性公差按以下数值或 GB/T1804-M 单位：mm; 零件类型; 表面处理; 标准化; 电机安装板; 机加件; 本色阳极

内部文件 严禁泄露 违者必究

修订 | 变更标记 | 变更内容 | 日期 | 审核

1 | 板加长5mm | 2023.12.19
