Tony-LeoN/LLM-CADCoder/DataFlow/01.RawPDFWithSTEP/M001-10-003-A.pdf

45
35

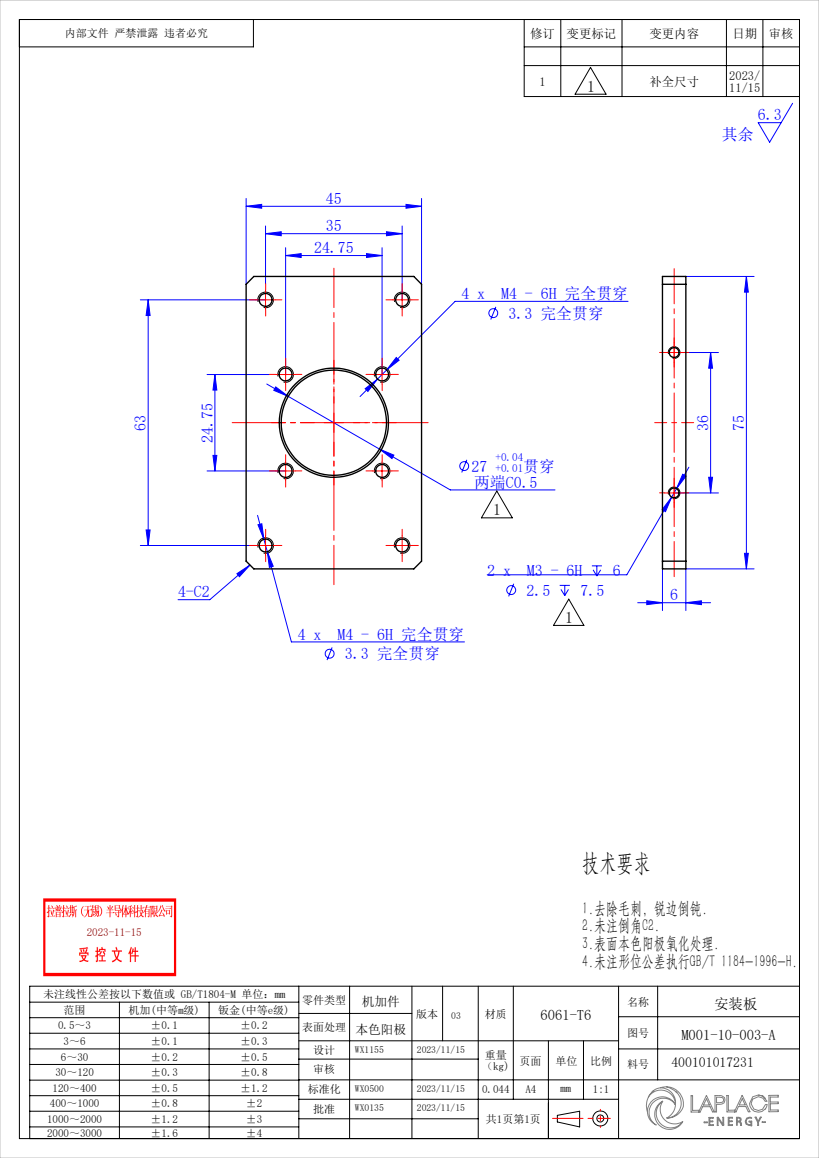
[picture p196: page 1]
4 x M4 - 6H 完全贯穿 3.3 完全贯穿; 0.04 0.01贯穿 两端C0.5; 技术要求; 1.去除毛刺，锐边倒钝. 2.未注倒角C2. 3.表面本色阳极氧化处理. 4.未注形位公差执行GB/T 1184-1996-H.; 变更标记; 变更内容; 补全尺寸; 机加(中等m级); 钣金(中等e级); 未注线性公差按以下数值或 GB/T1804-M 单位：mm; 零件类型; 表面处理; 标准化; 安装板; 机加件; 本色阳极

内部文件 严禁泄露 违者必究
