Tony-LeoN/LLM-CADCoder/DataFlow/01.RawPDFWithSTEP/NE3436-3002011-002A防撞块.pdf

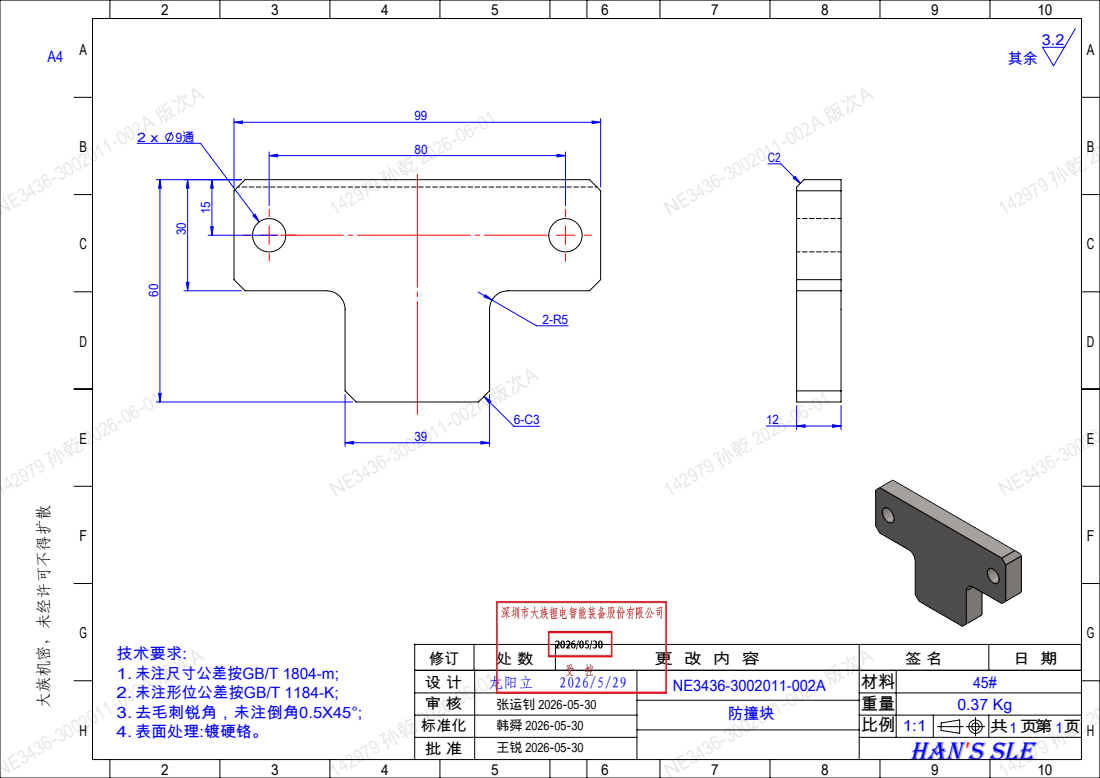
[picture p197: page 1]
han s sle '; 1.未注尺寸公差按GB/T 1804-m; 2.未注形位公差按GB/T 1184-K;; 张运钊 2026-05-30; 韩舜 2026-05-30 NE3436-3002011-002A 版次A 142979 孙乾 2026-06-01; NE3436-3002011-002A 版次A
