Tony-LeoN/LLM-CADCoder/DataFlow/01.RawPDFWithSTEP/X350-05-070-A.pdf

60
50

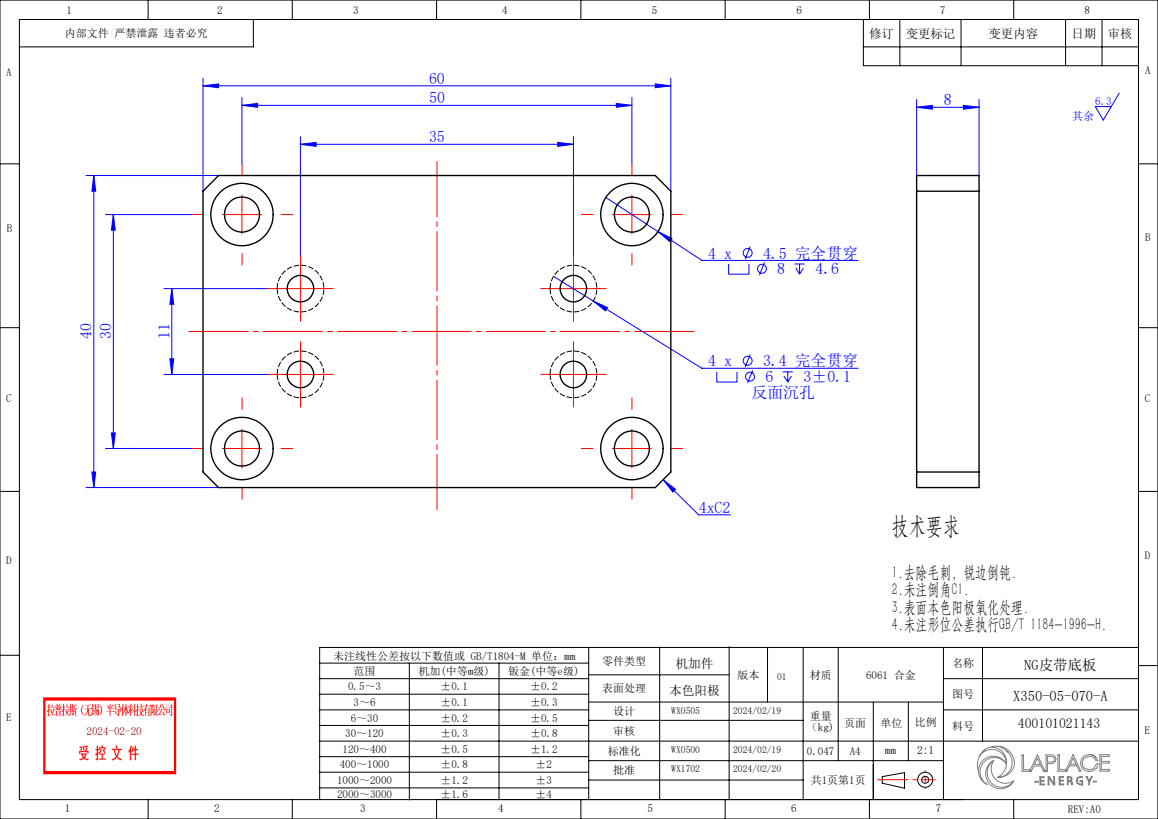
[picture p199: page 1]
4.5 完全贯穿; 3.4 完全贯穿; 反面沉孔; 技术要求; 1.去除毛刺，锐边倒钝. 2.未注倒角C1. 3.表面本色阳极氧化处理. 4.未注形位公差执行GB/T 1184-1996-H.; 变更标记; 变更内容; 标准化; 表面处理; 零件类型; REV:A0; 未注线性公差按以下数值或 GB/T1804-M 单位：mm; 机加(中等m级); 钣金(中等e级); NG皮带底板; 机加件; 本色阳极

内部文件 严禁泄露 违者必究
