Tony-LeoN/LLM-CADCoder/DataFlow/01.RawPDFWithSTEP/X350-05-071-A.pdf

60

12.5 | 35

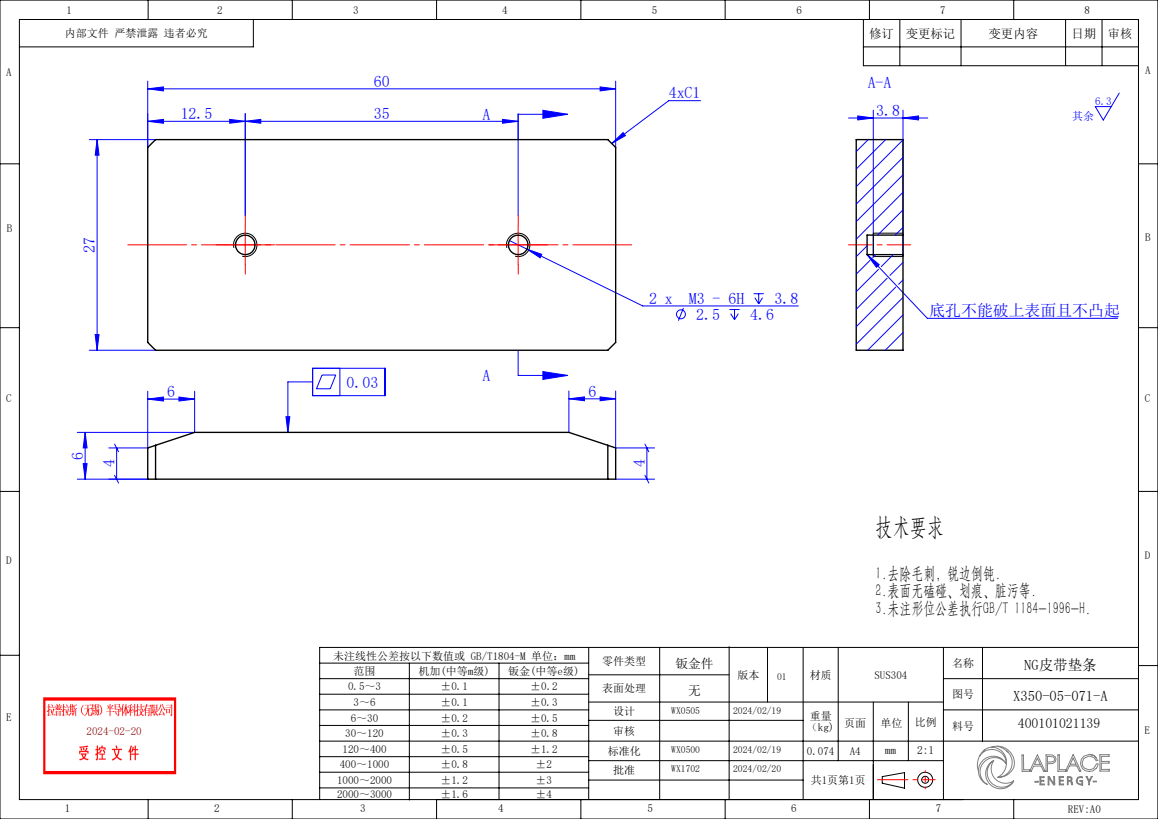
[picture p200: page 1]
底孔不能破上表面且不凸起; 技术要求; 变更标记; 变更内容; 标准化; 表面处理; 零件类型; REV:A0; 未注线性公差按以下数值或 GB/T1804-M 单位：mm; 机加(中等m级); 钣金(中等e级); NG皮带垫条; SUS304; 钣金件

内部文件 严禁泄露 违者必究

1.去除毛刺，锐边倒钝.
2.表面无磕碰、划痕、脏污等.
3.未注形位公差执行GB/T 1184-1996-H.
