Tony-LeoN/LLM-CADCoder/DataFlow/01.RawPDFWithSTEP/X350-13-036-A.pdf

32

44

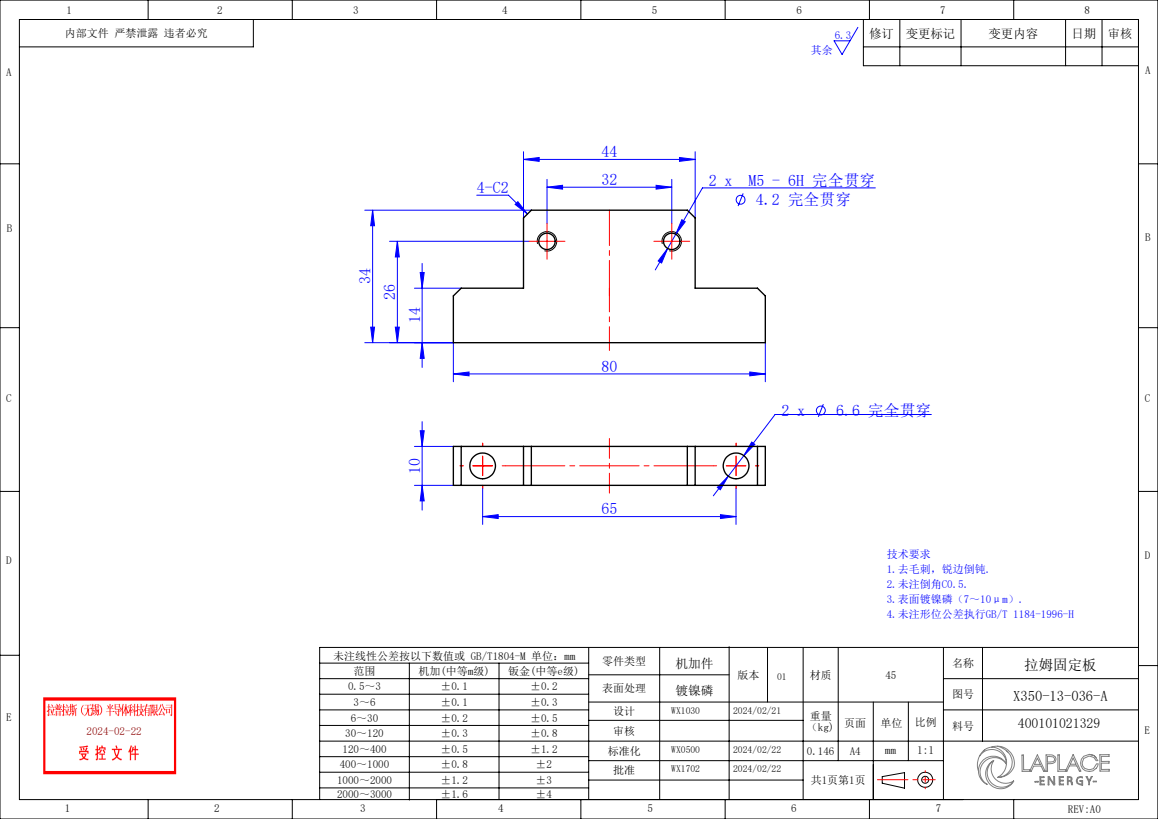
[picture p201: page 1]
2 x M5 - 6H 完全贯穿; 4.2 完全贯穿; 6.6 完全贯穿; 技术要求 1.去毛刺，锐边倒钝. 2.未注倒角C0.5. 3.表面镀镍磷（7～10μm）. 4.未注形位公差执行GB/T 1184-1996-H; 变更标记; 变更内容; 标准化; 表面处理; 零件类型; REV:A0; 未注线性公差按以下数值或 GB/T1804-M 单位：mm; 机加(中等m级); 钣金(中等e级); 拉姆固定板; 机加件; 镀镍磷

内部文件 严禁泄露 违者必究
