Tony-LeoN/LLM-CADCoder/DataFlow/01.RawPDFWithSTEP/X350-16-042-A.pdf

3 x | 5.5 完全贯穿
9 | 5.7

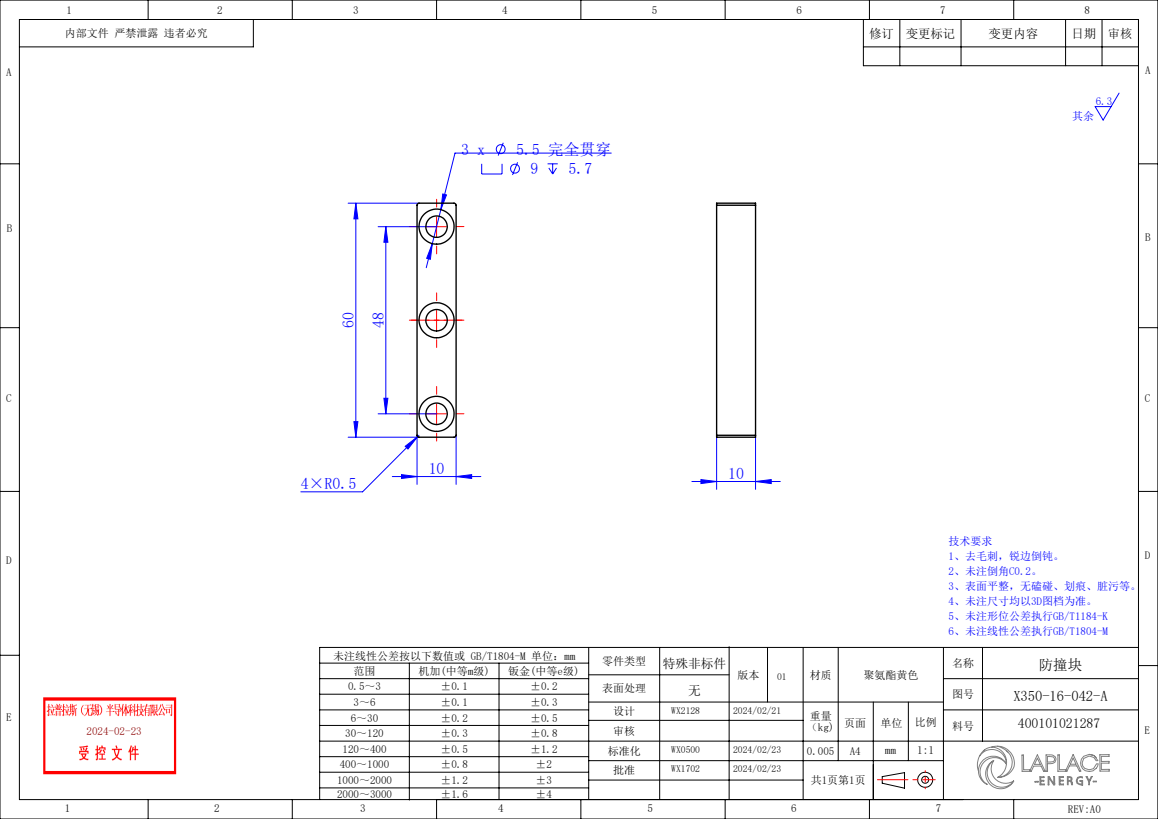
[picture p203: page 1]
技术要求 1、去毛刺，锐边倒钝。 2、未注倒角C0.2。 3、表面平整，无磕碰、划痕、脏污等。 4、未注尺寸均以3D图档为准。 5、未注形位公差执行GB/T1184-K 6、未注线性公差执行GB/T1804-M; 变更标记; 变更内容; 标准化; 表面处理; 零件类型; REV:A0; 未注线性公差按以下数值或 GB/T1804-M 单位：mm; 机加(中等m级); 钣金(中等e级); 防撞块; 聚氨酯黄色; 特殊非标件

内部文件 严禁泄露 违者必究
