Tony-LeoN/LLM-CADCoder/DataFlow/01.RawPDFWithSTEP/X445-02-002-A.pdf

90

26

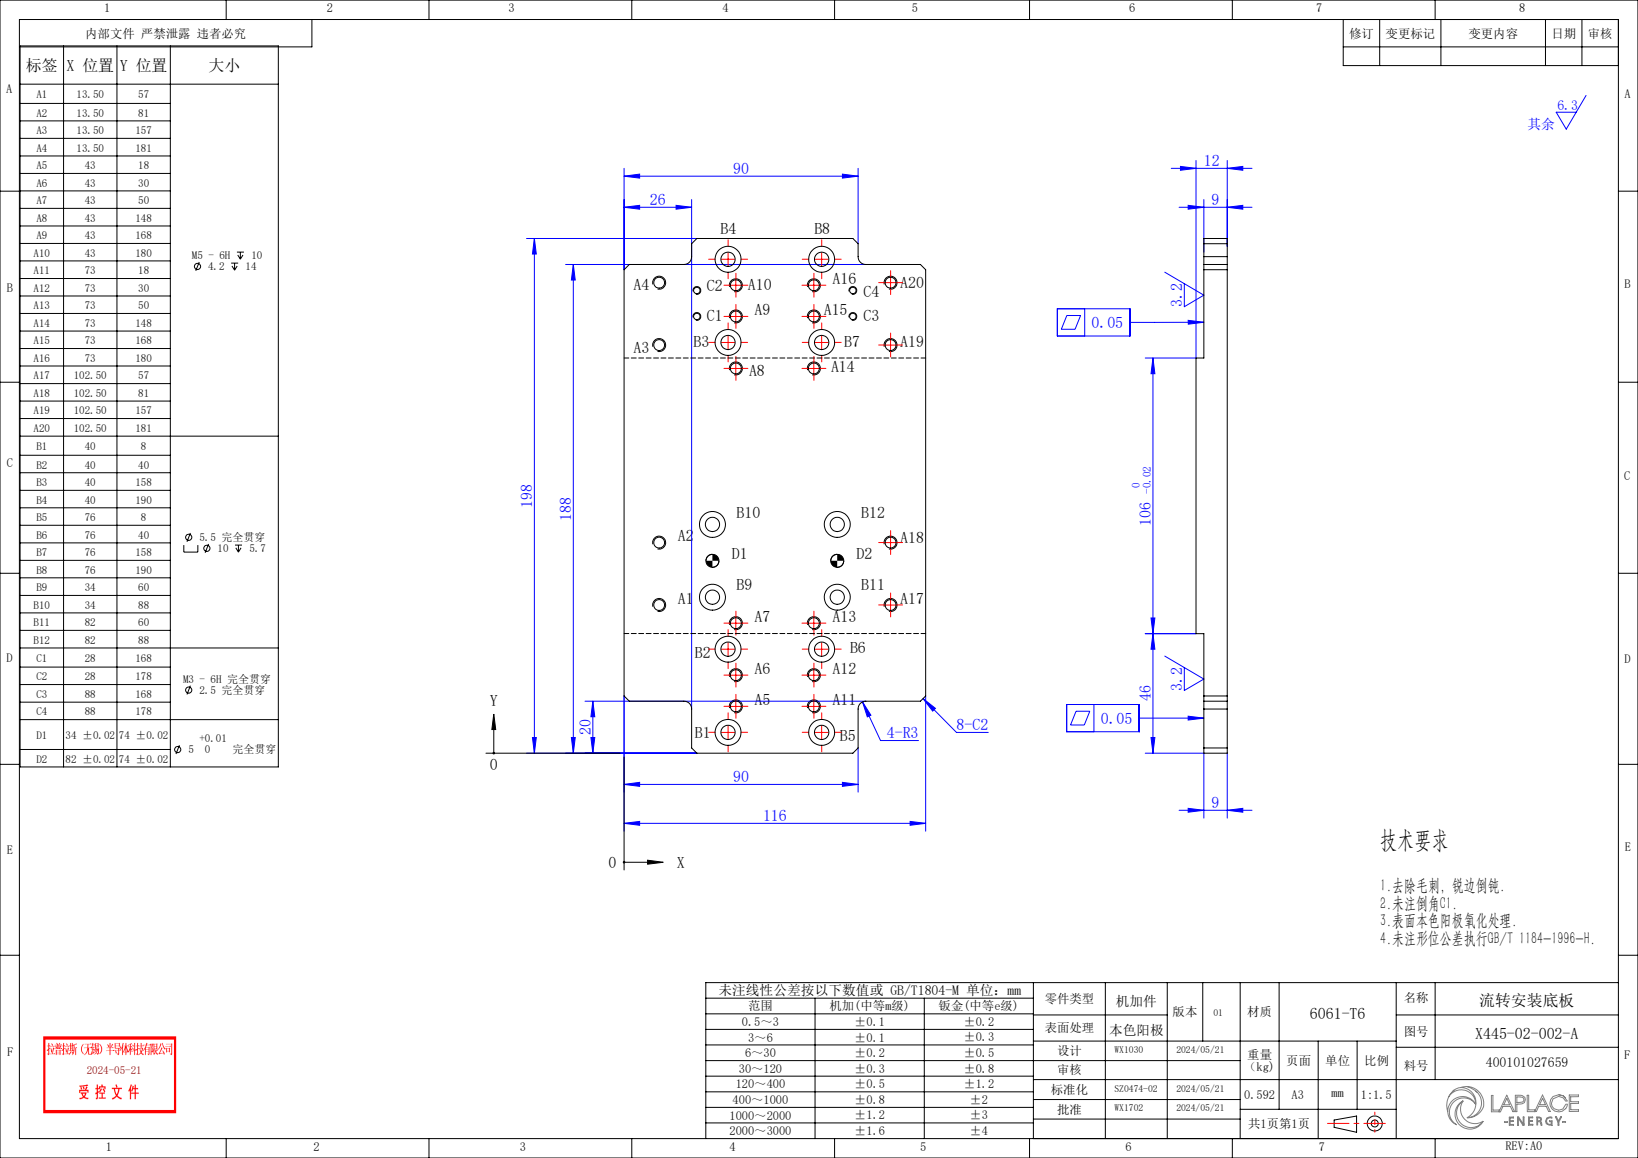
[picture p204: page 1]
技术要求; 1.去除毛刺，锐边倒钝. 2.未注倒角C1. 3.表面本色阳极氧化处理. 4.未注形位公差执行GB/T 1184-1996-H.; 零件类型; 表面处理; 标准化; REV:A0; 机加(中等m级); 钣金(中等e级); 未注线性公差按以下数值或 GB/T1804-M 单位：mm; 流转安装底板; 机加件; 本色阳极

内部文件 严禁泄露 违者必究

修订 | 变更标记 | 变更内容 | 日期 | 审核

A1 | 13.50 | 57
A2 | 13.50 | 81
A3 | 13.50 | 157
A4 | 13.50 | 181
A5 | 43 | 18
A6 | 43 | 30
A7 | 43 | 50
A8 | 43 | 148
A9 | 43 | 168
A10 | 43 | 180
A11 | 73 | 18
A12 | 73 | 30
A13 | 73 | 50
A14 | 73 | 148
A15 | 73 | 168
A16 | 73 | 180
A17 | 102.50 | 57
A18 | 102.50 | 81
A19 | 102.50 | 157
A20 | 102.50 | 181
B1 | 40 | 8 | 5.5 完全贯穿
B2 | 40 | 40
B3 | 40 | 158
B4 | 40 | 190
B5 | 76 | 8
B6 | 76 | 40

B7 | 76 | 158
B8 | 76 | 190
B9 | 34 | 60
B10 | 34 | 88
B11 | 82 | 60
B12 | 82 | 88
C1 | 28 | 168 | M3 - 6H 完全贯穿 2.5 完全贯穿
C2 | 28 | 178
C3 | 88 | 168

D1 | 34 ±0.02 | 74 ±0.02 | +0.01 5 0 完全贯穿
