Tony-LeoN/LLM-CADCoder/DataFlow/01.RawPDFWithSTEP/X445-10-029-A.pdf

456

4.5

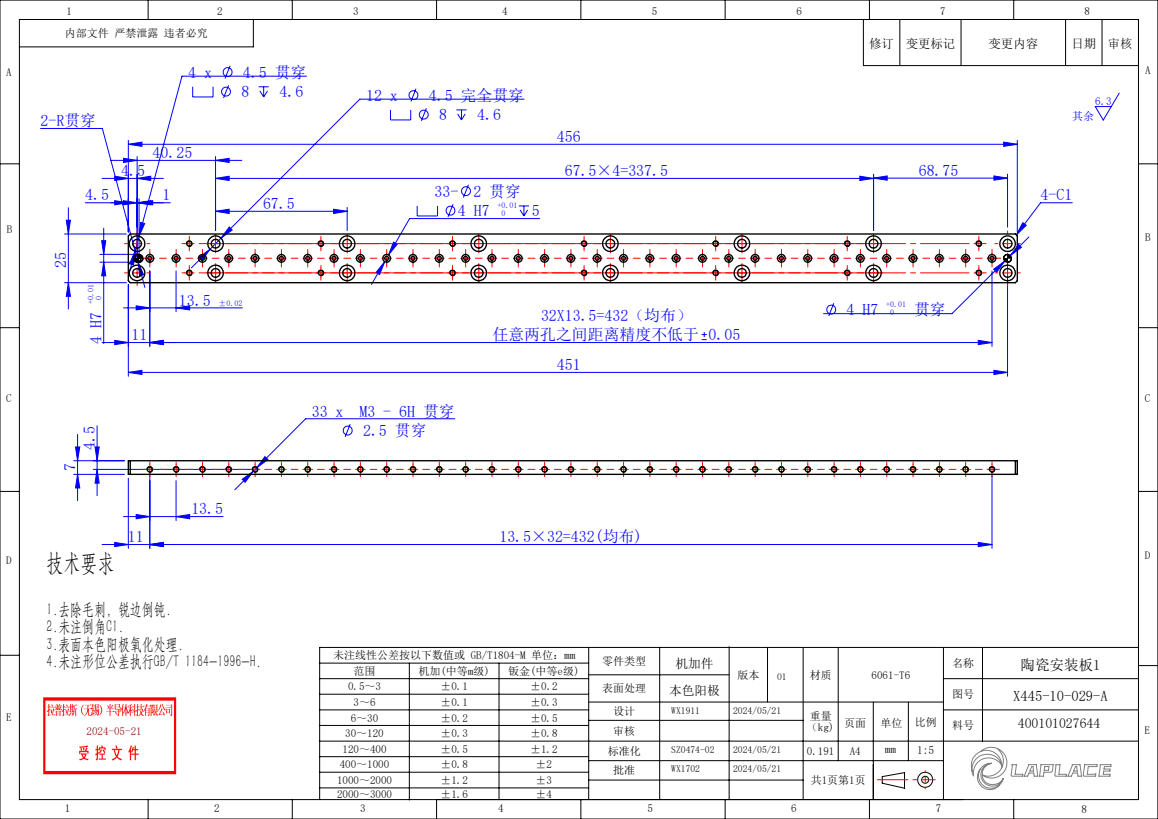
[picture p205: page 1]
2-R贯穿; 4.5 完全贯穿; 32X13.5=432（均布） 任意两孔之间距离精度不低于 0.05; 技术要求; 1.去除毛刺，锐边倒钝. 2.未注倒角C1. 3.表面本色阳极氧化处理. 4.未注形位公差执行GB/T 1184-1996-H.; 变更标记; 变更内容; 标准化; 表面处理; 零件类型; 未注线性公差按以下数值或 GB/T1804-M 单位：mm; 机加(中等m级); 钣金(中等e级); 陶瓷安装板1; 机加件; 本色阳极

内部文件 严禁泄露 违者必究
