Tony-LeoN/LLM-CADCoder/DataFlow/01.RawPDFWithSTEP/X445-13-005-A.pdf

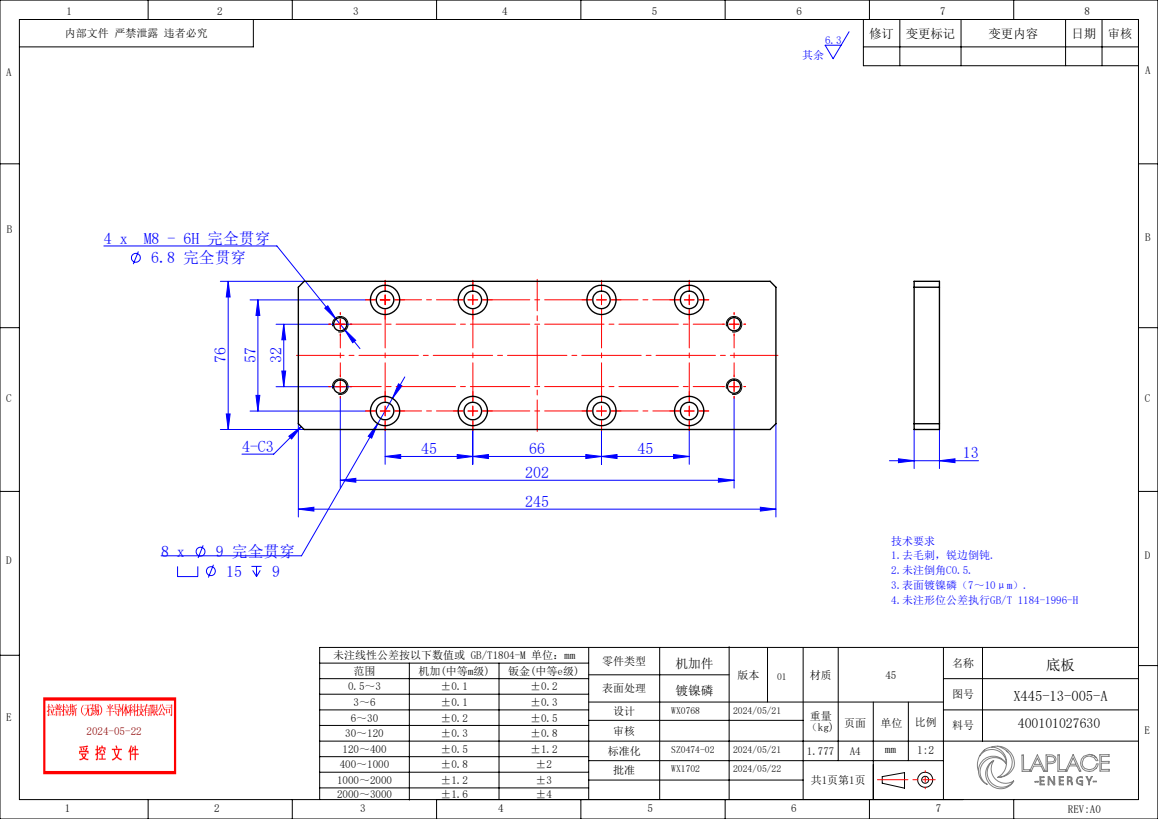
[picture p206: page 1]
4 x M8 - 6H 完全贯穿 6.8 完全贯穿; 9 完全贯穿; 技术要求 1.去毛刺，锐边倒钝. 2.未注倒角C0.5. 3.表面镀镍磷（7～10μm）. 4.未注形位公差执行GB/T 1184-1996-H; 变更标记; 变更内容; 标准化; 表面处理; 零件类型; REV:A0; 未注线性公差按以下数值或 GB/T1804-M 单位：mm; 机加(中等m级); 钣金(中等e级); 机加件; 镀镍磷

内部文件 严禁泄露 违者必究
