Tony-LeoN/LLM-CADCoder/DataFlow/01.RawPDFWithSTEP/X468-02-049-A.pdf

165

60 3

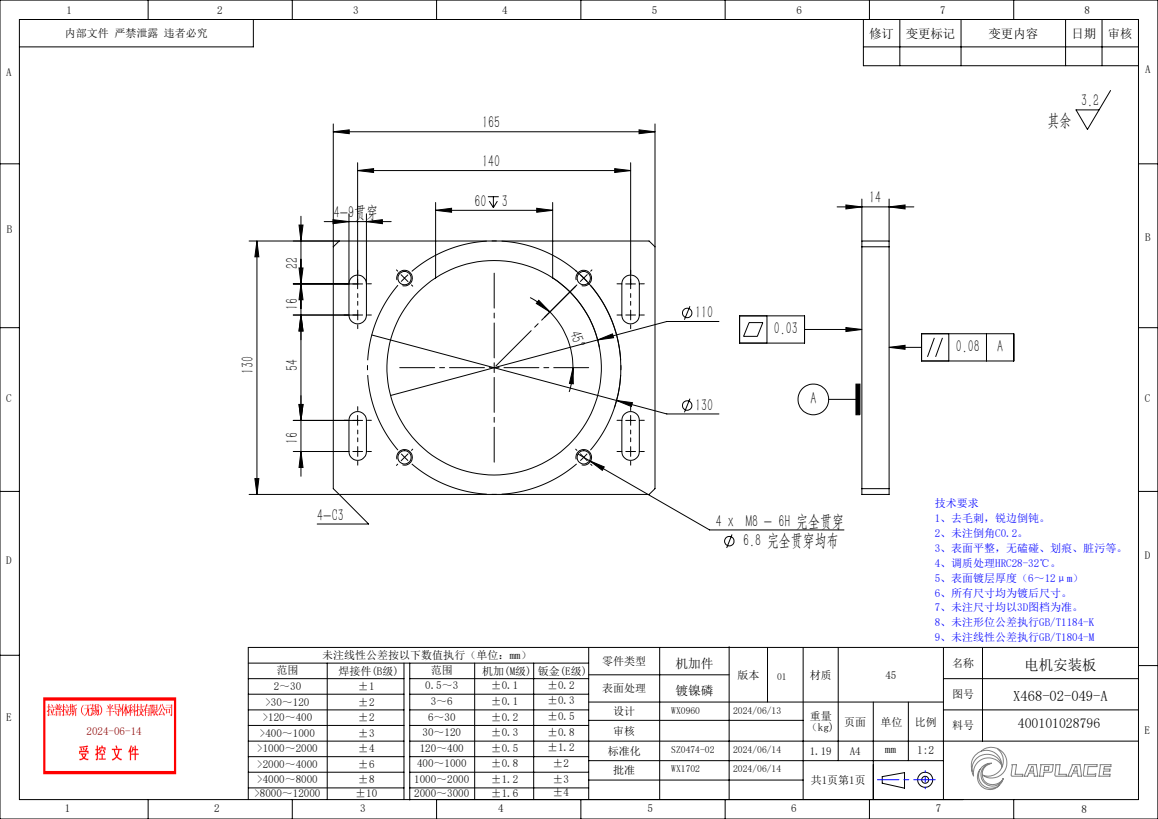
[picture p208: page 1]
4 x M8 - 6H 完全贯穿 6.8 完全贯穿均布; 技术要求 1、去毛刺，锐边倒钝。 2、未注倒角C0.2。 3、表面平整，无磕碰、划痕、脏污等。 4、调质处理HRC28-32℃。 5、表面镀层厚度（6～12μm） 6、所有尺寸均为镀后尺寸。 7、未注尺寸均以3D图档为准。 8、未注形位公差执行GB/T1184-K 9、未注线性公差执行GB/T1804-M; 变更标记; 变更内容; 标准化; 表面处理; 零件类型; 未注线性公差按以下数值执行（单位：mm）; 电机安装板; 机加件; 镀镍磷; 焊接件(B级)

内部文件 严禁泄露 违者必究
