Tony-LeoN/LLM-CADCoder/DataFlow/01.RawPDFWithSTEP/X476-04-002-A.pdf

12 x | 5.5 完全贯穿
10 | 5.7

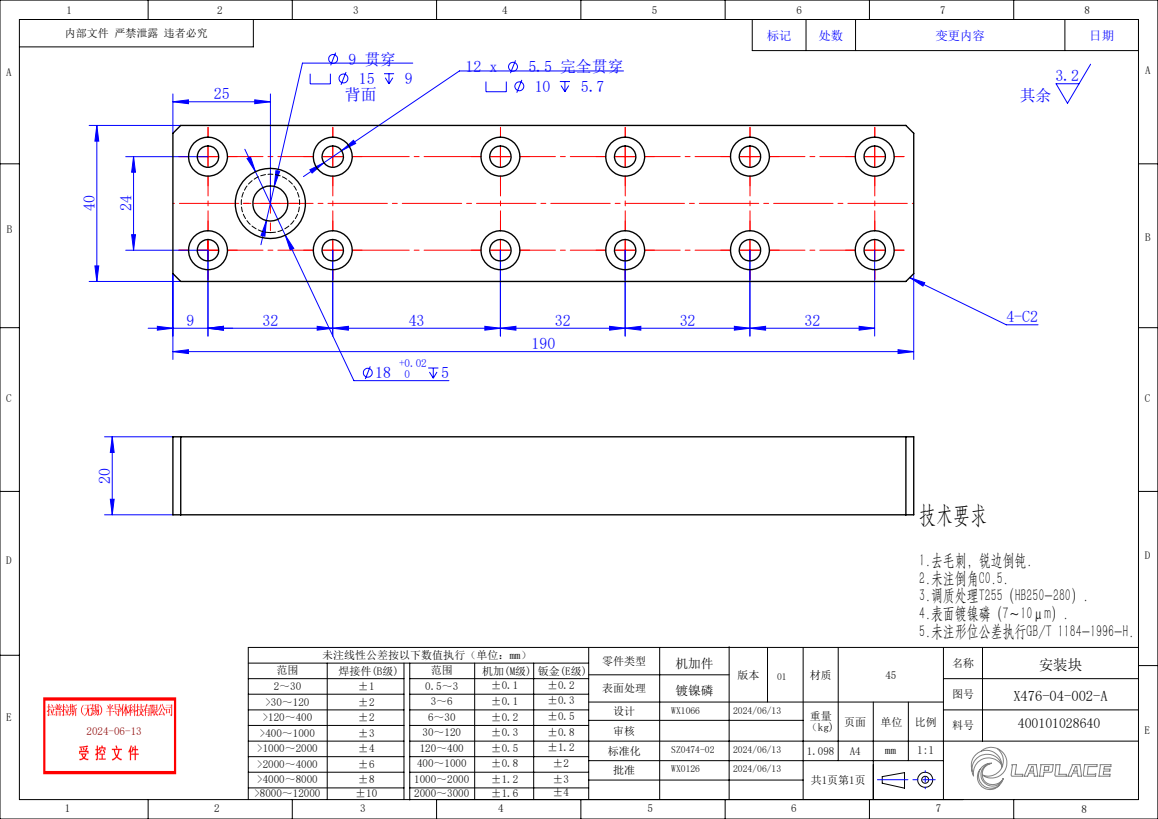
[picture p209: page 1]
技术要求; 1.去毛刺，锐边倒钝. 2.未注倒角C0.5. 3.调质处理T255（HB250-280）. 4.表面镀镍磷（7～10μm）. 5.未注形位公差执行GB/T 1184-1996-H.; 变更内容; 标准化; 表面处理; 零件类型; 未注线性公差按以下数值执行（单位：mm）; 安装块; 机加件; 镀镍磷; 焊接件(B级)

内部文件 严禁泄露 违者必究
