Tony-LeoN/LLM-CADCoder/DataFlow/01.RawPDFWithSTEP/X476-07-011-C.pdf

## 4 x 13.5 完全贯穿

1

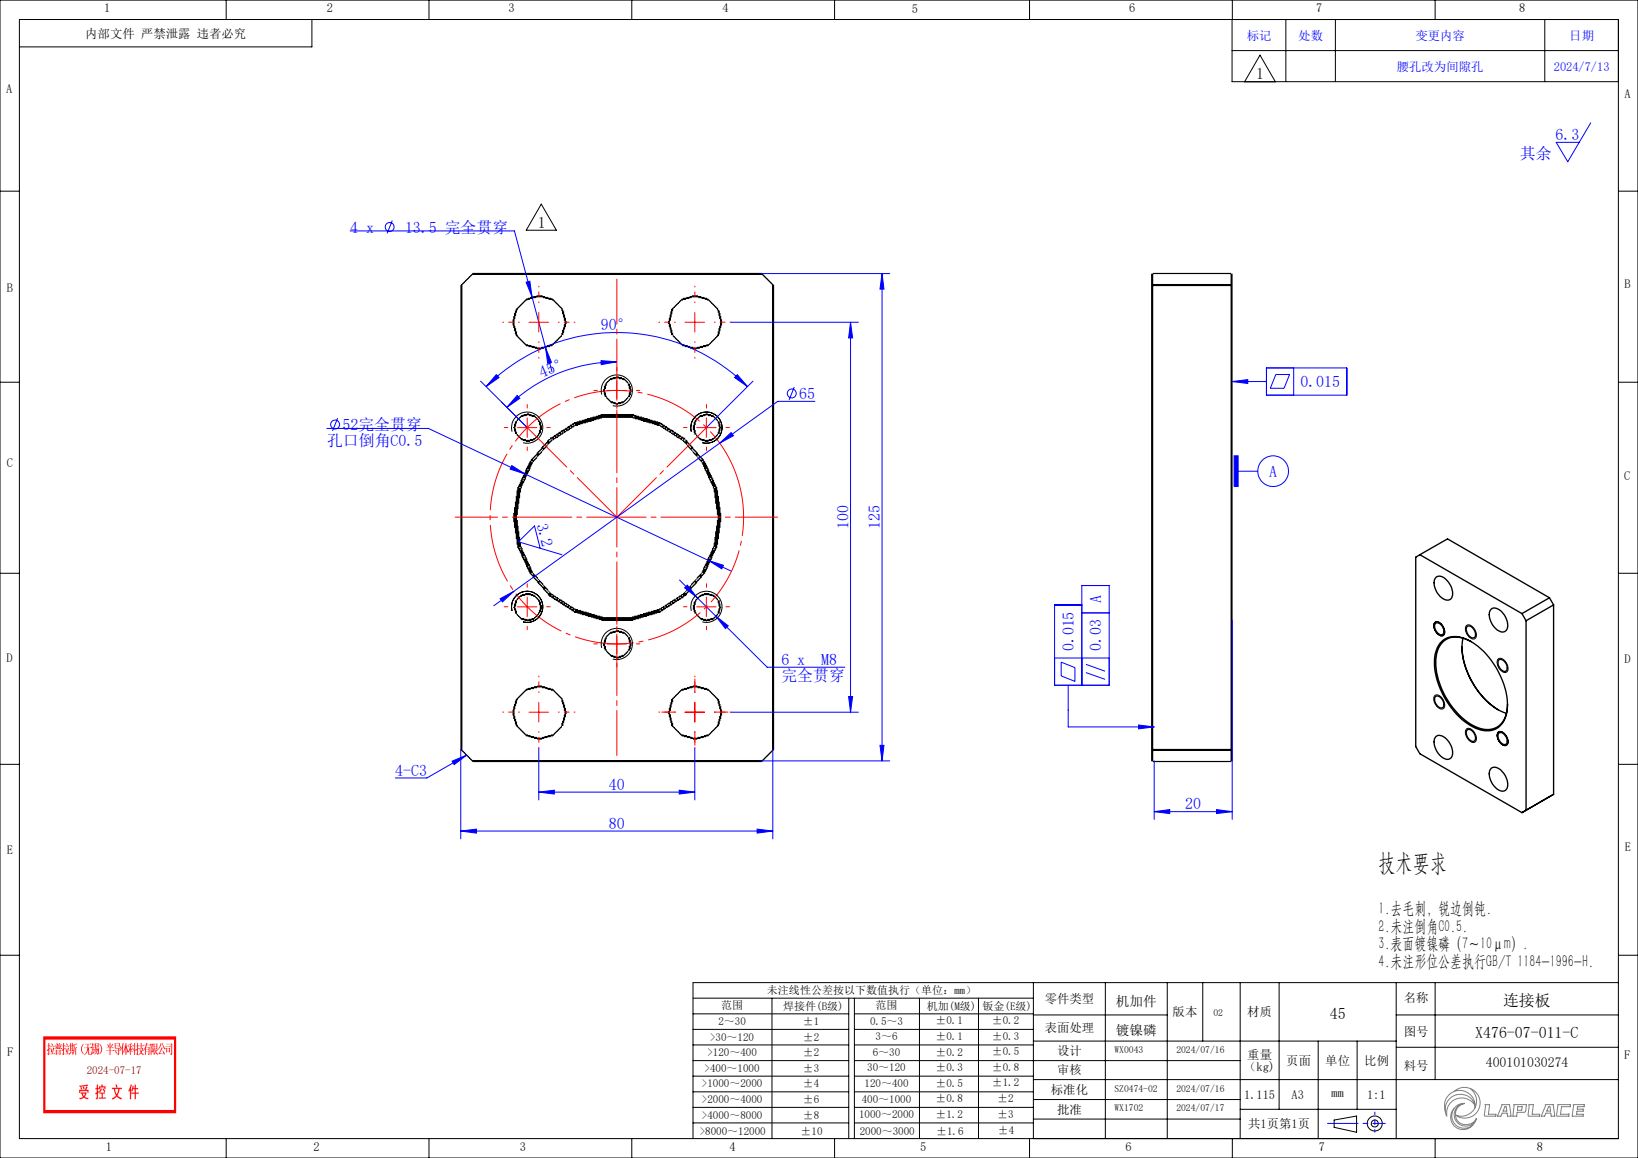
[picture p210: page 1]
6 x M8 完全贯穿; 52完全贯穿 孔口倒角C0.5; 技术要求; 1.去毛刺，锐边倒钝. 2.未注倒角C0.5. 3.表面镀镍磷（7～10μm）. 4.未注形位公差执行GB/T 1184-1996-H.; 零件类型; 表面处理; 标准化; 连接板; 机加件; 镀镍磷; 焊接件(B级); 未注线性公差按以下数值执行（单位：mm）

内部文件 严禁泄露 违者必究

标记 | 处数 | 变更内容 | 日期

1 | | 腰孔改为间隙孔 | 2024/7/13
