Tony-LeoN/LLM-CADCoder/(commit log)

2026-06-03 初始化项目
    [010加强条.step, 011加强条.step, 32HA1252-008-040.step, 32HA1321-002-006.step, M001-08-006-B.STEP, M001-10-003-A.STEP, NE3436-3002011-002A防撞块.step, X262-07-013-A.STEP]
2026-06-04 设置千问2.5VL模型和路径参数，跑通第一部分推理。
    [samples.csv]
2026-06-04 防止OOM调整参数
2026-06-04 细化提示词
2026-06-04 修改提示词
2026-06-04 补充提示词和benchmark_small的gt
2026-06-04 增加图纸layout分析分析模块
2026-06-04 增加测试图纸
2026-06-05 调整overlay相关算法
2026-06-05 修改表格识别过滤规则
2026-06-05 设计简化版的CADquery生成流，增加一些测试脚本
2026-06-05 增加CQ代码生成模块
2026-06-06 修复生成cq代码时产生环境的问题
2026-06-08 增加COMMANDS文档，记录各种需要的命令
2026-06-08 批量处理pdf为png
2026-06-08 增加批量处理cleanPNG的脚本，批量生成layout
2026-06-08 修改表格合并逻辑
2026-06-08 更新技术要求文本块识别逻辑
2026-06-08 Revert "更新技术要求文本块识别逻辑"
    This reverts commit 8994cf771e83cda2e15e3bef0cf0deab36f9759c.
2026-06-08 新增过滤逻辑
2026-06-09 修复批处理cleanPNG逻辑
2026-06-11 更新command
2026-06-11 更新左右边框和左右上角小框处理逻辑
2026-06-11 更新COMMANDSS中的部分命令
2026-06-11 审计06数据，形成审计结果
2026-06-11 对裁切视图06分类算法，得到07
2026-06-11 生成07的时候考虑filter的逻辑，去掉reject的视图
2026-06-12 增加Built DrawingIR模块生成08数据
2026-06-12 增加gitignoreneo内容
2026-06-13 接入视图清洗项目的功能v1
2026-06-14 增加对辅助视图的处理功能
2026-06-14 增加08数据生成模块08.Multi-viewFeatureExtraction
2026-06-17 增加repair旁路，对去标注之后的图片进行修复
2026-06-17 增加保守的几何基元修复候选 MVP，强化连接性
2026-06-20 完成 extract-dimensions 的第一版 MVP，更新md文档
2026-07-03 新增model___screen
2026-07-03 修改ocr识别尺寸相关信息的prompt
2026-07-03 增加输出长度限制到1024防止被截断
2026-07-04 几何尺寸对应v1
2026-07-04 VLM绑定几何
2026-07-04 修复bug，幻觉
